jlg006728/electronic-design-contest/项目记忆.md

# 项目记忆

## 2026-07-25 V105 视频诊断修复上下文

- 当前活动工程仍为 `C:\Users\1\Desktop\ELECTRIC\mock_problem`，用户要求不修改活动 `empty.c`、不操作 CCS，只提供验证后的单文件备份。
- 当前诊断基线为 `ccs_project\medicine_car_2021f\backup_code\20260725_v104_first_junction_encoder_arm_empty.c`。
- 两段用户录像已复制到临时只读分析目录 `C:\Users\1\AppData\Local\Temp\codex_two_video_diag`，原视频保持不变。
- 诊断重点：V104 首路口在25 cm后允许任意单个10 ms帧的 `>=4` 路宽线触发，视频约30 fps无法观测所有10 ms瞬态；拟在V105中增加首路口约50 cm编码器武装、X4/X5同时有效和连续3个控制帧确认。

## 2026-07-08 靶纸变更：同心圆靶心 + 激光瞄准

- 新现场靶纸为白纸背景、红色/棕红色同心圆，顶部另有红色胶带；不能继续把“最大红色 blob 中心”当靶心，否则可能追到某段圆环或胶带。
- 推荐机械方案：激光笔固定在 PA14/PA17 二维云台的俯仰输出端，尽量与 OpenMV 镜头同高、同向、近距离并排，形成“摄像头看哪里，激光跟哪里”的同轴/近同轴结构；不要固定在车底盘或只固定在单独水平舵机上。
- 视觉优化方向：OpenMV 端保持现有 17 字节 UART 协议不变，输出 `cx/cy` 改为“同心圆靶心坐标”；当前优先识别最小有效红色圆环，其次才用霍夫同心圆，禁止回到最大红色 blob 策略；MSPM0 端继续按 `cx/cy` 闭环驱动双舵机，只收窄死区和降低近靶抖动。

## 2026-07-07 当前活动状态：OpenMV + 双舵机无电机测试

- 当前活动 CCS 文件：`C:\Users\1\Desktop\ELECTRIC\ele-car\empty.c`。
- 当前源码来源：`C:\Users\1\Desktop\电赛\ccs_project\openmv_test\20260705_171205_mspm0_openmv_static_aim_final_user_tuned.c`。
- 本次恢复时间戳副本：`C:\Users\1\Desktop\电赛\ccs_project\openmv_test\20260707_214537_restore_openmv_servo_no_motor_test.c`。
- 恢复前活动文件备份：`C:\Users\1\Desktop\电赛\ccs_project\openmv_test\20260707_214537_before_restore_openmv_servo_no_motor_empty.c`。
- 行为：只测试 OpenMV 串口回传与 PA14/PA17 双舵机追踪；电机禁用，PB4/STBY 保持 LOW。
- 接线：OpenMV P4 TX -> MSPM0 PA11 RX，OpenMV P5 RX <- MSPM0 PA10 TX，OpenMV GND/舵机 GND/MSPM0 GND 共地；PA14 水平舵机信号，PA17 俯仰舵机信号。
- 已执行 `gmake clean` + `gmake all` 编译通过；未自动烧录。

## 2026-07-08 当前活动状态：V23 A 点无线起步桥接测试优先版

- 当前活动 CCS 文件：`C:\Users\1\Desktop\ELECTRIC\ele-car\empty.c`。
- 当前时间戳源码：`C:\Users\1\Desktop\电赛\ccs_project\integration_test\20260708_202324_v23_a_start_gap_bridge_test_first.c`。
- 说明文件：`C:\Users\1\Desktop\电赛\ccs_project\integration_test\20260708_202324_v23_a_start_gap_bridge_test_first_readme.md`。
- 改前活动文件备份：`C:\Users\1\Desktop\电赛\ccs_project\integration_test\20260708_202324_before_v23_current_empty_backup.c`。
- 基底：V22 `20260707_212451_v22_b_stop_cda_prompt_full_line.c`。
- 新增：PB12/PB13/PB14/PB15 编码器输入、A 点无黑线启动桥接 `PHASE_START_GAP_BRIDGE=8U`、`g_start_gap_*` Watch 变量。
- 默认 `START_GAP_TEST_ONLY=1U`：首轮只测 A 点桥接和重捕线，不触发 B/C/D/A 任务点。桥接稳定后改为 `0U` 再测完整任务。
- 已执行 `gmake clean` + `gmake all` 编译通过；未自动烧录。

## 2026-07-07 报告材料状态：项目 AI 使用说明

- 主文件：`C:\Users\1\Desktop\电赛\设计报告_AI使用说明.md`。
- 当前推荐提交版本：`C:\Users\1\Desktop\电赛\设计报告_AI使用说明_20260707_222354_按反馈强化版.md`。
- 当前 PDF 版本：`C:\Users\1\Desktop\电赛\北京邮电大学校赛-蒋立果-设计报告.pdf`。
- 旧稿备份：`C:\Users\1\Desktop\电赛\设计报告_AI使用说明_20260707_220812_旧稿备份.md`。
- 过程简化版：`C:\Users\1\Desktop\电赛\设计报告_AI使用说明_20260707_220917_纪实简化版.md`。
- 当前版本重点：突出真实调试过程、人机协作、硬件问题、算法补偿、项目独立性、版本统计、已实现功能与未完成思路；已按用户反馈补充舵机 180 度限制下的分段换边预瞄方案、XDS110 调试器损坏导致专用场地验证不足的局限，以及后续每日夜间场地训练计划。

## 2026-07-07 当前集成状态：全程跟踪赛段预瞄偏置 V5

- 当前活动 CCS 文件：`C:\Users\1\Desktop\ELECTRIC\ele-car\empty.c`。
- 当前 MSPM0 源码：`C:\Users\1\Desktop\电赛\ccs_project\integration_test\20260707_145322_full_course_segment_aim_bias_v5.c`。
- 当前说明文件：`C:\Users\1\Desktop\电赛\ccs_project\integration_test\20260707_145322_full_course_segment_aim_bias_v5_readme.md`。
- MSPM0 改前备份：`C:\Users\1\Desktop\电赛\ccs_project\integration_test\20260707_145140_before_segment_aim_bias_empty.c`。
- 当前 OpenMV 脚本：`C:\Users\1\Desktop\电赛\ccs_project\openmv_test\20260707_144221_openmv_uart_stream_qvga_far_stable_v2.py`。
- 本版新增赛段预瞄：AB 正常/HOME；BC 丢目标时持续左偏 `2450us`；CD 丢目标时开始向右回到 HOME；DA 丢目标时持续右偏 `800us`。
- 当前赛段判断仍基于 `g_run_sample` 和 `MISSION_B/C/D/A` 采样点，尚未接入编码器距离。Watch 变量：`g_course_segment`、`g_segment_aim_x_us`。
- 已执行 CCS `gmake all` 编译通过；未自动烧录。

## 2026-07-07 当前集成状态：全程跟踪 + OpenMV QVGA 远距离稳定识别 V4

- 当前活动 CCS 文件：`C:\Users\1\Desktop\ELECTRIC\ele-car\empty.c`。
- 当前 MSPM0 源码：`C:\Users\1\Desktop\电赛\ccs_project\integration_test\20260707_144221_full_course_tracking_openmv_qvga_far_stable_v4.c`。
- 当前说明文件：`C:\Users\1\Desktop\电赛\ccs_project\integration_test\20260707_144221_full_course_tracking_openmv_qvga_far_stable_v4_readme.md`。
- MSPM0 改前备份：`C:\Users\1\Desktop\电赛\ccs_project\integration_test\20260707_144221_before_revert_openmv_qvga_far_stable_empty.c`。
- 当前 OpenMV 脚本：`C:\Users\1\Desktop\电赛\ccs_project\openmv_test\20260707_144221_openmv_uart_stream_qvga_far_stable_v2.py`。
- VGA 远距离版现场失败表现：OpenMV 红灯常亮、颜色异常、帧率卡、小车无法追踪。红灯在脚本中代表异常恢复，不是目标检测。
- 当前 V4 回到 QVGA 320x240，保留稳定帧率；通过适度放宽红色阈值、降低小目标门槛、增加宽高/密度过滤来改善远距离识别。
- MSPM0 同步回到 `IMG_WIDTH=320`、`IMG_HEIGHT=240`，并降低 `AIM_MIN_PIXELS=14U`，避免 OpenMV 识别到的小远目标被 MSPM0 丢弃。
- 已执行 OpenMV 脚本 `py_compile` 语法检查通过；CCS `gmake all` 编译通过；未自动烧录。

## 2026-07-07 当前集成状态：全程跟踪 + OpenMV VGA 远距离识别 V3

- 当前活动 CCS 文件：`C:\Users\1\Desktop\ELECTRIC\ele-car\empty.c`。
- 当前 MSPM0 源码：`C:\Users\1\Desktop\电赛\ccs_project\integration_test\20260707_143104_full_course_tracking_openmv_vga_far_red_v3.c`。
- 当前说明文件：`C:\Users\1\Desktop\电赛\ccs_project\integration_test\20260707_143104_full_course_tracking_openmv_vga_far_red_v3_readme.md`。
- MSPM0 改前备份：`C:\Users\1\Desktop\电赛\ccs_project\integration_test\20260707_143104_before_openmv_vga_far_detect_empty.c`。
- 当前 OpenMV 脚本：`C:\Users\1\Desktop\电赛\ccs_project\openmv_test\20260707_143104_openmv_uart_stream_vga_far_red_v1.py`。
- 本版优先解决“远一点 OpenMV 识别不到红色靶”：OpenMV 从 QVGA 改为 VGA，红色阈值增加远距离宽阈值，同时加入 blob 尺寸/密度过滤；MSPM0 同步 `IMG_WIDTH=640`、`IMG_HEIGHT=480`、`AIM_DEAD_X/Y=32/24`。
- 老师参考代码中没有直接可用的 OpenMV 视觉实现，本版借鉴其“传感器先稳定处理，再进入任务判断”的思路。
- 已执行 OpenMV 脚本 `py_compile` 语法检查通过；CCS `gmake all` 编译通过；未自动烧录。

## 2026-07-07 当前集成状态：全程跟踪主动搜索 V2

- 当前活动 CCS 文件：`C:\Users\1\Desktop\ELECTRIC\ele-car\empty.c`。
- 当前集成源码：`C:\Users\1\Desktop\电赛\ccs_project\integration_test\20260707_140926_full_course_tracking_active_search_v2.c`。
- 当前集成说明：`C:\Users\1\Desktop\电赛\ccs_project\integration_test\20260707_140926_full_course_tracking_active_search_v2_readme.md`。
- 改前备份：`C:\Users\1\Desktop\电赛\ccs_project\integration_test\20260707_140850_before_full_course_tracking_v2_empty.c`。
- V1 失败原因判断：V1 只是禁用 B/C/D/A 任务点，并没有重写全程运动追踪策略；原来的“转弯时云台不搜索”和“边缘目标拒绝追踪”在全程跟踪场景中过于保守。
- V2 改动：`AIM_X_DIVISOR=2`、`AIM_MAX_STEP_US=60`、`AIM_SEARCH_START_FRAMES=6U`、`AIM_SEARCH_STEP_US=35`、`FULL_TRACK_SEARCH_DURING_TURN=1U`、`FULL_TRACK_ACCEPT_EDGE_TARGET=1U`。
- 本版仍不做 B 点停车和 C/D/A 提示，目标是验证 OpenMV/云台在全程运行中能否更主动找回目标；已执行 CCS `gmake all` 编译通过；未自动烧录。

## 2026-07-07 当前集成状态：全程跟踪测试 V1

- 当前活动 CCS 文件：`C:\Users\1\Desktop\ELECTRIC\ele-car\empty.c`。
- 当前集成源码：`C:\Users\1\Desktop\电赛\ccs_project\integration_test\20260707_135432_full_course_tracking_only_v1.c`。
- 当前集成说明：`C:\Users\1\Desktop\电赛\ccs_project\integration_test\20260707_135432_full_course_tracking_only_v1_readme.md`。
- 改前备份：`C:\Users\1\Desktop\电赛\ccs_project\integration_test\20260707_135406_before_full_course_tracking_empty.c`。
- 当前推荐 OpenMV 脚本：`C:\Users\1\Desktop\电赛\ccs_project\openmv_test\20260706_163540_openmv_uart_stream_edge_guard_rot180.py`。
- 本版目标：先调试底盘循迹过程中的 OpenMV/双舵机全程追踪，暂不做 B 点停车、C/D/A 提示。
- 关键开关：`MISSION_ENABLE_B_AIM=0U`，`MISSION_ENABLE_POINT_PROMPTS=0U`。
- 本版仍保留全局运行超时停车和连续丢线停车保护；已执行 CCS `gmake all` 编译通过；未自动烧录。

## 2026-07-06 当前集成状态：B 点左预瞄 V3

- 当前活动 CCS 文件：`C:\Users\1\Desktop\ELECTRIC\ele-car\empty.c`。
- 当前集成源码：`C:\Users\1\Desktop\电赛\ccs_project\integration_test\20260706_220410_line_follow_b_aim_left_preset_v3.c`。
- 当前集成说明：`C:\Users\1\Desktop\电赛\ccs_project\integration_test\20260706_220410_line_follow_b_aim_left_preset_v3_readme.md`。
- 当前推荐 OpenMV 脚本：`C:\Users\1\Desktop\电赛\ccs_project\openmv_test\20260706_163540_openmv_uart_stream_edge_guard_rot180.py`。
- 本版用于修正 B 点找不到靶：B 点停车进入瞄准时，水平舵机先预置到 `MISSION_B_AIM_X_PRESET_US=2450U`，并清除旧循迹转弯状态、旧目标滤波和确认计数。
- 关键逻辑修正：B 点静态瞄准时 `aim_should_hold_for_chassis_turn()` 强制返回 false，避免停车后仍因残留 `g_turn_mode=1/2` 而禁止云台搜索目标。
- OpenMV 远距离抓不稳时，优先处理目标物面积、颜色阈值和 B 点预瞄方向；不要直接大幅降低 `MIN_RED_PIXELS/MIN_RED_AREA`，否则空场景误识别会更严重。
- 采购清单确认已有 LED/电阻/按键/电源模块，但没有明确采购蜂鸣器。声光提示当前只能先做“光”；若要“声”，建议新增有源蜂鸣器模块，接法为 `VCC -> 3.3V/5V(按模块)`, `GND -> 公共 GND`, `SIG -> 空闲 GPIO`，5V 或大电流蜂鸣器需加三极管/MOSFET 驱动。
- 已执行 CCS `gmake all` 编译通过；未自动烧录，烧录仍由用户手动完成。

## 2026-07-06 当前集成状态：稳定循迹 baseline + OpenMV/舵机

- 当前活动 CCS 文件：`C:\Users\1\Desktop\ELECTRIC\ele-car\empty.c`。
- 当前集成源码：`C:\Users\1\Desktop\电赛\ccs_project\integration_test\20260706_195125_stable_line_baseline_plus_openmv_servo.c`。
- 当前集成说明：`C:\Users\1\Desktop\电赛\ccs_project\integration_test\20260706_195125_stable_line_baseline_plus_openmv_servo_readme.md`。
- 用户指定基础：`C:\Users\1\Desktop\电赛\ccs_project\line_sensor_test\line_follow_sharp_turn_stable_baseline.c`。
- 循迹核心恢复为 baseline：`620/590` 基础 PWM、`430..850` 限幅、普通修正 `20/150`、急弯 `1800/8/380`、`LINE_CENTER_OFFSET=0`。
- 保留 OpenMV/舵机：`PA10/PA11` UART0，`PA14` 水平舵机，`PA17` 俯仰舵机，V9 丢目标搜索与边缘保护。
- 主循环仍为集成版 20ms 舵机节拍和约 90 秒运行时间，没有使用 baseline 原始约 12 秒阻塞测试循环。

## 2026-07-06 当前集成状态：V10 初始速度档

- 当前活动 CCS 文件：`C:\Users\1\Desktop\ELECTRIC\ele-car\empty.c`。
- 当前集成源码：`C:\Users\1\Desktop\电赛\ccs_project\integration_test\20260706_193630_line_follow_openmv_servo_v10_initial_speed.c`。
- 当前集成说明：`C:\Users\1\Desktop\电赛\ccs_project\integration_test\20260706_193630_line_follow_openmv_servo_v10_initial_speed_readme.md`。
- V10 是 V9 的降速版：保留 V9 OpenMV 丢目标搜索、边缘目标保护、舵机参数和 `LINE_CENTER_OFFSET=500`。
- 电机速度档：`PWM_LEFT_BASE_TICKS=605`、`PWM_RIGHT_BASE_TICKS=605`、`PWM_MIN_TICKS=430`、`PWM_MAX_TICKS=850`、`START_BOOST_SAMPLES=0`。
- 选择 `605/605` 的原因：早期稳定循迹基线为 `620/590`，平均速度约 `605`；当前机械/传感器中心已重新调过，先保持左右平衡，若现场偏转再单独微调左右 PWM。

## 2026-07-06 当前集成状态：V9 OpenMV 丢目标搜索

- 当前活动 CCS 文件：`C:\Users\1\Desktop\ELECTRIC\ele-car\empty.c`。
- 当前集成源码：`C:\Users\1\Desktop\电赛\ccs_project\integration_test\20260706_163540_line_follow_openmv_servo_high_torque_v9_lost_target_search.c`。
- 当前集成说明：`C:\Users\1\Desktop\电赛\ccs_project\integration_test\20260706_163540_line_follow_openmv_servo_high_torque_v9_lost_target_search_readme.md`。
- 当前推荐 OpenMV 脚本：`C:\Users\1\Desktop\电赛\ccs_project\openmv_test\20260706_163540_openmv_uart_stream_edge_guard_rot180.py`。
- V9 保留底盘居中参数：`LINE_CENTER_OFFSET=500`，暂不继续改该参数。
- V9 同步舵机参数：`SERVO_X_HOME_US=1600`、`SERVO_Y_HOME_US=1500`、`SERVO_X_MIN_US=350`、`SERVO_X_MAX_US=2650`、`SERVO_Y_MIN_US=500`、`SERVO_Y_MAX_US=2500`。
- V9 视觉行为：边缘目标拒绝直接追踪；目标丢失后先保持，急弯/丢线期间不扫，底盘恢复普通循迹后水平扫描找回目标；OpenMV 断链不再自动回 HOME。
- 新增观察状态：`g_aim_state=8` 边缘目标拒绝，`9` 丢目标搜索，`10` 底盘转弯保持。

## 2025 电赛 E 题小车

- 当前控制板：LP-MSPM0G3507。
- 电机驱动：TB6612，方向脚 `PB0/PB1/PB2/PB3`，`PB4` 为 `STBY`，PWM 为 `PA12/PA13`。
- 编码器：左轮 `PB12/PB13`，右轮 `PB14/PB15`。左轮前进计数为负，软件需取反；右轮前进计数为正。
- 当前 PWM 写入规则：逻辑占空比与 TIMG0 compare 反向，写入时使用 `compare = PWM_PERIOD - logical_duty_ticks`。
- 地面直行基准：`PWM_LEFT_BASE_TICKS = 665`，`PWM_RIGHT_BASE_TICKS = 635`，`PWM_CORR_LIMIT = 150`。
- 巡线红外当前有效接线：`S1/S2/S3/S4/S5/S6/S7 -> PB5/PB6/PB7/PA7/PA8/PB9/PB10`。
- `PA2~PA6` 在 LP-MSPM0G3507 板级默认不适合直接接杜邦线使用：官方原理图显示 `PA2-/PA3-/PA4-/PA5-/PA6-` 到 MCU 真实脚之间的 `R9/R10/R11/R15/R17` 为 `DNC`，且 MCU 端分别关联 `ROSC/LFXT/HFXT`。后续默认禁用这组脚，除非重新焊接并验证。
- `PA7` 不属于上述 DNC 晶振/ROSC 隔离组，当前作为巡线 S4 使用；若 PA7 异常，单独查排针/代码/接线，不和 PA2~PA6 混为一类。
- 当前稳定循迹基线：`C:\Users\1\Desktop\电赛\ccs_project\line_sensor_test\line_follow_sharp_turn_stable_baseline.c`。用户已验证圆角弯、S 弯、直角弯均可通过。

## 2026-06-29 校赛小车赛道题

- 新收到校赛题目 PDF：`D:\软件\xwechat_files\wxid_gdp9f9sm7a9u22_4c08\msg\file\2026-06\北邮2026电赛-小车赛道题目(1).pdf`。
- 新收到老师参考代码：
  - `D:\软件\xwechat_files\wxid_gdp9f9sm7a9u22_4c08\temp\RWTemp\2026-06\9e20f478899dc29eb19741386f9343c8\25E题底盘开源.zip`
  - `D:\软件\xwechat_files\wxid_gdp9f9sm7a9u22_4c08\temp\RWTemp\2026-06\9e20f478899dc29eb19741386f9343c8\24H题第四问开源.zip`
- 适配原则：不覆盖当前已验证循迹基线；先读题和参考代码，比较硬件、引脚、控制策略，再决定移植范围。
- 校赛路线文件：`C:\Users\1\Desktop\电赛\校赛研制路线.md`。
- 当前赛题优先级：先保底完成自动巡迹一圈停车、静止定点瞄准、A/B/C/D/A 联动，再做动态瞄准、绘制、四圈。
- 老师 25E 参考代码只借任务状态机/按键/蜂鸣器思想；灰度传感器、电机驱动、编码器参数不能直接搬到当前车。
- 下一步硬件/代码目标：新增 `PB11 START`、`PB8 MODE` 两个按键，做“按键启动版循迹”，保持现有循迹算法不变。
- 2026-07-02 舵机阶段最新状态：`PA3/PA4` 舵机方案作废；临时使用已验证可达的 `PA12` 做单舵机信号，舵机已确认可以正常动作。`PA12` 正式被 TB6612 `PWMA` 占用，只能作为独立测试脚，不能作为最终云台方案。
- 舵机供电当前可用测试法：TB6612 稳压板 `5V/GND` 只作为舵机电源，舵机信号仍由 MSPM0 输出；正式接双舵机/OpenMV 前必须做带载电压测试，并重新选择不与电机、巡线、UART、SWD 冲突的可达引脚。
- 2026-07-03 双舵机正式候选脚第一组：`PA14 -> X/水平舵机`，`PA17 -> Y/俯仰舵机`。循迹基线已验证运行正常，当前 `empty.c` 已再次恢复为 `PA14/PA17` 双舵机联动测试版并编译通过。
- 2026-07-03 双舵机 PA14/PA17 版发现软件卡死点：两个舵机同为 `1500us` 时旧代码会调用 `delay_us(0)`/`delay_cycles(0)`，导致 LED 只翻转一次后常亮、舵机不动。已生成修正版 `C:\Users\1\Desktop\电赛\ccs_project\servo_test\20260703_162351_dual_servo_pa14_pa17_no_zero_delay.c`，并更新活动工程 `empty.c`。
- 2026-07-03 双舵机最终候选脚已实测可用：`PA14 -> 水平舵机`，`PA17 -> 俯仰舵机`。OpenMV 当前测试使用 `PA10/PA11` UART0，测试代码保存为 `C:\Users\1\Desktop\电赛\ccs_project\openmv_test\20260703_162934_mspm0_openmv_full_selftest.c` 和 `20260703_162934_openmv_full_selftest.py`。
- 2026-07-03 OpenMV 自检已通过。下一阶段优先做静态“OpenMV 目标识别 + PA14/PA17 双舵机闭环瞄准”，暂不驱动电机。
- 2026-07-03 已生成静态闭环瞄准代码：`C:\Users\1\Desktop\电赛\ccs_project\openmv_test\20260703_204436_mspm0_openmv_servo_static_aim.c`。该版本使用 UART0 RX 中断接 OpenMV 帧，电机禁用，PA14/PA17 根据红色目标 `cx/cy` 温和追踪中心。
- 2026-07-03 OpenMV 静态瞄准版新增云台 HOME 机制：`PA14` 水平舵机、`PA17` 俯仰舵机上电后先回到 `SERVO_X_HOME_US/SERVO_Y_HOME_US`，当前默认 `1500/1500us`。普通三线舵机不能反读手动扭到的机械角度，后续需要通过 Watch 调整 `g_servo_x_home_us/g_servo_y_home_us` 找到正确回正脉宽，再固化进宏定义。
- 2026-07-03 OpenMV 当前为倒装安装，已新增 `20260703_213123_openmv_full_selftest_rot180.py`，通过 `sensor.set_hmirror(True)` + `sensor.set_vflip(True)` 等效 180 度旋转图像。MSPM0 舵机校准范围临时放宽到 `900..2100us`，当前默认 HOME 为 `X=1500us`、`Y=1250us`。
- 2026-07-03 OpenMV 云台校准：X 初始 `1500us` 已确认方向基本正确；Y 轴 HOME 改为 `750us` 起步。普通追踪下限 `SERVO_Y_MIN_US=750us`，但校准模式通过 `SERVO_Y_CALIB_MIN_US=0us` 允许继续向下探索，需现场避免舵机机械顶死。
- 2026-07-03 OpenMV 云台 HOME 已由现场校准固化为 `X=1500us`、`Y=580us`。当前 MSPM0 静态追踪测试版为 `20260703_214308_mspm0_openmv_servo_home_1500_580_track_test.c`，Y 轴正式追踪下限暂设 `500us`。
- 2026-07-03 OpenMV 静态追踪阶段发现一处调试开关风险：`g_servo_calibrate_enable=1` 会锁 HOME 并跳过追踪。当前正式追踪版 `20260703_214842_mspm0_openmv_track_ignore_calib_switch.c` 已改为忽略该开关并自动清零，避免校准模式遗留导致舵机不动。
- 2026-07-03 OpenMV/MSPM0 串口排查：现场出现 MSPM0 `g_omv_tx_requests` 增加但 `g_omv_rx_bytes=0`。已新增 OpenMV 主动串流版 `20260703_215935_openmv_uart_stream_rot180.py`，无需等待 MSPM0 命令，每约 100ms 主动从 UART3/P4 TX 发送颜色帧，用于隔离 P4->PA11 回传线/共地/跳线帽问题。
- 2026-07-04 OpenMV 追踪控制优化：当前最新静态追踪测试版为 `20260704_135927_mspm0_openmv_fast_stable_track.c` + `20260704_135927_openmv_uart_stream_fast_rot180.py`。改动包括 OpenMV 50ms 主动串流、MSPM0 关闭主动请求、坐标滤波、2 帧确认、小目标拒收、最大步长 45us、中心死区 20/16 像素。若目标越追越偏，优先改 `AIM_X_PULSE_SIGN/AIM_Y_PULSE_SIGN`，不要继续加速度。
- 2026-07-04 舵机机械方向改变并触及临界值后，当前 `empty.c` 已切回纯 HOME 校准版 `20260704_152456_mspm0_servo_home_recalibration.c`。默认 `X=1500/Y=1500`，校准范围 `500..2500us`，`g_aim_state=5`，不追踪 OpenMV。校准完成前不要使用追踪版。
- 2026-07-04 当前已从重新校准版切回 OpenMV 快速追踪版，HOME 固化为 `X=1500/Y=1500`。当前 MSPM0 文件 `20260704_153116_mspm0_openmv_fast_track_home_1500_1500.c`，OpenMV 端使用 `20260704_135927_openmv_uart_stream_fast_rot180.py`。

- 2026-07-04 OpenMV 停止/不亮灯的现场原因已确认：当时没有连接电池，仅 USB 供电导致掉电；不要继续按 OpenMV 脚本自停排查。当前 OpenMV + MSPM0 快速追踪版本保持 `HOME X=1500/Y=1500`，OpenMV 脚本为 `20260704_135927_openmv_uart_stream_fast_rot180.py`。左右追踪反向已在 MSPM0 端通过 `AIM_X_PULSE_SIGN=(-1)` 修正，Y 轴保持 `(-1)`。
- 2026-07-04 OpenMV 双舵机追踪进入平滑快速版：当前烧录文件 `C:\Users\1\Desktop\ELECTRIC\ele-car\empty.c`，时间戳源码 `20260704_160413_mspm0_openmv_smooth_fast_track_hold_loss.c`，OpenMV 脚本 `20260704_160413_openmv_uart_stream_smoother_fast_rot180.py`。核心策略是 OpenMV 25ms 主动串流，MSPM0 用 `g_servo_x/y_goal_us` 表示目标脉宽，实际 `g_servo_x/y_us` 每 20ms 平滑追向目标。`g_tracking_stop_reason` 用于判断停止原因：0 正常，1 帧超时，2 无目标，3 小目标过滤。普通三线 PWM 舵机不能靠代码实现左右各 360 度绝对位置控制。
- 2026-07-05 用户明确后续调试规则：Codex 只负责修改/生成代码并验证编译通过，不再自动烧录；烧录由用户手动完成。除非用户之后明确要求“帮我烧录/直接烧录”，否则不要运行 dslite/UniFlash 烧录命令。
- 2026-07-05 OpenMV/MSPM0 当前调试基线：MSPM0 活动工程仍为 `C:\Users\1\Desktop\ELECTRIC\ele-car\empty.c`，对应时间戳源码 `C:\Users\1\Desktop\电赛\ccs_project\openmv_test\20260705_145444_mspm0_openmv_joint_home_850_1500_link_diag.c`，HOME 为 `X=850us/Y=1500us`，`AIM_X_PULSE_SIGN=-1`、`AIM_Y_PULSE_SIGN=-1`，舵机运行限幅 `500..2500us`，并带 `g_diag_stage` 等诊断变量。OpenMV 端最新抗卡死脚本为 `C:\Users\1\Desktop\电赛\ccs_project\openmv_test\20260705_145746_openmv_uart_stream_watchdog_no_print_rot180.py`，说明文件为 `20260705_145746_openmv_watchdog_stream_readme.md`。后续继续遵守：Codex 只生成/编译验证代码，不自动烧录，除非用户明确要求直接烧录。
- 2026-07-05 OpenMV 卡死/舵机停动原因已确认：OpenMV `P4/UART3_TX` 接触不良。`P4` 接 MSPM0 `PA11/UART0_RX`，负责视觉结果回传。后续凡是出现 OpenMV 灯仍变化但 MSPM0/舵机不响应，优先检查 `P4`、`P5`、`GND` 接触和机械固定，再看 `g_omv_color_frame_count/g_omv_rx_bytes/g_diag_stage`，不要直接归因于 OpenMV 脚本卡死或供电问题。
- 2026-07-05 水平舵机左右范围不对称原因：当前 `SERVO_X_HOME_US=850U`，运行限幅 `500..2500us`，导致 HOME 左侧仅约 `350us`、右侧约 `1650us`。最终应机械调整水平舵机摆臂/云台，使 `1500us` 附近对应摄像头正前方，再使用对称软件范围。若不做机械调整，只能把 X 最大值限制到约 `1200us` 实现以 850us 为中心的窄范围对称，但会牺牲视野。
- 2026-07-05 15:24 当前 `C:\Users\1\Desktop\ELECTRIC\ele-car\empty.c` 已改为水平舵机 `SERVO_X_HOME_US=1500U` 的对称中位版，时间戳源码为 `C:\Users\1\Desktop\电赛\ccs_project\openmv_test\20260705_152451_mspm0_openmv_track_x_home_1500_symmetric.c`。X 轴软件范围仍为 `500..2500us`。现场下一步必须机械调整水平摆臂，使 OpenMV 镜头正前方对应 `1500us`，否则初始朝向会变化但这是预期现象。已编译通过，未自动烧录。
- 2026-07-05 17:03 当前 OpenMV 双舵机追踪版已临时删除“丢目标后慢慢回 HOME”逻辑。当前 `C:\Users\1\Desktop\ELECTRIC\ele-car\empty.c` 在没识别到目标时保持舵机最后位置，仅在长时间丢目标后重置坐标滤波；时间戳源码为 `C:\Users\1\Desktop\电赛\ccs_project\openmv_test\20260705_170304_mspm0_openmv_track_hold_when_target_lost.c`，说明文件为 `20260705_170304_hold_when_target_lost_readme.md`。已编译通过，未自动烧录。
- 2026-07-05 17:12 OpenMV 双舵机静态瞄准已进入用户现场调参最终版：当前活动文件为 `C:\Users\1\Desktop\ELECTRIC\ele-car\empty.c`，时间戳源码 `C:\Users\1\Desktop\电赛\ccs_project\openmv_test\20260705_171205_mspm0_openmv_static_aim_final_user_tuned.c`，说明文件 `20260705_171205_static_aim_final_user_tuned_readme.md`。关键参数：`SERVO_X_HOME_US=1600U`、`SERVO_Y_HOME_US=1500U`、`SERVO_X_MIN_US=800U`、`SERVO_X_MAX_US=2200U`、`SERVO_Y_MIN_US=500U`、`SERVO_Y_MAX_US=2500U`；丢目标后保持最后位置；已编译通过，未自动烧录。后续将该版本视为静态视觉瞄准基线。
- 2026-07-05 17:23 当前活动 `empty.c` 已切换为“循迹 + OpenMV 双舵机合并 V1”，时间戳源码 `C:\Users\1\Desktop\电赛\ccs_project\integration_test\20260705_172354_line_follow_openmv_servo_integration_v1.c`，说明文件 `20260705_172354_line_follow_openmv_servo_integration_v1_readme.md`。行为：上电云台回 HOME 后电机开始循迹，OpenMV 同时回传红色目标，PA14/PA17 云台追踪；运行约 90 秒停车，见线后连续丢线约 2 秒停车，启动无线时先直走找线。风险：舵机 PWM 仍是软件 20ms 脉冲，若循迹变差，下一版应考虑硬件舵机 PWM 或降低云台更新频率。已编译通过，未自动烧录。
- 2026-07-05 21:50 当前活动 `empty.c` 已切换为“循迹 + OpenMV 双舵机高扭矩合并 V2”，时间戳源码 `C:\Users\1\Desktop\电赛\ccs_project\integration_test\20260705_215010_line_follow_openmv_servo_high_torque_v2.c`，说明文件 `20260705_215010_line_follow_openmv_servo_high_torque_v2_readme.md`。V2 将电机基础 PWM 提高到 `720/690`，最小 PWM 提到 `520`，最大 PWM 提到 `1000`，并新增前 20 个控制周期约 400ms 的启动助推 `900/870`，变量 `g_start_boost_active` 可观察助推阶段。已编译通过，未自动烧录。
- 2026-07-05 21:55 当前活动 `empty.c` 为高扭矩合并 V3，时间戳源码 `C:\Users\1\Desktop\电赛\ccs_project\integration_test\20260705_215512_line_follow_openmv_servo_high_torque_v3_sharper_turn.c`。V3 只轻微加强急弯：`LINE_SHARP_ERROR=1600`、`LINE_SHARP_KP_DIVISOR=7`、`LINE_SHARP_CORR_LIMIT=430`；普通循迹参数不变以尽量保持直线稳定。已编译通过，未自动烧录。
- 2026-07-05 22:12 当前活动 `empty.c` 为高扭矩合并 V4“急弯降速受控版”，时间戳源码 `C:\Users\1\Desktop\电赛\ccs_project\integration_test\20260705_221203_line_follow_openmv_servo_high_torque_v4_controlled_turn.c`。V4 诊断依据：V2 在视频末端应右转却左转，V3 继续加强急弯导致原地打转；因此 V4 回到 V2 急弯参数，并新增急弯低速 `PWM_SHARP_LEFT_BASE_TICKS=620U`、`PWM_SHARP_RIGHT_BASE_TICKS=590U`、`PWM_SHARP_MAX_TICKS=850U`，普通/起步仍高扭矩。已编译通过且无警告，未自动烧录。
- 2026-07-05 22:22 当前活动 `empty.c` 为高扭矩合并 V5“直线基础平衡版”，时间戳源码 `C:\Users\1\Desktop\电赛\ccs_project\integration_test\20260705_222246_line_follow_openmv_servo_high_torque_v5_straight_balance.c`。V5 针对直线启动右偏，将普通基准 `720/690 -> 705/705`、启动助推 `900/870 -> 880/880`、急弯低速基准 `620/590 -> 605/605`。保留 V4 急弯降速受控策略。已编译通过，未自动烧录。
- 2026-07-05 22:32 当前活动 `empty.c` 为高扭矩合并 V6“红外输入下拉防悬空版”，时间戳源码 `C:\Users\1\Desktop\电赛\ccs_project\integration_test\20260705_223215_line_follow_openmv_servo_high_torque_v6_sensor_pulldown.c`。用户澄清 S5 异常来自传感器线松动，未改循迹方向；V6 仅将 7 路红外输入从 `DL_GPIO_RESISTOR_NONE` 改为 `DL_GPIO_RESISTOR_PULL_DOWN`，保留 V5/V4 其他策略。已编译通过，未自动烧录。每次拿起重放测试应按 RST，避免状态变量保留。
- 2026-07-06 15:58 当前活动 `empty.c` 为高扭矩合并 V7“加强普通居中纠偏版”，时间戳源码 `C:\Users\1\Desktop\电赛\ccs_project\integration_test\20260706_155859_line_follow_openmv_servo_high_torque_v7_center_correction.c`。针对前两圈可循迹但长期 S5 压线、第三圈直线偏出的问题，仅将普通纠偏 `LINE_KP_DIVISOR 20 -> 16`、`LINE_CORR_LIMIT 150 -> 190`，不改急弯/高扭矩/OpenMV。已编译通过，未自动烧录。
- 2026-07-06 16:08 当前活动 `empty.c` 为高扭矩合并 V8“S4/S5 中心偏置版”，时间戳源码 `C:\Users\1\Desktop\电赛\ccs_project\integration_test\20260706_160854_line_follow_openmv_servo_high_torque_v8_center_offset.c`。用户确认车身中心在 S4/S5 中间；V8 新增 `LINE_CENTER_OFFSET=500`，误差计算为 `(sum/count)-500`，使 S4+S5 同时压线时误差为 0。保留 V7/V6/V5/V4 其他策略。已编译通过，未自动烧录。
- 2026-07-07 15:16：全程 OpenMV 预偏转改为 V6 几何连续曲线。当前活动文件 `C:\Users\1\Desktop\ELECTRIC\ele-car\empty.c` 已编译通过，未自动烧录；时间戳源码为 `C:\Users\1\Desktop\电赛\ccs_project\integration_test\20260707_151637_full_course_geometric_preaim_curve_v6.c`，说明文件为 `C:\Users\1\Desktop\电赛\ccs_project\integration_test\20260707_151637_full_course_geometric_preaim_curve_v6_readme.md`。核心逻辑：A 点出发后云台左偏，保持到 BC 中点；之后按圈进度线性回正，到下一次 A 点面向正前方。OpenMV 稳定识别时做闭环追踪，丢目标时回到预偏转方向搜索。
- 2026-07-07 15:28：全程 OpenMV/小车任务升级为 V7 关键点停车强制校正。当前活动文件 `C:\Users\1\Desktop\ELECTRIC\ele-car\empty.c` 已编译通过，未自动烧录；时间戳源码为 `C:\Users\1\Desktop\电赛\ccs_project\integration_test\20260707_152852_course_point_stop_forced_aim_v7.c`，说明文件为 `C:\Users\1\Desktop\电赛\ccs_project\integration_test\20260707_152852_course_point_stop_forced_aim_v7_readme.md`。行为：B/C/D/下一次A 点按图纸 sample 估计到点，停车约 2s，并在停车入口强制设置云台水平角；停车期间 OpenMV 继续识别微调。重要限制：当前没有编码器闭环距离，点位仍由 `g_run_sample` 时间步估计，速度/电压/负重变化会导致停车点漂移。
- 2026-07-07 15:35：在 V7 关键点停车强制校正基础上加入 5V 有源蜂鸣器提示，形成 V8。当前活动文件 `C:\Users\1\Desktop\ELECTRIC\ele-car\empty.c` 已编译通过，未自动烧录；时间戳源码为 `C:\Users\1\Desktop\电赛\ccs_project\integration_test\20260707_153507_course_point_stop_buzzer_v8.c`，说明文件为 `C:\Users\1\Desktop\电赛\ccs_project\integration_test\20260707_153507_course_point_stop_buzzer_v8_readme.md`。蜂鸣器控制脚为 PB11 / `IOMUX_PINCM28`，推荐通过三极管/MOSFET 驱动 5V 有源蜂鸣器。鸣叫规则：上电1声，B点2声，瞄准稳定3声，C点4声，D点5声，A点1声，关键点停车未锁定目标则长响。
- 2026-07-07 15:44：用户实测 A->B 距离比地图多约 2/5，要求两版代码。已生成并编译通过：V9 不使用编码器、所有点位 sample 乘 `5/7`，文件 `C:\Users\1\Desktop\电赛\ccs_project\integration_test\20260707_153950_course_point_stop_buzzer_scaled_5over7_v9.c`，说明 `20260707_153950_course_point_stop_buzzer_scaled_5over7_v9_readme.md`；V10 使用编码器距离，文件 `C:\Users\1\Desktop\电赛\ccs_project\integration_test\20260707_154420_course_point_stop_buzzer_encoder_distance_v10.c`，说明 `20260707_154420_course_point_stop_buzzer_encoder_distance_v10_readme.md`。当前活动 `C:\Users\1\Desktop\ELECTRIC\ele-car\empty.c` 已切回 V9 并 clean rebuild 通过，方便先测 5/7 缩放版。V10 编码器接线使用 PB12/PB13/PB14/PB15，`ENCODER_EDGES_PER_CM=1471U` 只是按轮径估算，正式使用前必须现场校准。
- 2026-07-07 16:08：当前活动 `empty.c` 已更新为 V11，仍基于 V9 的 5/7 非编码器版本，不启用编码器。新预瞄策略：A->B->C->CD中点持续左偏，CD中点后回正到 A。关键参数：`COURSE_LEFT_HOLD_SAMPLE=559U`，`SERVO_X_MIN_US=300U`，`SERVO_X_MAX_US=2800U`，`COURSE_LEFT_TARGET_US=2750U`。时间戳源码：`C:\Users\1\Desktop\电赛\ccs_project\integration_test\20260707_160803_scaled_5over7_left_until_cd_mid_servo_wide_v11.c`，说明：`20260707_160803_scaled_5over7_left_until_cd_mid_servo_wide_v11_readme.md`。重要注意：`0us` 不是有效舵机脉宽，不能用来扩大角度；如果 2800us 导致顶死/抖动/发热，应回退到 `SERVO_X_MAX_US=2650U`、`COURSE_LEFT_TARGET_US=2550U`。
- 2026-07-07 16:22：当前活动 `empty.c` 已更新为 V13 主动预偏转修正版，仍为 5/7 非编码器版本。修正点：V12 只计算预瞄目标但未主动驱动舵机，导致 AB 段可能不左偏；V13 新增 `course_preaim_update_when_unlocked()`，未稳定锁定 OpenMV 目标时每帧驱动 `g_servo_x_us` 向课程预瞄角移动。保留 `COURSE_LEFT_HOLD_SAMPLE=559U`、`SERVO_X_MIN_US=350U`、`SERVO_X_MAX_US=2650U`、`COURSE_LEFT_TARGET_US=2550U`。源码：`C:\Users\1\Desktop\电赛\ccs_project\integration_test\20260707_162256_scaled_5over7_left_until_cd_mid_active_preaim_v13.c`，说明：`20260707_162256_scaled_5over7_left_until_cd_mid_active_preaim_v13_readme.md`。已编译通过，未自动烧录。
- 2026-07-07 16:45：当前活动 `empty.c` 已改为 V14，正式回到 V9 触发方式。V14 基于 `20260707_153950_course_point_stop_buzzer_scaled_5over7_v9.c`，只把回正起点从原 `330` 改为 `COURSE_LEFT_HOLD_SAMPLE=559U`，即 `0~559` 保持左偏，`559~913` 逐渐回正；保留 V9 的 `COURSE_PREAIM_STEP_US=35`、`COURSE_LEFT_TARGET_US=2550U` 和 `aim_search_for_lost_target()` 无目标触发预偏转方式，没有 V13 的 `course_preaim_update_when_unlocked()` 主动预偏转。源码：`C:\Users\1\Desktop\电赛\ccs_project\integration_test\20260707_164523_v9_trigger_left_until_cd_mid_v14.c`，说明：`20260707_164523_v9_trigger_left_until_cd_mid_v14_readme.md`。已编译通过，未自动烧录。
- 2026-07-07 16:58：当前活动 `empty.c` 已改为 V15。V15 基于 V14，按用户现场反馈将 ABCD 点位距离整体缩为当前 `4/5`：整圈 `COURSE_LAP_SAMPLES=731U`，左偏保持到 `COURSE_LEFT_HOLD_SAMPLE=447U`，B/C/D 点为 `162/366/528`，A 点等于整圈。AB 左偏速度保持 `COURSE_PREAIM_STEP_US=35`，新增右回速度 `COURSE_PREAIM_RETURN_STEP_US=70`，只在舵机向右回正时使用。源码：`C:\Users\1\Desktop\电赛\ccs_project\integration_test\20260707_165804_v15_shorter_distance_fast_return.c`，说明：`20260707_165804_v15_shorter_distance_fast_return_readme.md`。已编译通过，未自动烧录。
- 2026-07-07 17:11：当前活动 `empty.c` 已改为 V16。V16 不再尝试扩大左偏极限，保持 `COURSE_LEFT_TARGET_US=2550U`、`SERVO_X_MIN_US=350U`、`SERVO_X_MAX_US=2650U`；只把向右回正步长 `COURSE_PREAIM_RETURN_STEP_US` 从 `70` 提到 `140`。原因：用户现场确认左转约 180 度处是卡住状态，代码继续加脉宽会让舵机堵转，不能真正得到 270 度。若仍需要 270 度，必须重新安装舵机摆臂、确认舵机本体角度或更换 270 度舵机。源码：`C:\Users\1\Desktop\电赛\ccs_project\integration_test\20260707_171101_v16_faster_right_return_no_left_limit_push.c`，说明：`20260707_171101_v16_faster_right_return_no_left_limit_push_readme.md`。已编译通过，未自动烧录。
- 2026-07-07 17:15：当前活动 `empty.c` 已改为 V17，修正 V16 判断。用户确认水平舵机本体支持 270 度，左转不到 270 度是代码最大偏转范围限制。V17 将 `SERVO_X_MAX_US` 从 `2650U` 提到 `3050U`，`COURSE_LEFT_TARGET_US` 从 `2550U` 提到 `3000U`；保留 `SERVO_X_MIN_US=350U`、`SERVO_X_HOME_US=1600U`、`COURSE_PREAIM_STEP_US=35`、`COURSE_PREAIM_RETURN_STEP_US=140`。源码：`C:\Users\1\Desktop\电赛\ccs_project\integration_test\20260707_171538_v17_expand_left_servo_range.c`，说明：`20260707_171538_v17_expand_left_servo_range_readme.md`。已编译通过，未自动烧录。
- 2026-07-07 17:24：当前活动 `empty.c` 已回退到 V16 安全边界，时间戳源码 `C:\Users\1\Desktop\电赛\ccs_project\integration_test\20260707_172422_restore_v16_for_servo_strategy_review.c`，说明 `20260707_172422_restore_v16_for_servo_strategy_review_readme.md`。原因：用户重新判断水平云台机械可手动无限旋转，但程序控制可能只能稳定达到约 180 度。普通三线位置舵机无法靠软件“重置角度再相对转 90 度”，除非有编码器/角度反馈/机械复位；若是连续旋转舵机，则只能定时估算角度，精度不适合打靶。下一步建议先做水平舵机类型识别/扫角测试程序，再决定控制策略。
- 2026-07-07 17:34：当前活动 `empty.c` 已改为 V18 分段右侧预瞄曲线。核心策略：A/B 前保持左侧 `2550us`；B 点停车后继续走时，预瞄目标快速切到右侧接近 180 的 `700us`；B 到 CD 中点线性恢复到右 90 的 `1100us`；CD 中点到 D 再向右到 `700us`；D 到 A 回 HOME `1600us`。关键修正：`clamp_course_preaim_x()` 已允许右侧目标 `700us`，否则右侧预瞄会被旧 HOME~LEFT 限幅夹回 HOME。源码：`C:\Users\1\Desktop\电赛\ccs_project\integration_test\20260707_173433_v18_segmented_right_side_preaim.c`，说明：`20260707_173433_v18_segmented_right_side_preaim_readme.md`。已编译通过，未自动烧录。
- 2026-07-07 18:41：当前活动 `empty.c` 临时切换为 PB11 蜂鸣器隔离测试，不是循迹/OpenMV 集成代码。测试源码：`C:\Users\1\Desktop\电赛\ccs_project\buzzer_test\20260707_184130_pb11_buzzer_isolation_test.c`，说明：`20260707_184130_pb11_buzzer_isolation_test_readme.md`，改前 V18 备份：`C:\Users\1\Desktop\电赛\ccs_project\integration_test\20260707_184130_before_buzzer_test_current_v18_backup.c`。测试逻辑：PB11 高电平 1 秒、约 2kHz 方波 1 秒、低电平 1 秒循环，LED 同步提示。用于区分有源蜂鸣器、无源蜂鸣器、PB11 输出和外部驱动/接线问题。已编译通过，未自动烧录。
- 2026-07-07 19:05：当前活动 `empty.c` 已恢复为 V19 动态追踪集成版，来源为 V18 分段右侧预瞄，保留 PB11 蜂鸣器。蜂鸣器不响的真实原因已确认：正负极接反。V19 源码：`C:\Users\1\Desktop\电赛\ccs_project\integration_test\20260707_190540_v19_restore_dynamic_tracking_with_buzzer.c`，说明：`20260707_190540_v19_restore_dynamic_tracking_with_buzzer_readme.md`。已执行 `gmake clean` + `gmake all` 编译通过，未自动烧录。
- 2026-07-07 19:12：比赛场地确认中间直线段无黑线。当前活动 `empty.c` 已保持/回退为 V19，clean build 通过。不要使用未完成的 `20260707_191256_v20_line_gap_bridge_no_center_line.c`，该版开环桥接无法保证无线路段直线和对准。后续新场地正确方案应接入编码器：丢线进入桥接后用左右编码器差闭环保持直线，红外重新看到黑线并稳定若干帧后退出桥接。
- 2026-07-07 19:22：进一步确认：编码器桥接只能保证“沿进入桥接瞬间的航向走直”，不能单独保证“这条直线就是正确连接上下弯道的直线”。正确方案必须加入相位门控和入口姿态验证：只在预期断线窗口进入桥接，且进入前红外应显示弧线末端/边缘图案；桥接中用编码器差速保持直线；重新稳定捕到线后退出。当前活动 `empty.c` 仍为 V19，clean build 通过。
- 2026-07-07 19:26：当前活动 `empty.c` 已改为 V21 最终版编码器门控桥接，源码 `C:\Users\1\Desktop\电赛\ccs_project\integration_test\20260707_192609_v21_final_encoder_gated_gap_bridge.c`，说明 `20260707_192609_v21_final_encoder_gated_gap_bridge_readme.md`。V21 保留 V19 动态追踪/蜂鸣器/V18 分段预瞄，新增 PB12/PB13/PB14/PB15 编码器输入和无线路段桥接状态机。桥接只在 B/D 预期断线窗口且弧线末端边缘误差满足时进入；桥接中用左右编码器差闭环保持直线；红外稳定重捕线 3 帧后退出；超时 220 帧未捕线则交给丢线停车保护。已 clean build 编译通过，未自动烧录。
- 2026-07-07 20:00：当前活动 `empty.c` 临时切换为电机不动红外传感器静态测试程序，源码 `C:\Users\1\Desktop\电赛\ccs_project\line_sensor_test\20260707_200036_static_line_sensor_motor_off_test.c`，说明 `20260707_200036_static_line_sensor_motor_off_test_readme.md`，改前备份 `20260707_200036_before_sensor_static_test_current_backup.c`。该程序不初始化 PWM，PB0/PB1/PB2/PB3/PB4 全 LOW，TB6612 STBY LOW，电机不会动；用于在比赛场地检查 S1~S7 原始输入和黑线识别极性。已 clean build 编译通过，未自动烧录。
- 2026-07-07 21:24：当前活动 `empty.c` 已切换为 V22，基于 V19，假定全程有黑线，不考虑断线桥接。V22 按题目任务点调整：B 点停车；C/D/A 不停车，只声光提示。源码：`C:\Users\1\Desktop\电赛\ccs_project\integration_test\20260707_212451_v22_b_stop_cda_prompt_full_line.c`，说明：`20260707_212451_v22_b_stop_cda_prompt_full_line_readme.md`。已 clean build 编译通过，未自动烧录。
- 2026-07-09：OpenMV 视觉目标定位从“红色圆环颜色识别”切换为“黑色外框中心检测”。红色圆环现场颜色过淡、线条过细，颜色阈值不稳定；黑框方案已实测可用。当前 OpenMV 测试脚本为 `ccs_project/openmv_test/20260709_black_frame_center_test.py`，已烧录到 `E:\main.py`。成功反馈为 `best=blob`，中心约 `cx=131~141`、`cy=131~132`，帧率约 `57fps`。后续集成时优先让 OpenMV 回传黑框中心坐标给 MSPM0 云台控制。
- 2026-07-09：OpenMV 当前已升级为黑框中心 + UART 主动上报 + watchdog/异常自恢复集成版，脚本 `ccs_project/openmv_test/20260709_black_frame_uart_stream_watchdog.py` 已烧录到 `E:\main.py`。UART 17 字节帧协议保持原样，`TYPE_COLOR=3`、`FLAG_TARGET_DETECTED`、`cx/cy=-1` 未检测语义均不变；MSPM0 端原则上可沿用原 OpenMV 目标帧解析，只是 `cx/cy` 现在来自黑框四角平均中心而不是红色目标中心。当前 `ENABLE_DEBUG_PRINT=True` 便于现场观察，正式上车若担心 USB 打印开销可改回 `False`。
- 2026-07-09：黑框 UART 集成版已做泛化增强并重新烧录。主要改动：黑色阈值放宽、`find_rects()` 阈值降低、blob 合并距离增至 `30`、候选框尺寸/宽高比/密度范围放宽，新增 `GROUP` 多黑块组合兜底和 `TARGET_HOLD_FRAMES=8` 短时保持。调试输出新增 `hold=` 字段；若现场 `target=1` 但 `hold` 递减，说明当前靠上一帧目标临时保持。
## 2026-07-08 当前活动状态：V24 A 点无线桥接首测修正版

- 当前活动 CCS 文件：`C:\Users\1\Desktop\ELECTRIC\ele-car\empty.c`。
- 当前时间戳源码：`C:\Users\1\Desktop\电赛\ccs_project\integration_test\20260708_203751_v24_a_start_gap_direct_bridge_reacquire.c`。
- 当前说明文件：`C:\Users\1\Desktop\电赛\ccs_project\integration_test\20260708_203751_v24_a_start_gap_direct_bridge_reacquire_readme.md`。
- 基底：V23 A 点无线起步桥接测试版；V23 的基底是 V22 全线任务版。
- 当前目标：先解决 A 点起步完全看不到黑线时的桥接重捕线，不直接测试完整任务。
- 关键开关：`START_GAP_TEST_ONLY=1U`，B/C/D/A 任务点暂时关闭；`START_GAP_USE_ENCODER_BALANCE=0U`，编码器计数保留但暂不参与桥接控制。
- 状态提示：上电 1 声；进入 A 点无线桥接 2 声；成功重捕线 3 声。
- 新增相位：`PHASE_START_GAP_BRIDGE=8U` 表示无线桥接；`PHASE_START_GAP_ALIGN=9U` 表示重捕线后的短暂稳定；`PHASE_LINE_RUN=2U` 表示正常循迹。
- 编译状态：已执行 CCS `gmake clean` + `gmake all`，编译通过；未自动烧录。
## 2026-07-08 当前活动状态：V25 固定赛道混合控制 A 点捕线版

- 当前活动 CCS 文件：`C:\Users\1\Desktop\ELECTRIC\ele-car\empty.c`。
- 当前时间戳源码：`C:\Users\1\Desktop\电赛\ccs_project\integration_test\20260708_205429_v25_fixed_course_start_gap_capture.c`。
- 当前说明文件：`C:\Users\1\Desktop\电赛\ccs_project\integration_test\20260708_205429_v25_fixed_course_start_gap_capture_readme.md`。
- 修改前 V24 备份：`C:\Users\1\Desktop\电赛\ccs_project\integration_test\20260708_205429_before_v25_current_v24_backup.c`。
- 当前策略：固定赛道混合控制。无线段按赛道定制桥接，有线段用红外循迹纠偏，后续任务点逐步从 `g_run_sample` 切换为编码器里程。
- 当前第一目标：只验证 A 点无线起步、轻微右漂修正、捕线锁中心和进入普通循迹；`START_GAP_TEST_ONLY=1U` 仍保持开启。
- 新增状态：`PHASE_START_GAP_CAPTURE=9U`，用于看到黑线后低速捕线；只有中心锁定连续 5 帧后才进入 `PHASE_LINE_RUN=2U`。
- 当前关键参数：桥接 trim 为 `-8/+8`；捕线 PWM 为 `370/370`；中心锁定误差阈值为 `1200`；中心锁定帧数为 `5`。
- 编译状态：已执行 CCS `gmake clean` + `gmake all`，编译通过；未自动烧录。
## 2026-07-08 当前活动状态：V26 A 点桥接见线即循迹版

- 当前活动 CCS 文件：`C:\Users\1\Desktop\ELECTRIC\ele-car\empty.c`。
- 当前时间戳源码：`C:\Users\1\Desktop\电赛\ccs_project\integration_test\20260708_210707_v26_start_gap_any_sensor_reacquire.c`。
- 当前说明文件：`C:\Users\1\Desktop\电赛\ccs_project\integration_test\20260708_210707_v26_start_gap_any_sensor_reacquire_readme.md`。
- 修改前 V25 备份：`C:\Users\1\Desktop\电赛\ccs_project\integration_test\20260708_210707_before_v26_current_v25_backup.c`。
- 当前第一目标：A 点无线桥接到弯道入口后，只要任意红外传感器识别到黑线，立即切入普通循迹。
- 当前有效路径：`PHASE_START_GAP_BRIDGE=8U -> PHASE_LINE_RUN=2U`。
- 关键参数：`START_GAP_REACQUIRE_FRAMES=1U`，桥接 trim 仍为 `-8/+8`，`START_GAP_TEST_ONLY=1U`。
- 注意：V25 的 `PHASE_START_GAP_CAPTURE` 捕线代码暂时保留但不再由桥接入口触发；若 V26 验证成功，后续可清理该未使用路径。
- 编译状态：已执行 CCS `gmake clean` + `gmake all`，编译通过；未自动烧录。
## 2026-07-08 当前活动状态：V27 状态切换强制停 2 秒调试版

- 当前活动 CCS 文件：`C:\Users\1\Desktop\ELECTRIC\ele-car\empty.c`。
- 当前时间戳源码：`C:\Users\1\Desktop\电赛\ccs_project\integration_test\20260708_215716_v27_state_switch_hold_2s_debug.c`。
- 当前说明文件：`C:\Users\1\Desktop\电赛\ccs_project\integration_test\20260708_215716_v27_state_switch_hold_2s_debug_readme.md`。
- 修改前 V26 备份：`C:\Users\1\Desktop\电赛\ccs_project\integration_test\20260708_215716_before_v27_current_v26_backup.c`。
- 当前目标：让 A 点桥接、上电直接循迹、桥接重捕线进入循迹三个状态切换变得肉眼可见。
- 红外极性已现场确认：白底/白线 0V，黑线 3.3V，`LINE_BLACK_IS_HIGH=1` 正确。
- 新行为：状态切换时强制停车约 2 秒并播放区分蜂鸣。2 声表示进入桥接；4 声表示上电直接判断有线；3 声表示桥接重捕线进入普通循迹。
- 新 Watch：`g_state_switch_reason`、`g_state_switch_hold_event_count`、`g_state_switch_hold_frames_total`。
- 编译状态：已执行 CCS `gmake clean` + `gmake all`，编译通过；未自动烧录。
## 2026-07-08 当前活动状态：V28 状态切换调试清理版

- 当前活动 CCS 文件：`C:\Users\1\Desktop\ELECTRIC\ele-car\empty.c`。
- 当前时间戳源码：`C:\Users\1\Desktop\电赛\ccs_project\integration_test\20260708_220234_v28_state_switch_debug_cleanup.c`。
- 当前说明文件：`C:\Users\1\Desktop\电赛\ccs_project\integration_test\20260708_220234_v28_state_switch_debug_cleanup_readme.md`。
- 修改前 V27 备份：`C:\Users\1\Desktop\电赛\ccs_project\integration_test\20260708_220234_before_v28_current_v27_backup.c`。
- 当前有效底盘路径：A 点无线桥接 `PHASE_START_GAP_BRIDGE=8U`，任意红外看到黑线后立即进入普通循迹 `PHASE_LINE_RUN=2U`。
- 已清理：V25 遗留的 `PHASE_START_GAP_CAPTURE` 捕线状态和相关函数/变量，不再存在，避免后续误读。
- 状态切换提示：进入桥接停 2 秒响 2 声；上电直接有线停 2 秒响 4 声；桥接重捕线停 2 秒响 3 声；停车期间 PA15 LED 闪烁。
- 启动快照 Watch：`g_startup_line_valid_snapshot`、`g_startup_line_raw_mask_snapshot`、`g_startup_line_active_count_snapshot`、`g_startup_line_error_snapshot`。
- 编译状态：已执行 CCS `gmake clean` + `gmake all`，编译通过；未自动烧录。
## 2026-07-08 当前活动状态：V29 参考代码增强版

- 当前活动 CCS 文件：`C:\Users\1\Desktop\ELECTRIC\ele-car\empty.c`。
- 当前时间戳源码：`C:\Users\1\Desktop\电赛\ccs_project\integration_test\20260708_221546_v29_reference_enhanced_line_encoder.c`。
- 当前说明文件：`C:\Users\1\Desktop\电赛\ccs_project\integration_test\20260708_221546_v29_reference_enhanced_line_encoder_readme.md`。
- 修改前 V28 备份：`C:\Users\1\Desktop\电赛\ccs_project\integration_test\20260708_221546_before_v29_current_v28_backup.c`。
- 硬件接口保持不变：TB6612、7 路红外、编码器、OpenMV、舵机、蜂鸣器引脚均未改动。
- 参考代码学习点：25E 底盘代码使用 200Hz 定时任务、灰度多采样、编码器距离积分、任务状态机和电机速度 PID；直角弯由灰度触发、编码器距离和强制转向共同完成。
- 本版已移植低风险增强：红外 5 次采样 OR/AND/last 记录、黑线锁存、编码器累计前进量/左右差 Watch。
- 当前桥接触发：`g_line_valid != 0 || g_line_seen_latched != 0`，仍然是任意红外见黑线后进入普通循迹，但增加运动中短脉冲捕获能力。
- 新增 Watch：`g_line_raw_high_last_mask`、`g_line_raw_high_or_mask`、`g_line_raw_high_and_mask`、`g_line_seen_latched`、`g_line_seen_latch_frames`、`g_line_seen_event_count`、`g_encoder_avg_forward_total`、`g_encoder_diff_forward_total`。
- 编译状态：已执行 CCS `gmake clean` + `gmake all`，编译通过；未自动烧录。
## 2026-07-08 当前活动状态：V30 参考代码架构底盘重写版

- 当前活动 CCS 文件：`C:\Users\1\Desktop\ELECTRIC\ele-car\empty.c`。
- 当前时间戳源码：`C:\Users\1\Desktop\电赛\ccs_project\integration_test\20260708_223500_v30_reference_style_chassis_rewrite.c`。
- 当前说明文件：`C:\Users\1\Desktop\电赛\ccs_project\integration_test\20260708_223500_v30_reference_style_chassis_rewrite_readme.md`。
- 修改前 V29 备份：`C:\Users\1\Desktop\电赛\ccs_project\integration_test\20260708_223500_before_v30_current_v29_backup.c`。
- 当前策略：不再延续旧集成版补丁路线，底盘代码按 25E 参考代码思想重写。
- 当前控制模块：红外多采样、编码器累计前进量、底盘状态机、直接双电机差速 PWM、蜂鸣/LED 状态提示。
- 当前未包含：OpenMV 串口、PA14/PA17 舵机、B/C/D/A 任务点、视觉瞄准。它们暂时从底盘调试中隔离。
- 当前状态机：白底启动进 `PHASE_START_GAP_BRIDGE`；黑线启动进 `PHASE_LINE_RUN`；桥接重捕线后进 `PHASE_LINE_RUN`；循迹丢线后进 `PHASE_FORCE_TURN`；保护停车为 `PHASE_STOP`。
- 当前关键 PWM：`520/500` 普通循迹，`500/520` 桥接，`330..760` 限幅。若车速或转向不合适，优先调这些参数。
- 编译状态：已执行 CCS `gmake clean` + `gmake all`，编译通过且无警告；未自动烧录。
## 2026-07-08 输出规则更新：不再为每次代码修改生成 readme 文件

- 用户明确要求：后续每次代码修改后，不要再额外写 readme 文件。
- 保留规则：代码仍需生成时间戳源码副本，并替换当前 CCS 活动文件 `C:\Users\1\Desktop\ELECTRIC\ele-car\empty.c`。
- 改动说明、测试步骤、Watch 变量、蜂鸣含义和调参规则，直接在聊天回复中输出。
- 已存在的历史 readme 文件不删除，作为历史记录保留。
## 2026-07-09 当前底盘恢复基线

- 当前 CCS 活动文件：`C:\Users\1\Desktop\ELECTRIC\ele-car\empty.c`。
- 当前时间戳源码：`C:\Users\1\Desktop\电赛\ccs_project\integration_test\20260709_002220_v31_stable_chassis_rescue.c`。
- 当前目标：第一步只恢复稳定底盘，验证红外能变、电机能跑、A 点无黑线桥接后任意红外见黑线即可进入普通循迹。
- 当前版本不包含 OpenMV、舵机、ABCD 任务点、编码器距离层。
- 当前版本已编译通过，未自动烧录。
- 后续路线：V31 现场确认通过后，再做第二步编码器距离层；不要再直接整体重写底层。
## 2026-07-09 当前活动代码改为红外阈值测试

- 当前 CCS 活动文件：`C:\Users\1\Desktop\ELECTRIC\ele-car\empty.c`。
- 当前时间戳源码：`C:\Users\1\Desktop\电赛\ccs_project\integration_test\20260709_184549_v32_motor_off_line_threshold_test.c`。
- 当前版本用途：电机禁用，只测试 7 路红外 DO 和软件阈值。
- 当前红外软件判定：每路连续采样 9 次，至少 5 次为高电平才判定为黑线。
- 当前电机状态：PB4/STBY 低，PWM 为 0，小车不会运动。
- 注意：数字红外模块的真实黑白阈值在模块比较器/电位器上，代码只能做多采样判定，不能改变 DO 的硬件翻转点。
## 2026-07-09 红外模块当前极性

- 现场确认：红外模块 DO 为白色高电平、黑线低电平。
- 当前活动代码已改为：`LINE_BLACK_IS_HIGH=0`。
- 当前时间戳源码：`C:\Users\1\Desktop\电赛\ccs_project\integration_test\20260709_185819_v33_motor_off_line_polarity_invert.c`。
- 后续所有循迹/桥接/任务代码都应沿用该极性，否则会出现白底被当成黑线、黑线被当成白底的问题。
## 2026-07-09 红外最终约定：白亮黑灭

- 用户明确要求：红外传感器沿用硬件标准“白色亮、黑色灭”，后续只修改后面的循迹程序逻辑。
- 当前活动源码：`C:\Users\1\Desktop\电赛\ccs_project\integration_test\20260709_192943_v34_motor_off_sensor_raw_standard.c`。
- 当前 Watch 约定：
  - `g_s1~g_s7`：原始传感器高电平结果，白色为 1，黑线为 0。
  - `g_line_raw_mask`：原始白色/高电平掩码。
  - `g_black_line_mask`：反相后的黑线掩码，后续循迹算法应使用它。
- 后续循迹代码不要再要求“黑线亮”；应在算法内部使用 `g_black_line_mask` 或等价反相逻辑。
## 2026-07-09 当前活动代码：电机启用，黑线低电平循迹

- 当前活动文件：`C:\Users\1\Desktop\ELECTRIC\ele-car\empty.c`。
- 当前时间戳源码：`C:\Users\1\Desktop\电赛\ccs_project\integration_test\20260709_193152_v35_motor_enabled_black_low_line_follow.c`。
- 当前红外标准不变：`g_s1~g_s7` 白色为 1，黑线为 0。
- 当前循迹输入：`g_black_line_mask = (~g_line_raw_mask) & 0x7F`，即黑线低电平被反相后用于算法。
- 当前电机已启用，PB4/STBY 高，PWM 恢复 V31 稳定基线：左 620、右 590、最小 430、最大 850。
- 当前版本仍不包含 OpenMV、舵机、ABCD 任务点、编码器距离层。
## 2026-07-09 当前活动代码：V36 降速与桥接修偏

- 当前活动文件：`C:\Users\1\Desktop\ELECTRIC\ele-car\empty.c`。
- 当前时间戳源码：`C:\Users\1\Desktop\电赛\ccs_project\integration_test\20260709_200431_v36_slow_bridge_left_drift_fix.c`。
- 普通循迹 PWM：左 540、右 515、最小 380、最大 760。
- 白底/无线桥接 PWM：左 560、右 500，用于抵消白底启动固定左歪。
- 红外标准仍为白色 1、黑线 0；循迹算法使用 `g_black_line_mask`。
## 2026-07-09 当前活动代码：V37 低速减右偏

- 当前活动文件：`C:\Users\1\Desktop\ELECTRIC\ele-car\empty.c`。
- 当前时间戳源码：`C:\Users\1\Desktop\电赛\ccs_project\integration_test\20260709_201351_v37_slower_reduce_right_bias.c`。
- 普通循迹 PWM：左 500、右 485、最小 350、最大 700。
- 白底/无线桥接 PWM：左 520、右 485。
- 目的：相比 V36 进一步降速，并减小桥接阶段的右偏。
## 2026-07-09 当前活动代码：V38 重捕线不停车

- 当前活动文件：`C:\Users\1\Desktop\ELECTRIC\ele-car\empty.c`。
- 当前时间戳源码：`C:\Users\1\Desktop\电赛\ccs_project\integration_test\20260709_202319_v38_no_stop_reacquire_bc_connect.c`。
- 目的：改善 A/AB 白底桥接到 BC 有线段的衔接。
- 关键改动：桥接阶段看到黑线后不再原地停 2 秒，不再滴 3 声，直接进入 `PHASE_LINE_RUN` 并继续循迹。
- 速度沿用 V37：普通循迹左 500、右 485；桥接左 520、右 485。
## 2026-07-09 当前活动代码：V39 半速传感器验证

- 当前活动文件：`C:\Users\1\Desktop\ELECTRIC\ele-car\empty.c`。
- 当前时间戳源码：`C:\Users\1\Desktop\电赛\ccs_project\integration_test\20260709_203216_v39_half_speed_right_bias_sensor_check.c`。
- 普通循迹 PWM：左 250、右 242、最小 180、最大 350。
- 白底/无线桥接 PWM：左 245、右 250，用于低速下纠正桥接右偏。
- 当前目的：先用半速确认经过黑线时红外是否会灭/`g_sx_high_count` 是否下降；若仍不变，问题更可能在模块阈值、传感器高度/角度、黑线反射率或车身实际压线位置。

## 2026-07-09 当前活动代码：V40 历史红外 + 编码器桥接 + OpenMV 舵机循迹测试

- 当前 CCS 活动文件：`C:\Users\1\Desktop\ELECTRIC\ele-car\empty.c`。
- 当前时间戳源码：`C:\Users\1\Desktop\电赛\ccs_project\integration_test\20260709_205326_v40_history_encoder_openmv_line_test.c`。
- 修改前备份：`C:\Users\1\Desktop\电赛\ccs_project\integration_test\20260709_205326_before_v40_history_encoder_openmv_line_test_empty.c`。
- 当前版本仍只测试循迹，不包含 ABCD 任务点；已加入 OpenMV UART0 与 PA14/PA17 双舵机并行追踪。
- 红外标准保持不变：白色为高电平/1/灯亮，黑线为低电平/0/灯灭；算法内部使用 `g_black_line_mask = (~g_line_raw_mask) & 0x7F`。
- 新增三帧红外历史：`g_line_history0/1/2` 与 `g_line_history_or_mask`。桥接阶段只要历史窗口内出现可用黑线位，即进入循迹。
- 循迹退出条件改为当前帧无可用黑线：`g_line_detect_mask == 0`，然后回到桥接阶段。
- 关键保护：7 路红外全部熄灭不再当作“完美居中黑线”，而是 `g_sensor_all_low_abnormal=1`，连续出现会保护停车，防止拿起小车后轮子疯转。
- 桥接阶段启用编码器差速修偏，沿用方向约定：左轮前进量取反，右轮前进量为正；修正量看 `g_encoder_diff_forward_total` 与 `g_start_gap_encoder_correction`。
- 编译状态：已执行 CCS clean build + build，编译通过且无 C 代码警告；未自动烧录。
## 2026-07-09 当前活动代码：V45 编码器 PI 无线桥接直行

- 当前 CCS 活动文件：`C:\Users\1\Desktop\ELECTRIC\ele-car\empty.c`。
- 当前时间戳源码：`C:\Users\1\Desktop\电赛\ccs_project\integration_test\20260709_220609_v45_encoder_pi_bridge_stronger_turn.c`。
- 当前阶段目标：只测底盘循迹、A/AB 无黑线桥接、重捕黑线、OpenMV/PA14/PA17 舵机并行追踪；暂不包含 B/C/D/A 任务点。
- 红外最终标准保持不变：白色为高电平/1/灯亮，黑线为低电平/0/灯灭；循迹算法内部使用 `g_black_line_mask = (~g_line_raw_mask) & 0x7F`。
- 无黑线桥接稳定结论：今后默认使用编码器闭环维护直行，不再把左右 PWM 相等当作直行依据。V45 使用每帧编码器增量差做快速修正、累计左右里程差做慢速修正，并加入小幅右偏补偿。
- V45 桥接关键参数：`START_GAP_LEFT_TRIM_TICKS=-8`、`START_GAP_RIGHT_TRIM_TICKS=8`、`START_GAP_ENCODER_DELTA_KP_DIV=2`、`START_GAP_ENCODER_DISTANCE_KI_DIV=64`、`START_GAP_ENCODER_LIMIT=95`、`START_GAP_ENCODER_SLEW_LIMIT=18`。
- V45 循迹转弯增强：`LINE_KP_DIVISOR=16`、`LINE_CORR_LIMIT=190`、`LINE_SHARP_KP_DIVISOR=6`、`LINE_SHARP_CORR_LIMIT=450`。
- 编译状态：2026-07-09 22:06 已 clean build + build 通过，未自动烧录。
## 2026-07-09 当前活动代码：V46 编码器 PID 桥接 + 黑线脉冲入口

- 当前 CCS 活动文件：`C:\Users\1\Desktop\ELECTRIC\ele-car\empty.c`。
- 当前时间戳源码：`C:\Users\1\Desktop\电赛\ccs_project\integration_test\20260709_222223_v46_encoder_pid_pulse_line_entry.c`。
- 当前版本用途：底盘循迹测试 + A/AB 无黑线桥接 + 重捕黑线 + OpenMV/PA14/PA17 舵机并行追踪；暂不包含 B/C/D/A 任务点。
- 直行桥接当前采用 PID 意义下的三项：
  - P：左右累计前进距离差。
  - I：累计距离误差的慢补偿。
  - D：每帧左右编码器增量差。
- 红外入线当前采用双层 mask：
  - `g_line_detect_mask`：9 次采样多数判定，较稳，用于正常循迹位置计算。
  - `g_line_entry_mask`：多数判定 OR 黑线脉冲捕获，用于桥接阶段快速切入循迹。
- 现场已知问题处理方向：若传感器模块灯能响应但小车不进循迹，优先检查 `g_line_entry_mask/g_line_black_pulse_mask` 逻辑，不要先怀疑红外硬件。
- 编译状态：2026-07-09 22:22 已 clean build + build 通过，未自动烧录。
## 2026-07-09 当前活动代码：V47 确认入线 + PID 桥接

- 当前 CCS 活动文件：`C:\Users\1\Desktop\ELECTRIC\ele-car\empty.c`。
- 当前时间戳源码：`C:\Users\1\Desktop\电赛\ccs_project\integration_test\20260709_223358_v47_confirmed_line_entry_pid_bridge.c`。
- 当前版本用途：底盘循迹测试 + A/AB 无黑线桥接 + 确认重捕黑线 + OpenMV/PA14/PA17 舵机并行追踪；暂不包含 B/C/D/A 任务点。
- V47 入线原则：多数判定直接有效；单次脉冲只作为候选，必须最近 4 帧至少 2 帧出现才允许切入循迹。
- V47 LED/蜂鸣语义：桥接 LED 灭并响 2 声；确认入线 LED 常亮并响 3 声；假脉冲候选不响不亮；保护停车长响一次。
- V47 桥接右偏补偿：`START_GAP_LEFT_TRIM_TICKS=-20`、`START_GAP_RIGHT_TRIM_TICKS=20`，编码器 PID 输出限幅为 `130`，斜率限制为 `14`。
- 编译状态：2026-07-09 22:33 已 clean build + build 通过，未自动烧录。
## 2026-07-09 当前活动代码：V48 启动白底假黑过滤

- 当前 CCS 活动文件：`C:\Users\1\Desktop\ELECTRIC\ele-car\empty.c`。
- 当前时间戳源码：`C:\Users\1\Desktop\电赛\ccs_project\integration_test\20260709_224405_v48_startup_false_black_filter_debounced_line.c`。
- 当前版本用途：底盘循迹测试 + A/AB 无黑线桥接 + 启动白底假黑过滤 + 确认重捕黑线 + OpenMV/PA14/PA17 舵机并行追踪；暂不包含 B/C/D/A 任务点。
- V48 新增核心变量：
  - `g_line_start_ignore_mask`：启动白底上被稳定误判为黑线的传感器位。
  - `g_line_effective_detect_mask`：过滤启动假黑后的真实导航黑线位。
  - `g_line_exit_missing_count`：循迹状态下连续无有效黑线计数。
- 当前入线原则：不再用单帧 `g_line_detect_mask` 直接切入循迹；必须经过 effective mask 和 4 帧/2 帧确认。
- 当前出线原则：循迹状态下连续 3 帧 `g_line_effective_detect_mask=0` 才退出，避免单帧假出线；同时能避免启动假黑位让车永远不出线。
- 编译状态：2026-07-09 22:44 已 clean build + build 通过，未自动烧录。
## 2026-07-10 当前活动代码：V49 红外极性修正版

- 当前 CCS 活动文件：`C:\Users\1\Desktop\ELECTRIC\ele-car\empty.c`。
- 当前时间戳源码：`C:\Users\1\Desktop\电赛\ccs_project\integration_test\20260710_205311_v49_correct_sensor_polarity_suspend_reject.c`。
- 当前已由 Watch 确认物理极性：白底 DO 低，黑线 DO 高，悬空 7 路全高；代码使用 `SENSOR_HIGH_IS_WHITE=0` 归一化为软件层白色=1、黑线=0。
- V49 有效线宽限制为 1~4 路；7 路黑线判定为悬空异常，连续 3 帧后停车。
- 白底发现 S5 物理输入稳定为高，启动时只允许忽略 1 个稳定异常位；后续仍需单独复测 S5 模块/接线。
- 板上版本确认变量：`g_firmware_version=49`。
- 当前编译通过，未自动烧录。
## 2026-07-10 智能灰度阵列与云台机械选型约束

- 2025 E题官方要求巡迹和电机控制必须由 TI MSPM0 完成。允许智能灰度阵列作为传感器前端，但 MSPM0 必须接收原始/校准后的通道数据并自行计算线位置、PID和电机输出。
- 灰度阵列推荐规格：8 路连续原始灰度值、3.3V 逻辑、I2C 优先、更新率≥100Hz、板宽与 1.8cm 黑线匹配、具有 M2/M3 安装孔和公开孔距尺寸。
- OpenMV 已占用 UART0 PA10/PA11，因此新灰度阵列优先选择 I2C；正式接线前需在 MSPM0G3507 可达引脚中重新分配，继续避开 LaunchPad 上 PA2~PA6 DNC 组。
- 水平轴：180°位置舵机仅适合基础/有限角度任务；270°位置舵机可作为低改造成本升级；普通 360°连续旋转舵机不适合定位。完整多圈连续瞄准需要绝对角度反馈并考虑滑环防止线缆缠绕。垂直轴通常继续使用 180°位置舵机即可。
- 机械安装优先采用可调长孔支架、尼龙隔柱和 M2/M3 螺钉；禁止直接钻传感器 PCB。总体外形含传感器前伸和云台，不得超过 25cm×15cm×25cm。
## 2026-07-10 新增器件采购建议

- 无线桥接增强：推荐增加 GY-521 MPU6050，用于短时 Z 轴角速度/航向保持；编码器继续负责左右轮速度和距离。MPU6050 不是绝对航向传感器，长时间积分会漂移。
- 调试显示：可选 0.96 英寸 SSD1306 I2C 128×64 OLED，3.3V 逻辑、4 针、带安装孔；比赛控制不得依赖显示屏。
- MPU6050 地址通常为 0x68/0x69，OLED 通常为 0x3C，可与智能灰度阵列共用 I2C，前提是地址不冲突、所有上拉接 3.3V，并降低 OLED 刷新频率。
## 2026-07-10 灰度阵列替代路线

- 无 MCU 阵列是合规且可优先采用的方案。
- 最优先：8 路模拟 AO + 74HC4051 + MSPM0 ADC；次选：QTR-8RC 类 RC 时间型阵列；不推荐仅有 8 路 DO 的比较器阵列作为最终方案。
- 可用数字引脚候选：沿用 PB5/PB6/PB7/PA7/PA8/PB9/PB10，并补充 PB8；正式配置前仍需检查 SysConfig 和其他任务模块冲突。

## 2026-07-10 水平连续旋转升级约束

- 水平轴优先选择“PWM 速度控制 + 0~3.3V 绝对角度反馈”的磁编码连续旋转舵机，可继续使用 PA14 输出 PWM，并另占 1 个可达 ADC 引脚读取反馈。
- 最终推荐舵机为飞特 `FB5317M-360`：4~8.4V、17.5kg·cm@7.4V、60RPM、25T/5.9mm 输出、0~3.3V 对应 0~360°绝对角度反馈；MSPM0 负责环形角误差外环。
- 最终推荐滑环为 `SRC022A-12`：22mm 带法兰帽式滑环、12 路、每路 2A。滑环置于转台中心，水平舵机偏置后用 1:1 GT2 同步带驱动；不要把帽式滑环直接套在舵机轴上。
- 旋转台使用两个 `6805-2RS`（25×37×7mm）轴承承担载荷，滑环不能承重；传动必须保持 1:1，使平台绝对角与舵机单圈反馈一致。现有 MG90S 小型支架不能直接安装标准尺寸 40mm 级舵机。

## 2026-07-14 八路灰度板正式接线

- 已购实物：亚博/Yahboom `YB-MYX05-V1.0` 无 MCU 八路数字灰度板，接口 `5V/AD2/AD1/AD0/OUT/GND`。
- 正式引脚：`AD0->PB5`、`AD1->PB6`、`AD2->PB7`、`OUT->PA7`；旧七路独立传感器退出，`PA8/PB9/PB10` 释放。
- 地址 `AD2 AD1 AD0=000..111` 对应 `X1..X8`。安装定义为 X1 最左、X8 最右，中心位于 X4/X5 之间。
- 模块用稳定 5V 供电并全系统共地；OUT 连接 PA7 前必须实测高电平，接近 5V 时使用 10kΩ/20kΩ分压。
- `PB11` 当前只用于有源蜂鸣器，不再作为 START 按键；外接按键暂不启用。
- 当前 V49 不兼容该复用板；下一代码任务是电机禁用的 8 通道扫描与极性/顺序测试。

## 2026-07-15 当前任务：八路灰度板隔离测试

- 固定接线：`AD0->PB5`、`AD1->PB6`、`AD2->PB7`、`OUT->PA7`。
- 测试阶段电机、PWM、舵机、OpenMV控制和蜂鸣器全部禁用，仅使用 PA15 LED 与 CCS Watch 观察。
- 上电时 X1~X8 全部置于白底，先自动建立白底基准；随后逐个用黑线遮挡 X1~X8，期望相对基准变化 mask 每次只出现对应一位。
- 当前 V50 源码：`C:\Users\1\Desktop\电赛\ccs_project\line_sensor_test\20260715_152540_v50_gray8_mux_motor_off_test.c`；活动文件已替换为该版本，`g_firmware_version=50`。
- V50 已 clean build 通过且零警告，未自动烧录。关键 Watch：`g_gray_test_state`、`g_gray_raw_high_mask`、`g_gray_white_baseline_mask`、`g_gray_changed_from_white_mask`、`g_gray_unstable_mask`、`g_gray_x1..g_gray_x8`、`g_gray_x1_high_count..g_gray_x8_high_count`。

## 2026-07-15 蜂鸣器极性更新

- 当前蜂鸣器改为三针低电平触发模块：`VCC->3.3V`、`I/O->PB11`、`GND->公共GND`。
- 软件统一使用 `LOW=响、HIGH=关闭`；初始化和所有安全停车/禁用代码必须让 PB11 保持 HIGH，不能再用 LOW 表示关闭。
- 建议 I/O 到 3.3V 加 10kΩ 上拉；模块已带驱动，不再串 330Ω 直驱蜂鸣器。
- 当前活动代码已更新为 V51：`C:\Users\1\Desktop\电赛\ccs_project\line_sensor_test\20260715_171632_v51_gray8_mux_motor_off_low_active_buzzer_safe.c`，clean build 通过且零警告，未烧录。

## 2026-07-15 下一阶段：八路灰度低速循迹

- 新灰度板隔离测试已由用户确认效果很好，下一版本可启用TB6612和电机。
- 首版仅测试低速直行接线、重捕线、八路加权位置和急弯/丢线找回；继续禁用OpenMV、舵机、任务点和编码器闭环。
- 继续要求上电时八路全部位于白底，以建立输出极性无关的白底基准。
- 当前V52：`C:\Users\1\Desktop\电赛\ccs_project\line_sensor_test\20260715_202553_v52_gray8_low_speed_line_follow.c`，活动empty.c已替换，clean build通过且零警告，未烧录。
- V52仅启用八路灰度和电机，基础PWM左500/右470；先架空验证左右差速方向，再落地短赛道测试。
- V52现场反馈小车完全不动，首要软件嫌疑是500/470低于负重车辆起转阈值。下一版采用0.4秒760/720启动增力，随后回到历史稳定620/590。
- 当前V53：`C:\Users\1\Desktop\电赛\ccs_project\line_sensor_test\20260715_204132_v53_gray8_start_boost_line_follow.c`，活动empty.c已替换，clean build通过且零警告，未烧录。

## 2026-07-15 LaunchPad独立供电修正

- USB连接时车辆运行且X6正常，USB断开时车辆不启动且X6常亮，已确认是目标板独立3.3V供电/地参考问题，不是灰度模块或V53需要CCS。
- TI官方外部供电入口为J11/3V3。正式接线：稳定3.3V接J11/3V3，GND共地；灰度板继续用稳定5V。
- 外部3.3V与USB调试同时使用时必须拔掉J101中的3V3跳帽，保留GND/NRST/SWDIO/SWCLK，防止两个3.3V源并联。
- 接入前实测外部3V3和J11均为约3.25~3.35V；若TB6612 3V3仍约2.6V，改用独立稳定3.3V模块。

## 2026-07-15 控制电源确定为LM2596

- 新增LM2596，固定调为3.30V，专门给LaunchPad J11/3V3供电；输入来自2S电池7.4V。
- 接线：电池->LM2596 IN；LM2596 OUT+->J11/3V3，OUT-->J11/GND；TB6612 3V3 OUT不再接LaunchPad。
- 外部3.3V工作时拔掉J101的3V3跳帽。空载及带载输出都必须保持约3.25~3.35V。

## 2026-07-15 晨间交接入口

- 仓库根目录新增 `lwx7月16晨必看.md`，作为下一位队员7月16日早晨接手续作的第一阅读入口。
- 第一行固定要求先理解实物接线；文档已包含当天完整关键对话、最终供电修正、代码版本和下一步实测顺序。

## 2026-07-16 独立上电实测结论

- LM2596 外部 3.3V 接入后，无 USB 时若保留 J101 的 NRST 跳帽，目标板不运行；拔掉 NRST 跳帽后 PA15 开始闪烁且电机启动。
- 已确认本车独立运行时必须同时断开 J101 的 `3V3` 与 `NRST`。需要 CCS 调试时，再接回 NRST/SWDIO/SWCLK，并继续保持 3V3 跳帽断开，避免两个 3.3V 电源并联。
- 仅从 J11 注入 3.3V 不会产生开发板 5V 排针电压。灰度板若把 5V 接开发板，在无 USB 时会断电不亮。
- 灰度板正式供电恢复为稳定独立 5V：`TB6612 5V OUT -> 灰度板 5V`，灰度板 GND、LM2596 OUT-、LaunchPad GND、TB6612 GND 必须共地；接入前先实测该 5V 输出。
- 流程简化候选：J101 的 `3V3` 与 `NRST` 永久拔掉，只保留 `GND、SWDIO、SWCLK`；烧录时目标板仍由 LM2596 供电，USB只连接XDS110数据线。NRST断开后的 CCS 烧录能力需要先做一次验证。

## 2026-07-16 V54 半速编码器直行与循迹方向修正

- 当前活动代码升级为 V54：`C:\Users\1\Desktop\ELECTRIC\ele-car\empty.c`。
- 时间戳源码：`C:\Users\1\Desktop\电赛\ccs_project\line_sensor_test\20260716_151953_v54_gray8_half_speed_encoder_straight_corrected_steering.c`。
- 直行基础 PWM 从左620/右590降为左右310，约为原速度一半；启动增力改为左右440、持续约0.16秒。
- 白底桥接恢复 PB12/PB13 左编码器和 PB14/PB15 右编码器闭环，左右基础命令相同，由 PID 差速修正固定绕圈。
- 修正灰度循迹转向符号：X1位于左、X8位于右；黑线在右侧时应提高左轮、降低右轮，黑线在左侧时相反。
- 桥接超时由5秒延长到10秒，以抵消速度减半后的行驶距离下降。OpenMV、舵机、任务点仍禁用。
- CCS clean build及修改后增量build均通过，零警告；未自动烧录。

## 2026-07-16 V55 仅小幅提速

- 当前活动代码：`C:\Users\1\Desktop\ELECTRIC\ele-car\empty.c`；时间戳源码：`C:\Users\1\Desktop\电赛\ccs_project\line_sensor_test\20260716_153722_v55_gray8_slight_speed_increase.c`。
- 仅修改速度：普通左右 PWM `310 -> 340`，启动增力左右 PWM `440 -> 480`；其余编码器、灰度、循迹和状态机逻辑与 V54 完全一致。
- 编译、链接通过且零警告，未自动烧录。

## 2026-07-16 V56 恢复 V53 逻辑并取中间速度

- 用户已把活动 `empty.c` 恢复为能运行的 V53；V54/V55 在实车上均低于起转阈值，不能作为当前控制基底。
- V56严格沿用当前V53的灰度、状态机和电机控制逻辑，只调整PWM速度参数。
- 普通PWM取V53与V55逐侧平均：左480、右465；启动增力左620、右600；PWM下限295、上限705。
- 当前活动文件：`C:\Users\1\Desktop\ELECTRIC\ele-car\empty.c`；时间戳源码：`C:\Users\1\Desktop\电赛\ccs_project\line_sensor_test\20260716_154319_v56_gray8_mid_speed_between_v53_v55.c`。
- 编译、链接通过且零警告，未自动烧录。

## 2026-07-16 V57 向 V55 低速侧加权

- 仓库V33为电机禁用测试版，因此按用户实际意图使用V53和V55计算。
- V57继续保持V53控制逻辑，只把速度改为 `(V53+2*V55)/3`：普通左433/右423，启动左573/右560，PWM范围250~657。
- 当前活动文件：`C:\Users\1\Desktop\ELECTRIC\ele-car\empty.c`；时间戳源码：`C:\Users\1\Desktop\电赛\ccs_project\line_sensor_test\20260716_171110_v57_gray8_v55_two_thirds_weighted_speed.c`。
- 编译、链接通过且零警告，未自动烧录。

## 2026-07-16 V58 循迹方向与幅度修正

- 保持V57已能起步的全部速度参数不变。
- 修正差速方向：黑线在右侧时提高左轮并降低右轮；黑线在左侧时降低左轮并提高右轮。
- 普通修正由除数22/限幅130改为除数36/限幅70；急弯修正由除数8/限幅340改为除数14/限幅180，整体约降低一半。
- 当前活动文件：`C:\Users\1\Desktop\ELECTRIC\ele-car\empty.c`；时间戳源码：`C:\Users\1\Desktop\电赛\ccs_project\line_sensor_test\20260716_172232_v58_gray8_correct_direction_gentle_correction.c`。
- 编译、链接通过且零警告，未自动烧录。

## 2026-07-17 V59 出弯直线恢复

- V58弯道已基本正常，问题集中为出弯后继续向右转圈。
- V59保持有效黑线状态下的普通/急弯增益不变；直行基础PWM由左433/右423改为左右428，启动增力由左573/右560改为左右566，平均速度基本不变。
- X4/X5中心区域连续确认2帧后清空最后转弯误差，防止出弯后短暂丢线继续沿旧方向转弯。
- 丢线找回前10帧保留原180限幅，11~25帧降为100，之后降为45；正常检测到弯道黑线时仍使用原V58参数。
- 当前活动文件：`C:\Users\1\Desktop\ELECTRIC\ele-car\empty.c`；时间戳源码：`C:\Users\1\Desktop\电赛\ccs_project\line_sensor_test\20260717_104654_v59_gray8_turn_exit_straight_recovery.c`。
- 编译、链接通过且零警告，未自动烧录。

## 2026-07-17 新增可用硬件：MPU6050

- 团队现有一块MPU6050，可用于Z轴偏航角速度测量和短时航向保持。
- 预定用途是辅助解决出弯持续转圈、直线方向保持和无线桥接，不替代八路灰度路径定位。
- MPU6050无磁力计，积分航向会漂移；必须先静止标定零偏，并只在短时直线/出弯阶段作为融合修正量。
- 实物确认为GY-521类八针MPU-6050板；首测接线定为 `PA0-SDA`、`PA1-SCL`、`3.3V-VCC`、公共GND、`AD0-GND`，其余引脚暂不连接。

## 2026-07-17 V60 MPU6050电机禁用测试

- 当前活动 `empty.c` 已临时替换为MPU6050独立测试；历史V59循迹源码保持在时间戳文件中。
- V60源码：`C:\Users\1\Desktop\电赛\ccs_project\mpu6050_test\20260717_111641_v60_mpu6050_motor_off_test.c`。
- 使用硬件I2C0：PA0=SDA、PA1=SCL、100kHz；LaunchPad要求J4 OFF、J19 1:2、J20 1:2。
- 电机STBY和全部方向/PWM保持LOW，舵机/OpenMV/灰度禁用；读取WHO_AM_I、配置正负500dps量程，静止500样本标定Z轴零偏，20ms更新角速度和积分航向。
- clean build通过且零警告，未自动烧录。

## 2026-07-17 V61 接受实测MPU6500身份

- 模块WHO_AM_I实测为0x70，确认是MPU6500兼容芯片而非严格0x68的MPU6050。
- V61同时接受0x68和0x70；新增 `g_mpu_device_type`：1=MPU6050，2=MPU6500兼容。
- 当前活动文件：`C:\Users\1\Desktop\ELECTRIC\ele-car\empty.c`；时间戳源码：`C:\Users\1\Desktop\电赛\ccs_project\mpu6050_test\20260717_112923_v61_mpu6050_mpu6500_compatible_motor_off_test.c`。
- 编译、链接通过且零警告，未自动烧录。

## 2026-07-17 V62 灰度+MPU出弯融合

- 当前活动代码由V61独立测试切换为V62融合测试；V59弯道循迹参数和速度保持不变。
- V62源码：`C:\Users\1\Desktop\电赛\ccs_project\integration_test\20260717_113845_v62_gray8_mpu_turn_exit_fusion.c`，活动文件：`C:\Users\1\Desktop\ELECTRIC\ele-car\empty.c`。
- 有效急弯继续仅由灰度控制；X4/X5中心确认后启动30帧短时航向保持；中心直线持续加入Z轴角速度阻尼；完全丢线超过10帧后加入角速度阻尼，抑制沿最后弯道方向画圆。
- 当前安装方向实测左转Z轴为正、右转为负；控制符号据此设置为正角速度产生右转制动、负角速度产生左转制动。
- MPU初始化或运行通信失败时自动退化为V59线控，不阻止车辆运行。
- clean build通过且零警告，未自动烧录。

## 2026-07-17 V63 三帧灰度历史+MPU反向制动

- V63保留V62全部有效线弯道参数，不采用统一提高8%的建议。
- 连续维护当前/前1帧/前2帧灰度mask与误差；两帧均位于右侧X5~X7后全灭，触发短时左向制动；两帧均位于左侧X2~X4后全灭，触发短时右向制动。
- 制动至少3帧，MPU可用时在Z轴角速度回到正负3deg/s附近结束，最长15帧；MPU不可用时8帧结束。结束后清除旧转弯误差并启动短时航向保持。
- 当前活动文件：`C:\Users\1\Desktop\ELECTRIC\ele-car\empty.c`；时间戳源码：`C:\Users\1\Desktop\电赛\ccs_project\integration_test\20260717_120452_v63_gray_history_mpu_turn_exit_brake.c`。
- 编译、链接通过且零警告，未自动烧录。

## 2026-07-17 V64 单变量降低出弯制动力

- V63实车证明反向制动有效，但回正略过冲。V64只将 `TURN_EXIT_BRAKE_CORR_TICKS` 从50降到35，其他参数和逻辑全部不变。
- 当前活动文件：`C:\Users\1\Desktop\ELECTRIC\ele-car\empty.c`；时间戳源码：`C:\Users\1\Desktop\电赛\ccs_project\integration_test\20260717_121544_v64_turn_exit_brake_strength_35.c`。
- 编译、链接通过且零警告，未自动烧录。
## 2026-07-17 当前阻塞：X6 常亮与底盘不启动

- 当前应优先排查灰度板供电、公共地、`PB6 -> AD1`、NRST 和 `PB4/STBY`，暂不继续优化循迹参数。
- X6 的复用地址为 `AD2 AD1 AD0 = 101`；`PB6/AD1` 失效会使扫描地址异常并可能长期落在 X6。
- V64 的白底基线保护会在八路不一致时主动禁止电机，因此小车不动不等于 PWM 参数错误。
## 2026-07-17 最新硬件结论

- `NRST-GND=0.8V` 且 PA15 不闪等价于 MCU 未退出复位，是当前底盘不动的直接原因。
- X6 提高传感器高度后恢复，当前先按安装高度/阈值问题处理，不再把它与 MCU 不启动混为一个故障。
- 2026-07-17：NRST 与 J11/3V3 均已恢复 3.3V，但 PA15 仍为 0；V64 首次 PA15 提示位于 MPU 初始化/校准之后，排障时必须先隔离 MPU/I2C，再判断固件未启动。
- 2026-07-17：CCS 实测 `g_mpu_state=4,g_mpu_error=1,g_i2c_error_count=1`，说明 MPU 缺失时的降级代码已执行；后续不能再把 PA15 不亮直接归因于 I2C 卡死，必须以暂停后的 Call Stack 和状态变量为准。
- 2026-07-17：CCS工作区存在两套工程。当前权威工程是 `ELECTRIC\ele-car`；`empty_LP_MSPM0G3507_nortos_ticlang` 仍是2026-07-10的V48旧工程。调试必须选择新增的 `ele-car-current-clean`，防止打开V64源码却加载V48产物。
- 2026-07-17：`ele-car-current-clean` 已成功建立调试会话；当前固件身份以V64专有变量/源码路径和`ele-car.out`确认。`g_firmware_version`被链接器移除，当前不可用于Watch验证。
- 2026-07-17：旧V48能响能转仅证明硬件可用；它上电立即鸣叫并进入桥接。当前V64静音且带八路统一基线硬门禁，X6高度异常很可能令其`STOP_REASON_BASELINE_INVALID`永久停车。
- 2026-07-17 V65：权威活动文件恢复为基于V64的 `20260717_150653_v65_gray_baseline_degraded_boot_diag.c`。启动PA15闪3次+蜂鸣1声；灰度允许混合白底基线，但必须至少7路稳定且X4/X5均稳定。编译和安全复审通过，未烧录。
- 2026-07-17硬件根因：5V灰度板OUT直接进入Standard GPIO PA7，超过普通GPIO`VDD+0.3V`限制并通过钳位结构反向供电3.3V轨/LM2596。正式接回前必须增加OUT电平转换/分压并处理AD0~2跨电源域与上电时序。

## 2026-07-17 V66 出弯后闭环右修正约5度

- 当前活动源码：`C:\Users\1\Desktop\ELECTRIC\ele-car\empty.c`；时间戳源码：`C:\Users\1\Desktop\电赛\ccs_project\integration_test\20260717_164118_v66_v64_turn_exit_right_bias_5deg.c`；两者SHA256一致。
- V66严格基于实车调好的V64分支：`TURN_EXIT_BRAKE_CORR_TICKS=0`、`TURN_EXIT_HOLD_FRAMES=30`，未合并V65灰度启动诊断逻辑。
- 成功结束出弯制动后，以当时航向减`5000mdeg`作为右转目标，MPU闭环修正；误差容差`500mdeg`，最大持续30帧（约600ms），初始差速约25 ticks、限幅35 ticks。
- 重新看到任意有效黑线时立即取消右修正，并在同一控制帧恢复灰度循迹；MPU不可用或运行中失效时退化为原V64线控恢复；若前级制动因超时结束，不启动5度右修正。
- `g_turn_mode=4`表示右修正阶段。关键Watch：`g_turn_exit_right_bias_active`、`g_turn_exit_right_bias_frame_count`、`g_turn_exit_right_bias_stop_reason`、`g_turn_exit_right_bias_error_mdeg`、`g_turn_exit_right_bias_correction`、`g_turn_exit_heading_target_mdeg`。
- clean/incremental build均通过且零警告，map确认新增状态变量进入最终`ele-car.out`；未自动烧录。

## 2026-07-17 V67 关闭5度右偏并防止旧误差持续打转

- V66实车出现持续向右打转回归。当前活动源码已切换为V67：`C:\Users\1\Desktop\ELECTRIC\ele-car\empty.c`；时间戳源码：`C:\Users\1\Desktop\电赛\ccs_project\integration_test\20260717_171841_v67_disable_right_bias_spin_guard.c`。
- `TURN_EXIT_RIGHT_BIAS_ENABLE=0`，暂时关闭独立5度右偏，保留V64灰度、MPU和出弯制动主体逻辑。
- 出弯制动无论正常结束还是超时结束，均清零`g_line_last_nonzero_error`并取消航向保持；无线时先直行，检测到有效黑线后同帧恢复灰度循迹，防止沿旧右转误差持续画圆。
- `FIRMWARE_VERSION=67`；两份源码SHA256均为`BDBDEC55C5DD1569FCE2FF53ED42D6AF55CC597AFBD00245D7BCACE90D26E88E`。编译链接通过且零警告，未自动烧录。

## 2026-07-17 V68 基于V64的三帧出弯确认

- V67关闭5度右偏时同时取消了V64原有30帧MPU航向保持，实车重新出现出弯后向右偏转；截图对应V64能直行的关键是保留该航向保持。
- 当前活动源码改为V68：`C:\Users\1\Desktop\ELECTRIC\ele-car\empty.c`；时间戳源码：`C:\Users\1\Desktop\电赛\ccs_project\integration_test\20260717_172944_v68_v64_three_frame_turn_exit_confirm.c`。
- V68从V64结构重新建立，保持`TURN_EXIT_BRAKE_CORR_TICKS=0`和`TURN_EXIT_HOLD_FRAMES=30`；不包含V66固定5度右偏。
- 第1帧八路均未看到黑线时只根据前两帧mask和MPU方向锁存出弯候选；只有连续3帧`g_gray_changed_count==0`才确认并启动出弯处理。期间出现任意非零通道，包括7~8路异常，立即取消候选。
- 新增Watch：`g_turn_exit_candidate_direction`、`g_turn_exit_candidate_lost_count`、`g_turn_exit_candidate_confirm_count`、`g_turn_exit_candidate_cancel_count`。
- clean build和最终增量build通过且零警告，独立静态复审通过；两份源码SHA256为`03DFF3ABAC57979DBE40FFB00F30D845FC69E69725954F0DC7A4402CE609C9D7`，未自动烧录。

## 2026-07-17 V69 极小直行左修正

- V68实车仅剩直线极轻微右偏。V69只把基础PWM从左/右`428/428`改为`427/429`，平均值仍为428，等效静态correction为-1 tick，用极小左修正抵消机械差速。
- 出弯三帧确认、`BRAKE_CORR=0`、30帧MPU航向保持和全部灰度逻辑均未修改。
- 当前活动源码：`C:\Users\1\Desktop\ELECTRIC\ele-car\empty.c`；时间戳源码：`C:\Users\1\Desktop\电赛\ccs_project\integration_test\20260717_174411_v69_v68_minimal_straight_left_trim.c`。
- 编译链接通过且零警告，独立复审确认修正方向正确；两份源码SHA256为`4C090C1D33CEA5751DFFAD06AA5307E99248F5BDA43086CCC7271E99427D20F7`，未自动烧录。

## 2026-07-17 用户最终手调V69与下一阶段方向

- 用户提供的当前实车手调源码SHA256为`1B787E32D9D9A0AC1441428BDF46017A8ACDA7120E20FDE28D40E1C93F43002C`，关键参数：基础PWM左425/右429，启动563/566，`TURN_EXIT_CONFIRM_LOST_FRAMES=5`，`TURN_EXIT_HOLD_FRAMES=28`，`TURN_EXIT_BRAKE_CORR_TICKS=0`。
- 当前能基本循迹，但连续稳定3圈仍困难：偶发过早出弯会偏右、过晚出弯会偏左，出弯后的直线本身基本稳定。该现象说明仅靠灰度全灭帧数无法稳定确定车头是否完成转角。
- 下一阶段推荐固定赛道三传感器融合：灰度负责有线贴线；陀螺仪以每个弯道入口为零点测局部转角并主判出弯；编码器测局部里程、确定赛道区段并作合理性门控。所有角度和里程在每段重置，不做跨多圈无限积分。

## 2026-07-17 V70 半圆出弯角度/编码器标定日志

- 赛题图确认赛道由两段对称半圆和两段直线/虚线组成，每个半圆理论转角为180度。因实车编码器脉冲/厘米和成功出弯局部角尚未标定，V70先采集数据，不改变电机控制。
- V70严格以用户手调V69为基底，保留基础PWM425/429、启动563/566、全灭确认5帧、航向保持28帧、制动差速0。
- 编码器输入：PB12/PB13左A/B，PB14/PB15右A/B；仅计数和记录，不参与PWM。左轮前进计数取反、右轮前进计数为正，沿用已验证约定。
- 最多记录16个弯道：入口、首次全灭候选、确认出弯时的帧号、yaw、局部yaw差、左右编码器局部增量和候选取消次数。状态0=未用、1=弯道进行、2=候选等待、3=已确认出弯。
- 当前活动源码：`C:\Users\1\Desktop\ELECTRIC\ele-car\empty.c`；用户原始手调备份：`20260717_205654_v69_user_final_tuned_input.c`；V70时间戳源码：`20260717_210605_v70_turn_angle_encoder_calibration_logger.c`。
- 最终SHA256为`AFB2CA5C878EADE10E13E00C2602CD534E5EDC8B4E801447BFF45A7532C88CCB`。clean/incremental build通过且零警告，map确认日志符号和`GROUP1_IRQHandler`进入最终映像；未自动烧录。

## 2026-07-17 V70实车回归与V71恢复基线

- V70实车表现显著劣化：启动后加速阶段逐渐右偏，首次进弯位置后移，首次出弯转弯过多，直线右偏明显，无法完成一圈。该结果不可接受，V70标记为禁止继续实车使用。
- 最强原因是编码器A相双边沿GPIO中断提高了主循环实际周期，而控制仍把每帧固定当作20ms：启动20帧、出弯5帧、航向保持28帧均被拉长；MPU积分也固定乘`GRAY_MAIN_LOOP_MS=20`，与真实采样间隔失配。
- V71已恢复用户手调V69控制基线，只修改顶部版本说明和`FIRMWARE_VERSION=71`，没有编码器初始化、中断使能、日志数组或ISR。
- 当前活动源码：`C:\Users\1\Desktop\ELECTRIC\ele-car\empty.c`；时间戳源码：`C:\Users\1\Desktop\电赛\ccs_project\integration_test\20260717_215527_v71_restore_user_v69_no_encoder_logger.c`。
- 两份源码SHA256为`FFA15450DCEBE00DE1A281AF3A2DFEEBAF3BDFED3757D8BDFF4E10DC18C9540B`。clean build与独立复审通过，未自动烧录。

## 2026-07-17 V71弯道单侧摆动代码结论

- X4/X5同时压线时权重为-500和+500，平均误差严格为0；线控不输出转向，只剩基础PWM425/429和可能的MPU修正，因此代码把它视为“居中”，但不是左右轮等PWM。
- 当前基础PWM425/429等效-2 tick轻微左修正，用于抵消直线机械右偏；不存在固定右偏常量。
- 但中心锁定时无条件启用MPU角速度阻尼，即使车辆正在合法右弯。右转角速度为负时，阻尼输出负correction，等效向左抑制右转；车会先沿切线离开弧线，待黑线落到X5/X6后再由正线误差大幅向右扳回，形成单侧摆动。
- 全灭后的前4帧仍按`g_line_last_nonzero_error`继续原方向急弯；当前两段半圆均为右弯且退出前常见X5/X6，因此`TURN_EXIT_CONFIRM_LOST_FRAMES=5`会表现为隐式继续右转约80ms，第5帧才切换到出弯处理。
- 以上两项都会影响灰度板离开弧线的空间位置与车头切线方向，是出弯早晚不稳定的重要软件原因。

## 2026-07-17 V72 固定赛道半圆/无线段航向融合

- V72以V71用户手调基线为底，保留PWM425/429、启动563/566、全灭5帧、保持28帧和制动差速0；未启用编码器或GPIO中断。
- 固定行驶方向为A-B-C-D-A，两段半圆均为顺时针右转。B/D处中心稳定重捕后记录入口yaw，目标航向固定为入口yaw-180度。
- 弯道中禁用直线用MPU角速度阻尼，右弯前馈以每帧2 ticks渐进到12 ticks；灰度误差仍可双向覆盖前馈。
- 全灭5帧只作防抖。局部右转角不足165度时继续小幅右转；达到165度后停止沿最后误差继续右转，并由精确180度目标闭环完成出弯。
- 无线直线段持续保持180度目标，至少运行25帧且中心稳定后才允许建立下一半圆入口；gap最大300帧，curve全灭等待最大180帧，避免复用普通100帧丢线停车。
- MPU运行中掉线会原子清理curve/gap/feedforward/candidate/brake状态并退回V71线控。最终独立审查无CRITICAL/HIGH问题。
- 当前活动源码：`C:\Users\1\Desktop\ELECTRIC\ele-car\empty.c`；时间戳源码：`C:\Users\1\Desktop\电赛\ccs_project\integration_test\20260717_224008_v72_fixed_course_semicircle_gap_heading_fusion.c`；SHA256为`AB38CAE4C2358CE8846ECC782821AC26C64A50641C5849EACB4F8A789ED68E0D`。编译通过，未烧录。
## 2026-07-18 MPU补线后车辆左偏的诊断结论

- 当前活动源码仍为V72结构，用户已手调基础PWM为`429/429`、启动PWM为`566/566`；本轮只分析，不修改源码或烧录。
- 此前MPU有一根线脱落时，`g_mpu_link_ok`很可能为0，车辆实际长期运行的是无MPU降级路径；补线后才首次真正启用弯道/无线段融合，不能把此前实车效果视为MPU控制已验证。
- A点启动桥接阶段代码只输出固定左右PWM，不把`g_mpu_control_correction`加入电机命令。因此补线后A点立即左偏，优先排查PA0/PA1与PB0/PB1混接、3.3V/GND变化、倒灌/压降、左电机方向线受影响，不先归因于陀螺仪PID。
- V72右弯正常状态应为`g_curve_active=1`，此时直线用MPU角速度阻尼被禁用，且`g_curve_feedforward_correction`应渐进到正12。若实车右弯仍持续左偏，应确认实际固件、曲线状态、Z轴方向和静止零偏。
## 2026-07-18 当前阻塞点：V72未从桥接进入循迹

- 实测`g_phase`始终为8；当前车辆并未执行循迹和MPU弯道融合，右弯异常首先是开环桥接未退出，不应继续调陀螺仪增益。
- `8 -> 2`仅由`g_gray_line_valid`连续2帧触发。若`g_line_entry_confirm_count>=2`但`g_phase`仍为8，则实际加载固件/调试符号与当前源码不一致；否则按灰度原始mask到有效线mask逐级排查。
## 2026-07-18 新灰度板防损坏接入规范

- `AD0/AD1/AD2`是灰度板数字输入，MSPM0的3.3V输出在灰度板5V正常供电时通常不会因未串电阻而烧毁模块；建议PB5/PB6/PB7各串1k~4.7k，主要用于限制误接、热插拔和模块未上电时的倒灌电流。
- 灰度板OUT不得直连PA7。推荐`OUT--10k--采样点--20k--GND`，采样点再经1k串联到PA7；20k可用两个10k串联。接PA7前必须实测采样点在所有状态下不超过3.6V。
- 最安全流程：独立确认5V供电和模块OUT黑白变化；再接AD地址线；再搭分压并离线测采样点；最后接PA7并先运行电机禁用测试。禁止带电插拔，禁止模块未供电时保留信号线。
## 2026-07-18 灰度板AD0实测发生5V域倒灌

- 新证据：LM2596空载/断开灰度时为3.3V；连接灰度板后被抬高到4.1V；只拔掉AD0即恢复3.3V，重新连接AD0又升至4.1V。
- 这不是负载压降，而是灰度板5V域经AD0/PB5向MSPM0 3.3V电源轨倒灌。此前“AD0~AD2可不串电阻”的通用判断不适用于当前实物，必须撤回；4.1V已不安全，AD0/1/2暂时全部断开。
- 1k串联只能限流，不能保证电平隔离。正式方案优先使用3通道3.3V到5V单向缓冲器（74HCT125/74AHCT125，5V供电），或三路晶体管开集电极隔离并同步修改地址位极性；在此之前不再直连PB5/PB6/PB7。
## 2026-07-18 当前调试器阻塞

- 在灰度AD0导致3.3V轨升至4.1V后，CCS连接目标报XDS110 Error -615。当前禁止连接灰度/MPU继续调试，先以USB单电源和J101默认SWD跳帽恢复目标连接。
- 若USB单电源下3V3、NRST和跳帽均正确，降低SWD/TCLK后仍无法连接，需考虑MSPM0因过压受损；XDS110本身已能被CCS识别，错误发生在探针到目标之间。
## 2026-07-20 V73简化灰度锁存测试

- 当前活动源码：`C:\Users\1\Desktop\ELECTRIC\ele-car\empty.c`。
- 时间戳源码：`C:\Users\1\Desktop\电赛\ccs_project\line_sensor_test\20260720_142549_v73_gray_simple_latched_watch_test.c`；修改前V50备份：`20260720_142549_before_v73_gray_watch_test_v50_backup.c`。
- V73只启用PB5/PB6/PB7地址扫描、PA7输入和PA15状态灯；PB4/STBY、PWM、舵机均关闭，PB11保持HIGH，MPU/OpenMV不初始化。
- 简化Watch为当前raw/black mask、累计`g_seen_black_mask`、最后一次`g_last_black_mask`、不稳定mask、变化次数和扫描计数，避免快速扫线被Watch刷新漏掉。
- CCS 20.5工具链clean build通过，所有Watch符号已核对进入最终map/out；未烧录。硬件前提仍是连接AD线后3.3V轨不得被抬高，软件不能替代5V/3.3V隔离。
## 2026-07-20 V74白底启动轻微右偏修正

- 用户确认当前V72循迹正常，仅白底启动阶段轻微向右偏。活动源码已由用户恢复为V72，修改前SHA256为`28549B3CF905916AB3D7D2007B80EF18397BC2049C6292F002FA14AF5AA5E711`并完成时间戳备份。
- V74只修改`PHASE_START_BRIDGE`：启动增力由`563/566`改为`562/567`，随后白底桥接新增独立`424/430`；循迹基础`425/429`、灰度、弯道和MPU参数完全不变。
- 当前活动文件：`C:\Users\1\Desktop\ELECTRIC\ele-car\empty.c`；时间戳源码：`C:\Users\1\Desktop\电赛\ccs_project\integration_test\20260720_152245_v74_start_bridge_slight_left_trim.c`。clean build通过，未烧录。
## 2026-07-20 V75出弯首次全灭立即左修正

- 用户反馈V74出弯后仍向右偏，要求传感器刚识别不到黑线时立即向左偏移。
- V75在正常循迹阶段首次真正全灭、且前两帧为右侧X5/X6/X7或最后误差为正时，立即输出4帧约80ms的左修正：`TURN_EXIT_LEFT_NUDGE_TICKS=18`，实际基础PWM约`407/447`。黑线恢复同帧取消，桥接启动不触发。
- 触发时清零旧右转误差，防止短脉冲结束后重新沿旧误差右转；现有5帧出弯确认、MPU角度/航向、弯道前馈和正常循迹参数保持不变。
- 当前活动文件：`C:\Users\1\Desktop\ELECTRIC\ele-car\empty.c`；时间戳源码：`C:\Users\1\Desktop\电赛\ccs_project\integration_test\20260720_153056_v75_immediate_left_nudge_on_line_loss.c`；修改前V74备份：`20260720_153056_before_v75_instant_left_nudge_v74_backup.c`。编译通过，未烧录。
## 2026-07-20 V76双项小步调参

- V75实测：首次全灭已能立即稍向左，但角度略大；白底启动仍轻微右偏。
- V76只改参数：出弯左脉冲`18 -> 14 ticks`，仍保持4帧；白底增力`562/567 -> 561/568`，普通桥接`424/430 -> 423/431`。正常循迹`425/429`和全部状态逻辑不变。
- 当前活动源码：`C:\Users\1\Desktop\ELECTRIC\ele-car\empty.c`；时间戳版本：`C:\Users\1\Desktop\电赛\ccs_project\integration_test\20260720_154433_v76_smaller_exit_left_nudge_stronger_start_left_trim.c`；修改前V75备份：`20260720_154433_before_v76_dual_trim_v75_backup.c`。编译通过，未烧录。
## 2026-07-20 V77继续减弱出弯左脉冲

- V76实测全灭后的左偏仍略大。V77保持触发条件和4帧持续时间，只将`TURN_EXIT_LEFT_NUDGE_TICKS`从14降到10，使结果相对向右回一点。
- 白底启动`561/568`与`423/431`、正常循迹、弯道和MPU逻辑均未修改。
- 当前活动源码：`C:\Users\1\Desktop\ELECTRIC\ele-car\empty.c`；时间戳源码：`C:\Users\1\Desktop\电赛\ccs_project\integration_test\20260720_155947_v77_reduce_exit_left_nudge.c`；修改前备份：`20260720_155947_before_v77_reduce_left_nudge_v76_backup.c`。clean build通过，未烧录。
## 2026-07-20 V78白底左偏与全灭右脉冲

- 用户明确要求：白底启动向左偏一点；传感器首次识别不到黑线后向右偏一点。
- V78白底增力由561/568改为560/569，普通桥接由423/431改为422/432，继续小幅增加左偏。
- 原全灭左脉冲改为通用右脉冲：`TURN_EXIT_NUDGE_CORRECTION_TICKS=+4`、持续4帧，实际输出约429/425。原`left_nudge`变量统一重命名为`g_turn_exit_nudge_*`，避免方向语义错误。
- 当前活动源码：`C:\Users\1\Desktop\ELECTRIC\ele-car\empty.c`；时间戳源码：`C:\Users\1\Desktop\电赛\ccs_project\integration_test\20260720_160832_v78_start_left_line_loss_right_nudge.c`；修改前V77备份：`20260720_160832_before_v78_direction_rebalance_v77_backup.c`。编译通过，未烧录。
## 2026-07-20 从V78精确回退V77

- 用户要求退回上一步。活动`empty.c`已精确恢复为V77，不保留V78的白底进一步左偏、全灭右脉冲及变量重命名。
- 恢复参数：白底增力561/568、普通桥接423/431；首次全灭为10 ticks左修正、4帧；Watch恢复`g_turn_exit_left_nudge_*`，`g_firmware_version=77`。
- 本次恢复归档：`C:\Users\1\Desktop\电赛\ccs_project\integration_test\20260720_161523_restore_v77_after_v78_test.c`。该文件、原V77归档与活动源码SHA256完全一致；clean build通过，未烧录。
## 2026-07-20 当前XDS110不可枚举

- CCS Error -260后，本机`xdsdfu -e`实测0设备，Windows也无TI/XDS USB枚举。当前不是目标程序问题，禁止尝试固件升级命令。
- 若完全隔离J101目标侧、更换数据线/USB口后仍无法枚举，需要使用另一块LaunchPad的XDS110或外置XDS110通过SWD连接目标MSPM0；4.1V倒灌时若J101 3V3仍连接，可能同时冲击板载XDS110电源域。
## 2026-07-20 灰度链路再次全低

- V73扫描循环正常但PA7始终低，当前不是软件卡死。此前AD0倒灌问题尚未证明通过电平隔离彻底解决，因此灰度板和PA7存在重复受损风险。
- 禁止继续将PB5/PB6/PB7直接接5V灰度板AD0/1/2并反复上电；先完成PA7独立高低测试和模块OUT离线测试，再决定更换PA7或增加74HCT125等隔离。
## 2026-07-20 灰度故障根因进一步收敛

- 故障时灰度模块OUT实测4.93V且电源独立后仍复现，说明不是TB6612供电容量问题。当前禁止继续PB5/PB6/PB7直连5V灰度AD0/1/2。
- 采购/接入74HCT125或74AHCT125：5V供电、OE接GND，PB5/PB6/PB7进A端，Y端分别到AD0/1/2；OUT继续10k/20k分压到PA7。独立5V灰度电源必须与MSPM0公共地。
## 2026-07-20 灰度接口已确认双路倒灌

- AD0直连PB5和OUT到PA7均可独立抬高MSPM0 3.3V轨，当前禁止恢复这两根线。AD地址必须经74HCT125/74AHCT125；OUT分压需离线重测，无法保证时改用3.3V供电、5V容忍输入缓冲器。
- 外部LM2596向J11/3V3供电时保持J101 3V3断开；只有断开外部3.3V、改为USB/XDS110供电时才能装回该跳帽。
## 2026-07-20 灰度板进入短路隔离状态

- 所谓AD0接GND导致全灯灭和线材快速发热，当前灰度板及其线束视为针序错误或内部短路，禁止通电。此前关于AD0高阻输入的接线测试假设已被实物反证。
- 下一步必须通过断电万用表测阻与模块正面丝印照片重新建立真实针脚映射；74HCT125和OUT分压方案暂缓，直至确认5V/GND/AD0/AD1/AD2/OUT每个端子。
## 2026-07-20 官方灰度资料对接口结论的修正

- 已核对`用户入门手册.pdf`与`数据读取.pdf`：YB-MYX05-V1.0内部使用CD4051，模块供电为5V；丝印正面、传感器朝上时六针从左到右为`GND/OUT/AD0/AD1/AD2/5V`。
- 官方MSPM0G3507示例将`AD0/AD1/AD2`直接连接`PA14/PA15/PA16`，因此正常地址输入允许3.3V GPIO直驱。此前“地址线原则上必须74HCT125”的结论撤回；实物所谓AD0接地发热应优先判断为针序镜像、线束映射错误或模块内部损坏。
- `OUT`是CD4051数字输出，模块高电平实测约4.93V，仍不得直接进入MSPM0普通GPIO；必须先在MCU断开时验证10k上臂、20k下臂分压中点约3.29V，或使用可靠5V到3.3V电平转换。
- 官方线材图片不能作为颜色针序依据。恢复通电前必须逐根做六针端到杜邦端的断电连续性映射，并测`5V-GND`及所谓AD0对5V/GND的稳定阻值。
- 官方数据定义为“Xn指示灯亮时，对应数字量为1”。参考读取函数每次设置AD0/1/2选择通道后延时50us再采样OUT，八路遍历顺序为通道0至7；后续测试代码不得省略复用器建立时间。
## 2026-07-20 灰度旧板AD0-OUT短路根因判断

- 用户断电检查确认旧灰度板`AD0-OUT`短路，其他端子未发现同类短路。该故障位于CD4051控制端与公共信号端之间，不属于正常电路连通。
- TI CD4051B数据手册规定任一输入只能位于`-0.5V`至`VDD+0.5V`，单输入钳位电流绝对值不得超过10mA；分离电源场景需要避免上下电期间的持续钳位电流。5V供电时地址高电平保证阈值为3.5V，MSPM0的3.3V高电平不能保证被CD4051B识别，但该阈值问题主要解释通道不稳，不足以单独解释永久短路。
- MSPM0G3507数据手册确认PA7属于普通容限GPIO，输入上限为`VDD+0.3V`且支持的钳位二极管电流仅±2mA。现场OUT约4.93V并曾把3.3V轨抬到4.35V，已经同时超过GPIO输入范围和MCU VDD 4.1V绝对最大值，是明确的破坏性电气应力。
- 最可能故障链：OUT直连或分压接线失效向PA7倒灌；独立供电未共地、热插拔和不同上电顺序使回流改走OUT/AD0保护结构；CD4051发生过流或锁存并最终形成AD0-OUT击穿。最后将AD0接地时，若短路已存在，就等于把高电平OUT强制接地，可能进一步扩大损伤。
- 精确到“哪一次插拔首先击穿”无法事后证明。新板必须先与旧板做断电阻值对照，再按电源、地址、OUT逐级接入，禁止一次接齐验证。
## 2026-07-20 V79起步桥接陀螺仪航向闭环

- 当前活动源码已由V77升级为V79：`C:\Users\1\Desktop\ELECTRIC\ele-car\empty.c`；时间戳归档：`C:\Users\1\Desktop\电赛\ccs_project\integration_test\20260720_212848_v79_start_bridge_gyro_heading_hold.c`；两者SHA256均为`A72B9D7074B082E653C7A5DA017FD7EA503CA4DEE1F5ED75D54DE9A51788A0CE`。
- A点进入`PHASE_START_BRIDGE`时记录当前`g_yaw_mdeg`为目标；起步增力和普通桥接都在原固定PWM上叠加独立MPU修正，公式仍为`left=base+corr,right=base-corr`。
- 桥接修正由Z轴角速度阻尼和航向误差组成：角速度死区600mdps、除数1800、限幅30；航向死区500mdeg、除数500、限幅35；总限幅40 ticks，每帧最多变化4 ticks。左偏产生正修正并向右拉回，右偏反之。
- MPU不可用或运行中失联时自动清零桥接修正，严格退化到V77的`561/568`和`423/431`固定PWM；进入循迹或桥接超时立即关闭桥接航向状态。原循迹、弯道、出弯和灰度参数未修改。
- CCS clean build通过且无警告，map确认新增桥接函数和Watch变量进入最终`ele-car.out`；未自动烧录，未生成readme。
## 2026-07-20 V80非对称滤波桥接控制

- 用户手调V79备份：`C:\Users\1\Desktop\电赛\ccs_project\integration_test\20260720_220612_v79_user_tuned_bridge_params_backup.c`，SHA256=`5BA2344A5BD85A5CE69252FF505A662A9F465FB840DFB676BE5F2F4AF7DF429A`。
- 当前活动V80：`C:\Users\1\Desktop\ELECTRIC\ele-car\empty.c`；时间戳归档：`C:\Users\1\Desktop\电赛\ccs_project\integration_test\20260720_220851_v80_asymmetric_filtered_start_bridge_heading.c`；两者SHA256均为`545210E7263E2482119053396ECACB2C3148B9D5BC8126198C57DE4AB559144D`。
- V80保留手调版航向除数400和负方向最大65 ticks纠偏能力；Z轴角速度加入四分之一低通，死区改为连续输出形式，降低起步振动尖峰影响。
- 桥接方向控制改为非对称：左修正最多65、每帧建立6；右修正最多24、必须正航向误差连续3帧确认且每帧只建立2；反向前以每帧6 ticks先释放到0，严禁单帧跨零翻转。
- 新增Watch：`g_start_bridge_filtered_gyro_z_mdps`、`g_start_bridge_desired_correction`、`g_start_bridge_right_confirm_count`、`g_start_bridge_correction_mode`；mode 0=中性、1=左修正、2=释放、3=右修正。
- clean build通过且无警告；控制序列测试`-30 -> +20`期望下实际输出`-24,-18,-12,-6,0,2...`，验证不会单帧反向。未烧录，未生成readme，原循迹/弯道/出弯逻辑未修改。
## 2026-07-21 V81彻底禁用MPU的灰度循迹版

- 当前活动源码：`C:\Users\1\Desktop\ELECTRIC\ele-car\empty.c`；V80修改前备份：`C:\Users\1\Desktop\电赛\ccs_project\integration_test\20260721_144646_v80_before_mpu_disable_backup.c`；V81时间戳源码：`C:\Users\1\Desktop\电赛\ccs_project\integration_test\20260721_144906_v81_no_mpu_gray_curve_tracking.c`。
- V81设置`MPU_ENABLE=0`，不初始化I2C、不执行WHO_AM_I和零偏校准、不读取PA0/PA1；`g_mpu_link_ok=0`，桥接使用固定PWM。坏陀螺仪应物理断开VCC/GND/SDA/SCL，避免硬件总线影响。
- 首次重捕线不再无条件调用`curve_start()`。无MPU时只有`abs(g_gray_line_error)>=1200`连续2帧才进入弯道；当前用户调好的`CURVE_RIGHT_FEEDFORWARD_TICKS=30`仅在该弯道状态中生效，直线重捕阶段不会立即叠加右转。
- 无MPU出弯：保留灰度历史、最后非零误差和无MPU固定8帧制动超时；有弯道状态结束后进入固定差速gap状态，中心灰度连续确认后再进入下一弯道。不能获得实际转角，仍需现场调弯道入口/出口参数。
- 当前版本编译链接通过且无警告，最终map未包含I2C初始化/MPU校准函数；未烧录，未生成readme。
## 2026-07-21 陀螺仪损坏原因分析

- 已知安全接线本身为`VCC->3.3V`、`GND->公共GND`、`SDA->PA0`、`SCL->PA1`、`AD0->GND`。在此条件下AD0接地不是损坏原因。
- 结合此前外部3.3V轨被灰度信号抬高至4.35V、板上曾出现3.8V/4.1V供电、多个模块独立供电未共地和带电插拔，最高置信度原因是MPU曾承受超过3.3V额定值或I2C信号越过MCU/传感器电源轨，产生保护二极管倒灌和过压损伤。
- 其他可能性按优先级为：SDA/SCL误接TB6612方向脚或5V信号；某一侧未上电时另一侧通过I2C上拉/保护结构回灌；接线松动、热插拔或静电造成瞬态；模块本身焊点/芯片失效。现有记录不足以确定是哪一次插拔完成击穿。
- 换板前应断电测量旧板`VCC-GND`、`SDA-GND`、`SCL-GND`阻值及通电后的SDA/SCL空闲电平；SDA/SCL应在约3.3V高电平，不能被拉低或出现5V。新板必须先独立3.3V+GND验证，再接PA0/PA1，禁止带电插拔。
## 2026-07-21 V82十毫秒时序换算与右弯恢复增强

- 用户10ms调参版备份：`C:\Users\1\Desktop\电赛\ccs_project\integration_test\20260721_160343_v81_user_10ms_tuned_backup.c`；V82当前活动：`C:\Users\1\Desktop\ELECTRIC\ele-car\empty.c`；V82归档：`C:\Users\1\Desktop\电赛\ccs_project\integration_test\20260721_160557_v82_10ms_timing_right_curve_recovery.c`；活动与归档SHA256均为`AAA3FD9279DE94823F93F48120963E65C4AE67B8205E1C64B0817AF451768207`。
- 保持`GRAY_MAIN_LOOP_MS=10`，将时间型帧数换算为原物理持续时间：启动40、入线4、桥接超时500、普通丢线超时200、总运行3000、出弯保持56、全灭确认10、制动最短6/最长30、重入确认4、curve丢线360、gap最短50/最长600。已正确翻倍的中心确认4、丢线强20/中50、左轻推8、无MPU制动16、弯道入口确认4继续保留。
- 新增右弯正误差恢复：仅`g_curve_active!=0`、仍有效看到线且`error>500`时，额外修正`(error-500)/10`并限幅80；负误差、普通直线和完全丢线均为0。代表值：error1000->50、1300及以上->80。
- 新增Watch变量`g_curve_right_recovery_correction`。该项可让右弯中车辆位于黑线左侧时更强向右拉回，并可能改善出弯切线方向；无法保证绝对对齐，过强会切弯内侧或造成右偏振荡。
- CCS clean build通过且无警告，map确认新变量进入最终映像；未烧录，未生成readme。
## 2026-07-21 V83视频复核后的右弯丢线修复

- V82实车修改前备份：`C:\Users\1\Desktop\电赛\ccs_project\integration_test\20260721_163113_v82_before_video_left_deviation_fix.c`，包含用户手调`PWM_LEFT_BASE_TICKS=380`；V83活动：`C:\Users\1\Desktop\ELECTRIC\ele-car\empty.c`；归档：`C:\Users\1\Desktop\电赛\ccs_project\integration_test\20260721_163426_v83_video_fix_right_curve_lost_hold.c`；活动与归档SHA256均为`9690BA97D70524022BF0B8CC92241D611D9F57DE40CCCB4B5174FBFF5F4C1510`。
- 两段视频均显示右转不足先发生，之后黑线才从灰度板侧面滑走；离线后车辆沿切线向外，不是先右过冲再左回。根因是右弯状态触发过晚，以及首次丢线的左轻推清零正误差。
- V83将右弯入口改为正误差>=700连续2帧；不再用绝对误差触发固定右弯。`TURN_EXIT_LEFT_NUDGE_ENABLE=0`，首次丢线不执行负10持续8帧，也不清空右转记忆。
- curve active或连续右侧历史丢线时，最后误差至少强制为+1800，丢线确认前继续右找线；右弯仍有效看到线但误差为负时，左修正限幅60，防止单帧数字跳变产生-300大幅左打。
- 代表输入：curve有效error=-2500时总修正约-48；error=+1300时总修正约+128；curve丢线即使旧误差-2500也改为+1800并输出约+312继续右转。clean build零警告，未烧录。

## 2026-07-21 V84自然出弯修复目标

- V83的`CURVE_RIGHT_LOST_HOLD_ERROR=1800`能够处理弯中向外滑线，但不能无条件覆盖整个弯道；固定赛道弧线末端的正常全灭会因此产生最大右转突变。
- 下一版必须同时保留两种行为：较早丢线继续向右找线；完整跑过弧线后全灭则沿切线直行并结束弯道状态。区分依据采用弯道持续帧数、丢线前有效误差历史和连续全灭确认，不依赖已损坏的MPU。

## 2026-07-21 V84自然出弯判定已实现

- 当前活动源码：`C:\Users\1\Desktop\ELECTRIC\ele-car\empty.c`；V84归档：`C:\Users\1\Desktop\电赛\ccs_project\integration_test\20260721_190504_v84_mature_curve_exit_tangent_transition.c`。
- V84用“curve至少280帧 + 前两次误差绝对值不超过1800 + 全灭连续4帧”识别自然出弯。候选首帧即直行，重新见线则取消；不满足时仍保留V83强右找线。
- 基础PWM380/383、10ms周期、急弯除数6/限幅300及右弯恢复项未变化。clean build零警告，SHA256为`D1D2196579B0CE8581F34147D27EC7A1D3CEB1E7F795CB4F8AB30CC9176D4520`，未烧录。

## 2026-07-21 V85控制方向

- V84实车仍先猛右再直行，证明280帧/误差1800成熟门控没有命中。下一版不再依赖该门控解决突变，而是限制所有curve全灭分支：以最后实际控制修正为起点，禁止抬升到新的最大右转，并在3帧确认窗口内快速释放到直行。

## 2026-07-21 V85平滑出弯已实现

- 当前活动源码：`C:\Users\1\Desktop\ELECTRIC\ele-car\empty.c`；归档：`C:\Users\1\Desktop\电赛\ccs_project\integration_test\20260721_192204_v85_smooth_curve_exit_release.c`。
- 全灭过渡改为最后实际总修正的限幅衰减，最大序列`220->110->0`，不再存在`+1800`误差和约100ms的`+312`强右脉冲。全灭确认固定3帧，无MPU curve会强制建立退出候选。
- clean build零警告，SHA256为`2A4E14D06F5FA4CB58779382FC1532E38793ED5E0BFDE013FEE17754D0D15DC2`，未烧录。

## 2026-07-21 V86弯道渐进控制目标

- V85出弯问题已解决。下一版解决斜角入弯时数字灰度跨通道导致的左右摆动：curve有效线误差低通，最终差速目标斜率限制，负向回正建立速度低于正向右转，反向必须经过零；其他控制阶段保持V85。

## 2026-07-21 V86弯道渐进控制已实现

- 当前活动源码：`C:\Users\1\Desktop\ELECTRIC\ele-car\empty.c`；归档：`C:\Users\1\Desktop\电赛\ccs_project\integration_test\20260721_195602_v86_progressive_curve_correction.c`。
- curve有效线使用1/3新值低通；最终修正斜率为右建36、右释24、左建14、左释18 ticks/帧，跨方向必须经过0。入口继承上一帧实际修正，V85丢线/出弯状态与渐进状态同步。
- clean build零编译警告，SHA256为`B064B94DE63A2CAE5FD6153E82706346854BE1D17E1DA190E45E667A4C5D02BC`，未烧录。

## 2026-07-21 2021 F题智能送药小车模拟方向

- 赛题文件：`D:\软件\xwechat_files\wxid_gdp9f9sm7a9u22_4c08\temp\RWTemp\2026-07\7f9016cfc50d0e53a8466eab788203c5\2021_F题_智能送药小车.pdf`；共4页，已完成文本提取和页面图示核对。
- 当前单车硬件可复用：LP-MSPM0G3507、R3X两轮差速底盘、TB6612、双编码器、OpenMV H7、2S电池及稳压、电源开关、蜂鸣器、红/绿LED和通用结构件。当前只有一套完整小车，未确认无线模块和黄色LED。
- 当前软件可复用：MSPM0电机PWM/方向控制、安全停车、10ms调度、状态机、灰度误差中位数/迟滞/斜率限制思路、OpenMV与MSPM0 UART通信、OpenMV红色和黑框检测脚本基础。最新V87的右弯三状态/黑线逻辑不能直接视为F题导航算法。
- F题关键缺口：红线导航与黑色数字卡并存；1-8数字识别；路口拓扑和随机房号寻径；200g药品装载/卸载自动检测；门口5cm区域精准停车和返航；编码器在当前V87中未启用；第二车和无线协同完全缺失；随题`数字字模.pdf`未提供。
- 推荐架构：OpenMV固定斜向下，按任务阶段运行红色线/路口检测和黑框数字模板识别；MSPM0负责带编码器的运动原语、路径栈、载药开关、红绿灯和任务状态机。移除激光与二维云台以减重、降高度、释放电源和引脚。MPU已损坏，本题不依赖。
- 八路灰度板默认不作为F题主导航传感器：题目使用红线，黑色数字边框距离红线约2cm，红外反射阵列不能可靠按颜色区分红/黑；且项目有灰度板5V倒灌与旧板AD0-OUT短路历史。只有在真实红/白/黑材料对比测试通过后，才可将其作为门口虚线或失线冗余。
- 最小新增：药盒下方微动开关/压力开关或FSR（优先微动开关，做有药/无药检测）、固定相机支架、真实赛道红胶带/白色亚光底/数字字模。若现有红绿LED不便复用，补两只LED与330Ω电阻。
- 单车基本要求在现有主硬件上具有实现路径；近端应先做，随后中部、远端。发挥部分在现有器材下不可完成，需第二套底盘/主控/视觉/供电/载药检测和两只无线收发模块，且单车远端稳定前不投入。

## 2026-07-21 V87已确认控制决策

- V86未解决斜角进右弯时的连续摆动；下一版不用EMA，改用三帧中位数和右弯三状态控制：`CURVE_CAPTURE`、`CURVE_TRACK`、`CURVE_INNER_RECOVERY`。
- 正常右弯不允许因普通负误差直接左转，总修正最低为`+8`；误差连续3帧小于等于`-1800`后才进入内侧恢复，左修正最多`-18`，误差恢复到`-700`以上连续2帧后回到跟踪。
- 稳定跟踪阶段D项除数30、限幅35；修正斜率为右建28、右释48、左建10、左释24。V85三帧出弯释放保持不变。
- 首次A点白底独立补偿：启动增力base 560/trim -6，普通桥接base 427/trim -10；出弯白底继续使用`380/383`，不得混用首次起步参数。
- 实施约束：基于V86生成V87时间戳源码，只clean build，不自动烧录，不生成readme。

## 2026-07-21 V87弯道防摆与首次桥接拆分已实现

- 活动源码：`C:\Users\1\Desktop\ELECTRIC\ele-car\empty.c`；归档：`C:\Users\1\Desktop\电赛\ccs_project\integration_test\20260721_201820_v87_curve_state_split_gap_trim.c`。
- V87使用三帧中位数、curve捕获/跟踪/内侧恢复三状态和仅跟踪态启用的限幅D项。普通右弯最低`+8`，连续严重越线才允许最大`-18`左回。
- 斜率参数：右建28、右释48、左建10、左释24；V85三帧出弯释放保留。
- 首次A点增力为554/566，后续首次桥接为417/437；出弯白底保持380/383。`g_drive_context`的0/1/2分别表示首次桥接、有线弯道、出弯白底。
- clean build零警告，SHA256为`6D5C839DBD8A89EBFAC72B59F7B686B7C471C2351E39C51F42684F631DDB1F23`；未烧录，未生成readme。

## 2026-07-21 V87双视频待解决问题

- 两次实车视频分别覆盖“正对弯道入口”和“A点车头略偏左”两种初始姿态。后续修改必须同时解释两者，不能用只适合单一起点的固定PWM补丁。
- 优先从轨迹几何和状态切换时序判断问题，再决定是否使用滞环、增益调度、航向代理量或有限状态观测器；不因用户允许高级算法而引入无法用现有八路数字灰度验证的不可观测状态。

## 2026-07-21 V88拓扑门控与预测捕线已实现

- 视频根因：一次失败来自出弯残余右转后约1.8秒重碰同一U弯并被V87误认为下一弯；另一次失败来自首次固定左trim放大人工左偏，以及第二圈侧向撞线时中心锁定门槛阻止进入curve。
- V88首次桥接取消固定trim；首次有效线连续2帧直接启动curve。弯道采用三帧中位数、IIR误差斜率、两帧前视预测和capture/track/inner-recovery三状态，状态切换首帧不启用D项。
- 出弯反向消旋按最后有效修正量自适应生成，最大18 ticks、16帧衰减，并强制通过渐进器跨零，避免`+110 -> -18`单帧翻转。
- 固定赛道gap前220帧拒绝旧线；提前碰线后必须连续8帧无线重新armed；合法窗口内任意有效线连续2帧直接进入受限捕获。280帧后才逐渐建立最多-12的左搜修正。
- 无MPU、无硬件QEI时，全白灰度阶段绝对航向不可观测。V88使用控制历史与固定赛道拓扑降低误差，但不能从纯白输入估计真实航向；若仍存在随机白底漂移，下一硬件升级应是定时器QEI编码器闭环，而不是恢复高频GPIO编码器中断。
- 活动源码：`C:\Users\1\Desktop\ELECTRIC\ele-car\empty.c`；归档：`C:\Users\1\Desktop\电赛\ccs_project\integration_test\20260721_210618_v88_topology_predictive_capture.c`；SHA256=`FCB6ED30DA8E55CE622E2074D50A0D417EA20EF7834EEDA229D1749E65D379F8`。CCS clean build成功，独立复审APPROVE；未烧录、未生成readme。

## 2026-07-21 V89改用控制变量迭代

- 当前活动`empty.c`已确认逐行等同V87。V88保留为归档证据，不再作为活动基线。
- V89按累计阶段实验：阶段1仅取消首次A点固定trim；阶段2再测试首次入线；阶段3再加入预测捕获；阶段4再加入动态出弯消旋；阶段5最后加入固定赛道拓扑重捕。每阶段只改变一个控制因素并单独归档。
- 阶段1判据只看两种起始姿态下A点白底航向和首弯入口位置；本阶段不能用后续重复旧弯道或侧向重捕表现否定启动trim假设，因为对应算法尚未加入。

## 2026-07-21 V89阶段1基线

- 活动源码：`C:\Users\1\Desktop\ELECTRIC\ele-car\empty.c`；归档：`C:\Users\1\Desktop\电赛\ccs_project\integration_test\20260721_215425_v89_stage1_v87_startup_trim_neutral.c`；SHA256=`6FC411354268760EFF8F392D9636989A281CE100228760939FF0DCFEA52D9C8B`。
- 阶段号Watch：`g_v89_experiment_stage=1`。唯一行为变化为首次启动trim归零；V87其余参数和逻辑完全保持。
- clean build与独立复审通过；未烧录。下一次修改必须先取得阶段1的两种起点重复测试结果，不能直接继续叠加V88全部改动。
## 2026-07-22 第一阶段红线/数字/新陀螺仪验证

- 本阶段建立独立目录 `ccs_project/medicine_car_2021f/`，不修改正在使用的 `C:\Users\1\Desktop\ELECTRIC\ele-car\empty.c`。
- 第一阶段目标只验证三件事：OpenMV能稳定检测红线并输出几何量；OpenMV能通过现场模板学习与投票区分1-8号数字框；新到的同版本陀螺仪能被MSPM0以I2C读出并在静止时保持低角速度。
- 数字字模原文件尚未找到，因此采用现场模板学习，不把未知字体硬编码进程序。模板数据为数字框内部固定网格黑白签名，识别使用Hamming距离、首二名间隔和多帧投票。
- 新MPU验收程序接受 `WHO_AM_I=0x68`（MPU6050）或 `0x70`（MPU6500兼容），实读后显示型号；电机、PWM、舵机、灰度板和OpenMV均禁用。
- 关键安全接线：MPU VCC接MSPM0 3.3V，GND共地，SDA接PA0，SCL接PA1，AD0接GND得到0x68；禁止5V和带电插拔。OpenMV阶段只接USB，不同时接整车UART。
- 验收顺序固定为：红线静态/动态→数字模板学习→数字重复识别→MPU静止→MPU手动旋转→最后才接入整车上层状态机。
- 程序已完成并通过桌面验收：`vision_core.py` 测试5/5、覆盖率95%，OpenMV脚本通过`py_compile`；MPU C文件已在ASCII临时CCS副本中Clean Build和链接成功、Watch符号进入map，但尚未烧录，必须完成实物静止/旋转测试才算硬件通过。数字模板保存在OpenMV `/flash/digit_templates.txt`，不得用旧卡片模板替代新纸卡实测。
- 实物OpenMV H7固件为5.0.0，blob/rect字段使用属性式API；视觉脚本已用 `api_value()` 同时兼容4.x方法式和5.x属性式访问。以后复制到IDE时必须使用修复后的最新版，不能继续使用原 `blob.pixels()` 版本。
- OpenMV 5.0.0底层图像API要求坐标整体使用tuple/list：`draw_line((x0,y0,x1,y1))`、`draw_rectangle((x,y,w,h))`、`draw_cross((x,y))`、`get_pixel((x,y),rgbtuple=True)`。网页签名展示为分散参数但底层绑定并非如此，后续必须以已修复脚本和实物结果为准。

## 2026-07-22 循迹返璞归真需求

- 用户要求把当前活动整车程序 `C:\Users\1\Desktop\ELECTRIC\ele-car\empty.c` 的循迹部分替换为最简单版本，删除起步桥接、弯道状态机、MPU融合、出弯制动和分段补偿。
- 本轮保留既有灰度板接线与白底自动标定、TB6612方向和PWM底层、安全输出及蜂鸣器静音；控制层收缩为灰度位置误差的单一比例差速。
- 丢线只允许依据最后一次误差短暂找线，连续丢线超时立即停车；本轮不接入OpenMV、舵机、编码器或任务逻辑。

## 2026-07-22 V90极简循迹定稿

- 活动整车程序已升级为V90：`C:\Users\1\Desktop\ELECTRIC\ele-car\empty.c`，并新增同目录纯控制头文件 `simple_line_control.h`；两文件必须放在同一CCS工程目录。
- 控制链固定为：8路灰度白底基线异或→位置加权平均→单比例差速；有效线修正为`error/36`、限幅70 ticks，基础PWM为左380/右383。
- 全灭时只按最后非零误差以70 ticks短暂找线，连续200帧约2秒后停车；最长运行3000帧约30秒。
- 起步桥接、弯道状态、MPU/航向、出弯制动、前馈、丢线分级和拓扑预测已从活动源码移除。OpenMV、MPU、舵机、编码器、任务逻辑均不初始化。
- 上电必须让8路传感器先处于同一白底完成50次标定；随后PA15常亮2秒，期间把红线放到X4/X5附近。首测车轮架空。
- V89完整备份为`ccs_project/integration_test/20260722_before_v90_simple_line_follow_v89_backup.c`；V90源码、头文件和操作说明均已时间戳归档。
- Host控制测试6/6通过，控制头文件行覆盖率88.24%；TI Arm Clang Clean Build及链接通过、无警告。尚未烧录，实车机械差速与转向方向仍待验证。

## 2026-07-22 唯一活动CCS工程改为mock_problem

- 唯一活动工程为`C:\Users\1\Desktop\ELECTRIC\mock_problem`；`ele-car`和`empty_LP_MSPM0G3507_nortos_ticlang`已按用户要求删除，以后不得再引用旧路径。
- 工程英文名为`mock_problem`，目标板`LP-MSPM0G3507`，环境固定为CCS 20.5、MSPM0 SDK 2.10.00.04、SysConfig 1.26.2、TI Arm Clang 4.0.4.LTS、No RTOS、XDS110。
- 活动源码仍是V90极简循迹：`mock_problem\empty.c`与`mock_problem\simple_line_control.h`；源码SHA256分别为`22642F7626BBD0DE581568A7AD838AE9CF9145BE1C4420371EB377CD5C256C12`和`DCF1560992513064D767205BE05CF45F3108621897C38BD6E81B94BE8436ABD9`，本次只迁移工程，未修改小车控制逻辑。
- SDK的CRC SysConfig资源已从同版本安装缓存补齐54个文件，复核0缺失、0哈希不一致；删除旧工程后独立SysConfig、三单元编译和链接均通过且0诊断。
- `.theia\launch.json`只保留`mock_problem`调试入口；旧工程及旧launch备份未另做副本，题目PDF和资料目录保留。
- 未烧录、未启动Debug；首次CCS操作只导入并Build `mock_problem`，随后按V90要求先架空验证左右修正方向。

## 2026-07-22 V91极简循迹中央提前纠偏

- 唯一活动源码升级为`C:\Users\1\Desktop\ELECTRIC\mock_problem\empty.c` V91；仍是无桥接、无弯道状态机、无MPU/编码器/任务逻辑的极简循迹。
- 灰度板物理灯与`g_gray_x*`表示原始高电平：已知白底为1/灯亮、红线相对变化为0/灯灭。观察红线位置必须使用`g_gray_line_x1...g_gray_line_x8`或`g_gray_line_mask`；例如raw `0xC3`与white `0xFF`得到line `0x3C`，实际为中央X3-X6压线。
- 控制profile：基础PWM左380/右383，单P为`error/26`，修正限幅110；X4/X5约19、X3/X6约57、X2/X7约96、X1/X8约110。丢线搜索70、超时200帧、10ms循环及PWM/电机方向不变。
- 新增`simple_line_profile.h`，固件和Host测试共用生产参数；mask XOR与X1-X8位权映射已提取为纯函数并由生产端直接调用。
- Host测试9/9，整体行覆盖率97.83%、控制头文件93.62%；独立审查无CRITICAL/HIGH，全部测试缺口已补齐；TI SysConfig、编译、链接0 diagnostics。未烧录。
- 活动SHA256：`empty.c=32DD216DF8845CEF04B6596329B6A1D58B095917F135F5D7BB3D7F892E78C315`，`simple_line_control.h=3B8BC499053DCE5CDA73BE3864C49F6AC3D0EA474B66324E461964A252C61C53`，`simple_line_profile.h=1DD1993DBB5B31EC64F3927FAFBE67770449E5670FC091C9123C33E1705B3A7C`。
- 实车验收顺序：白底标定确认255→架空把红线从X4/X5移到X6/X7/X8并核对修正19/57/96/110→落地同姿态直线至少3次；若仍摆动，再记录连续mask/error/correction/PWM决定是否加入简单D阻尼。
## 2026-07-22 2021 F题全病房路线程序目标

- 唯一活动CCS工程：`C:\Users\1\Desktop\ELECTRIC\mock_problem`；V91只作为八路灰度、TB6612 PWM和安全停车底层。
- 本阶段目标：暂不接OpenMV，一次性按 `1→2→3→4→7→5→6→8→药房` 访问全部8个病房；每个病房门口静止2000 ms；使用原地180°退出病房；路口使用MPU完成90°直角转弯；最终回到药房停车。
- MPU接线固定为3.3V、GND、PA0/I2C0 SDA、PA1/I2C0 SCL、AD0接GND（0x68），兼容WHO_AM_I 0x68/0x70；不使用INT/XDA/XCL。
- 软件验收分为Host路线仿真、TI命令行构建、架空转向、单路口、单病房、半程、全程六层；未取得实车全程证据前不得声明整套目标完成。

## 2026-07-22 V92全病房路线当前状态与端点风险

- 活动固件已实现53步固定动作表，访问顺序`1→2→3→4→7→5→6→8→药房`，包含17个路口、9个端点、10次90°转向、8次180°掉头与每病房2000 ms停留；OpenMV未参与。
- 当前端点仅靠armed后连续8帧灰度全灭确认，普通约80 ms脱线可能被误判为病房/药房并使路线错位；在增加独立里程条件并完成实车全程前，整套目标仍未验收。
- 下一控制版本使用PB12/PB13左编码器和PB14/PB15右编码器做每段局部里程门控；左轮前进计数取反、右轮前进保持正向。`1471 edges/cm`只是理论初值，必须现场标定后再确定各段端点最小里程。

## 2026-07-22 V93最终软件稳定快照

- 唯一活动工程仍为`C:\Users\1\Desktop\ELECTRIC\mock_problem`；V93已完成PB12-PB15双编码器上升沿计数、每follow动作独立里程、端点首个失线帧距离/居中锁存、单/双轮停转、方向/4:1轮差及端点硬上界fail-close。
- 九个端点窗口已经进入`medicine_route_action_t`并由生产代码逐动作读取；精确Host预期表锁定动作索引`2/6/13/17/26/30/38/42/51`、病房`1/2/3/4/7/5/6/8/药房`和临时窗口。路线18/18、行覆盖率97.67%；循迹9/9、行覆盖率97.83%。
- 工程`.cproject`、Debug makefile/subdir rules、clangd数据库和最终linkInfo均统一到CCS 20.5、TI Arm Clang 4.0.4.LTS；SysConfig/编译/链接0 diagnostics。最终`mock_problem.out` SHA256为`429E3419AB318EE55BB8FCF1DD577F0365A1DEF97F3BE6F24D03863E5ABE0CC5`。
- 新稳定归档为`ccs_project/medicine_car_2021f/archive/V93_20260722_final_software_verified_4_0_4`，37个归档文件已按`MANIFEST.sha256`逐项校验0失败；旧V93归档保留但已过时。
- 未完成项不变：`736 rising edges/cm`和病房20～70 cm/药房20～100 cm均为临时值；必须完成50 cm实测、九端点各3次标定、目标板故障后一帧PWM/STBY验证以及一次性全路线。软件绿色不得标记总目标完成。

## 2026-07-23 V94编码器50 cm标定完成

- 三次50.0 cm净计数分别为：`(-33152,33334)`、`(-33428,33334)`、`(-33003,33093)`；按生产路径的有方向净count计算得到`664.86/667.62/660.96 edges/cm`，平均`664.48`，固件取最近整数`664U`。总edges只用于诊断，不能代替生产里程输入。
- 唯一活动工程升级为V94：新增`encoder_calibration_profile.h`并由`empty.c`引用；`g_firmware_version=94`。病房20～70 cm为`13280～46480 edges`，药房20～100 cm为`13280～66400 edges`；5 cm确认缓冲为`3320 edges`。
- 完整路线Host测试`19/19`、总行覆盖率`97.71%`；完整仿真已改为直接使用生产`664 edges/cm`及方向容差/轮差检查/端点缓冲`1328/3320/3320`，不再使用缩小比例。极简循迹仍为`9/9`。
- CCS 20.5、TI Arm Clang 4.0.4.LTS最终产物有效：`mock_problem.out` SHA256=`A335C6B1B7709B3133960B1252E08BD094828FC1A18A7065478523EC2315A3B4`，map=`1396A4DAF8EB592687AABC11913FF2677156E505A90C668939AA5A168E443DE5`。必须关闭CCS 20.2，避免Debug生成文件退回4.0.3。
- 新稳定归档：`ccs_project/medicine_car_2021f/archive/V94_20260723_encoder_calibrated_4_0_4`，39项manifest复核0失败；V93归档未覆盖。
- 实验2通过，但总目标仍未完成。下一项只做实验3A：MPU静止/左右方向独立验证；其后才依次做单路口90°、单病房、九端点各3次、半程和完整路线。
- 已用TI Arm Clang 4.0.4单独生成电机全关的MPU验收镜像：`C:\Users\1\Desktop\ELECTRIC\mock_problem\Debug\mpu_validation.out`，SHA256=`B8B2A91B9DF6351C87303B10AFB1BBD2C1D754C896FA040A3D101ECC628318D4`；加载该out不覆盖V94源码，供实验3A使用。

## 2026-07-23 用户要求的后续代码交付方式

- 当前活动`empty.c`已按用户上一条明确要求临时覆盖为V95 MPU测试代码；V94路线仍在独立归档中。
- V95测试源码备份：`ccs_project/medicine_car_2021f/backup_code/20260723_v95_mpu_validation_empty.c`，SHA256=`91C95EE7FC634E11BD2D191372ABF799C3899A62712947B7D428628651EE5C50`。
- 今后仅生成并验证备份源码，提供绝对路径和最短复制/粘贴/Build/Debug步骤；不再代用户清理环境、修改工程配置、切换工具链、自动构建或加载out，除非用户再次明确要求。

## 2026-07-23 题目规定的正式初始位置

- 题目第1页原文规定：小车摆放在药房处，车头投影在门口区域内，面向病房。图1中药房位于最下方，小车应沿中央红线向上，药房至近端1/2号病房路口为60 cm。
- 正式等效测试不能先在白底启动、再用断点人工移到红线；当前V94启动时采纯白基准与题目药房红线起点存在冲突。已验证灰度板白底=1、红线=0，下一测试版本应固定白底基准`0xFF`并取消启动搬车，之后从药房门口一次复位直接运行。

## 2026-07-23 V96药房红线直接启动备份

- 只生成备份、不改活动工程：`ccs_project/medicine_car_2021f/backup_code/20260723_v96_pharmacy_red_line_start_empty.c`，SHA256=`E60A38F4CEFEC6D4EB1601E5C2FF469EE7D8A7489983A385898A9DF43839D424`。
- 相对归档V94仅改版本96、固定白底`0xFF`、新增固定基线初始化并删除启动50帧采白/非均匀失败分支；路线、664编码器标定、端点保护和MPU逻辑无差异。
- 验证：源代码契约2/2、路线19/19、循迹9/9；TI Arm Clang 4.0.4语法检查0诊断；独立复审0 CRITICAL/HIGH/MEDIUM。

## 2026-07-23 V97首个90度转弯后自动停车备份

- 用户拒绝CCS条件断点；实验改为复制源码后仅执行Build、Debug、Run。小车从题目规定的药房门口原位启动，到第一个路口完成90度左转后自动停车，不继续驶向1号病房。
- 只生成备份，不修改活动工程：`ccs_project/medicine_car_2021f/backup_code/20260723_v97_single_turn_auto_stop_empty.c`，SHA256=`68C1E77D083FA4D3FEB03F70FA870C0FF9B503D7662427F7DB9AE9A1EAC63BDB`。
- V97保留V96固定白底`0xFF`、药房红线直接启动、664编码器标定、MPU和原路线故障保护。首转完成且mission推进到action 2后置完成标志；故障状态优先于测试完成，最终停车位于永久循环之前。
- 验证：源码契约2/2、路线Host 19/19、循迹9/9、TI Arm Clang 4.0.4语法检查0诊断、复审0 CRITICAL/HIGH/MEDIUM。
- 正常自动停车预期：`g_firmware_version=97`、`g_single_turn_test_complete=1`、`g_route_action_index=2`、`g_junction_event_count=1`、`g_turn_count=1`、`g_route_fault=0`、`g_stop_reason=1`、左右PWM均为0。无需断点；若需确认变量，只在自动停车后暂停程序查看。

## 2026-07-23 V98循迹反馈方向修复备份

- V97实车持续右偏直到完全脱线；根因是V91继承的差速修正方向从未实车验证，且与此前实车稳定循迹基线相反。
- 只生成单文件备份，不改活动工程：`ccs_project/medicine_car_2021f/backup_code/20260723_v98_line_feedback_sign_fix_single_turn_empty.c`，SHA256=`07AF75F620AEF28A6DB00B2955E83464FED6A8C06501D04AFE32FF381A03A7B9`。
- V98仅在`simple_line_step()`入口把当前灰度误差和最后有效误差同时乘`-1`；因此正常纠偏和丢线找回一起反向。Gray原始Watch、居中检测、基础PWM 380/383、P增益、110限幅、固定白底0xFF、664编码器、MPU路线与首转自动停车不变。
- 验证：方向适配PASS、源码契约3/3、路线19/19、循迹9/9、TI Arm Clang 4.0.4语法0诊断、最终复审无任何级别问题。
- 实车通过标准：从药房门口沿红线稳定到约60 cm首个路口，完成90度左转后自动停车；轻微摆动可以后续单独调参，但不得再出现单方向持续发散。

## 2026-07-23 V99首个路口提前触发修复

- V98约10 cm停车的首要软件嫌疑是首段路口检测仅需30个10 ms帧即可重新武装，药房起点宽红线可能提前触发；V99只延迟首段，不改运行速度。
- 备份代码：[20260723_v99_first_junction_gate_empty.c](C:/Users/1/Desktop/电赛/ccs_project/medicine_car_2021f/backup_code/20260723_v99_first_junction_gate_empty.c)，SHA256=`37CA49314849CFE689B1CA86CA61B7AE19CA8A1C5A7706F7C74ADA85D5427836`。
- `FIRST_JUNCTION_ROUTE_EVENT_CONFIG.min_travel_frames=180`仅在`g_route_action_index==0`时选择；普通`ROUTE_EVENT_CONFIG`仍为30帧，后续端点和路口逻辑不受影响。
- 验证：首段动态门控PASS、路线19/19、循迹9/9、TI 4.0.4语法0诊断、复审0 CRITICAL/HIGH/MEDIUM。

## 2026-07-23 车辆转动中心几何参数

- 小车总长约`22 cm`，但转弯补偿不得直接使用整车长度。
- 用户实测“灰度传感器有效中心→左右驱动轮轴连线中点”为约`17.5 cm`。
- 编码器标定`664 edges/cm`，因此90度路口转弯前的初始补偿目标为`17.5×664=11620 edges`。
- 该补偿仅用于路口90度转弯前将轮轴中点送到路口中心；病房端点后的180度原地掉头保持零前进补偿。

## 2026-07-23 V100几何补偿备份

- 备份源码：[20260723_v100_encoder_turn_center_17p5cm_empty.c](C:/Users/1/Desktop/电赛/ccs_project/medicine_car_2021f/backup_code/20260723_v100_encoder_turn_center_17p5cm_empty.c)。
- `GRAY_TO_TURN_CENTER_MM=175`，`JUNCTION_CENTER_TARGET_EDGES=11620`；90度路口在陀螺仪旋转前由双编码器平均前进量达到该目标，180度掉头不启用。
- 保留V99首段`180`帧门控、V98循迹负反馈符号、固定白底`0xFF`、编码器`664 edges/cm`和首转自动停车。
- 验证结果：源码/回归18/18，路线Host19/19，循迹9/9，TI Arm Clang 0 diagnostics；SHA256=`C930B1E1637D72AE1ED9B963A6359B6FFA174B3C2292B584CDB0AE1CF0F0E461`。

## 2026-07-23 V101待实现方向

- 路口`wide_confirm_frames`由2改为1。
- 路口事件瞬间锁存左右编码器计数并主动短刹，后续17.5 cm从该事件计数开始，包含事件后滑行量。
- 17.5 cm居中前进阶段使用MPU Z轴累计偏航做左右PWM差速修正，不再固定300/303开环前进。

## 2026-07-23 V101路口一致性修复备份

- 备份：[20260723_v101_junction_latch_heading_hold_empty.c](C:/Users/1/Desktop/电赛/ccs_project/medicine_car_2021f/backup_code/20260723_v101_junction_latch_heading_hold_empty.c)，SHA256=`4784481B95D79303E75712AFB53275C48F31B9DD67B2BAAE7F1700FD0842B576`。
- 路口宽线由连续2帧改为1帧；路口事件顺序固定为“编码器锁存→主动刹车→任务推进”，17.5 cm从事件瞬间起算。
- CENTER阶段使用陀螺仪偏航与左右编码器差共同修正PWM，trim限幅±60；保留11620 edges、首段180帧门控、180度零补偿和首转自动停车。
- 验证：Python25/25、路线19/19、循迹9/9、TI语法0诊断、最终复审0问题。

## 2026-07-25 V102路口触发阈值

- 用户要求把路口宽线判定从至少`7/8`个灰度通道检测到红线，改为至少`4/8`个；仍保持连续1帧确认。
- 延续交付约束：只从V101生成验证后的单文件备份，不修改活动`empty.c`、CCS环境或工程配置。
- V102备份：`ccs_project/medicine_car_2021f/backup_code/20260725_v102_junction_threshold_4_empty.c`，SHA256=`AA6138CE01B954DA9B66671906AB20A23EABF67472654EA265587F79FC8BA2FA`。

## 2026-07-25 V102实车视频回归

- 视频显示小车能沿首段红线前进，但路口后继续直行；V102把`wide_active_min`降至4时，同时改变了路口触发、检测器武装和循迹旁路三处语义。
- V103应保留“武装后4路即可触发”，同时让未武装阶段仍以7路作为明确宽线界限，并让4至6路状态继续进入循迹控制。
- V103备份：`ccs_project/medicine_car_2021f/backup_code/20260725_v103_junction_trigger_decoupled_empty.c`，SHA256=`97EF1457F69091FAD9F10FD18C78AA1CF3B4FDBD0B7E9D45392F5DB0C9B08939`；端点动作始终保持7路正常线界限。

## 2026-07-25 V103首路口门控回归

- 新视频显示首路口约在启动后1.5秒到达，而V103首段仍要求180个10 ms正常帧，导致首路口尚未武装就被穿过。
- V104改用编码器距离门控：前进达到25 cm且已有5个正常线帧后武装首路口；10 cm药房起始宽线不会提前触发，60 cm首路口可及时触发。
- V104备份：`ccs_project/medicine_car_2021f/backup_code/20260725_v104_first_junction_encoder_arm_empty.c`，SHA256=`9C39B718C272DBE252A11C103F2D251F35A9564F88864D26B35A908E3C825F12`。

## 2026-07-25 V105与项目边界

- V105首路口保护参数：50 cm编码器武装、`X4/X5`同时有效、连续3个10 ms控制帧确认；只作用于首个路口，后续路线阈值不变。
- 最新备份：`ccs_project/medicine_car_2021f/backup_code/20260725_v105_video_gated_first_junction_empty.c`。活动工程快照：`ccs_project/medicine_car_2021f/active_project/`，当前仍为V104。
- 会话`019e7371-af12-7d03-a88c-240a230f2d96`的V62–V91循迹控制变量实验归入`ccs_project/integration_test/`，与2021 F题的V95–V105路线状态机分开保存。
- GitHub仓库通过`PROJECTS.md`和各目录项目说明维护边界；不得跨项目直接覆盖同名`empty.c`或共享头文件。
