jlg006728/electronic-design-contest/硬件接口图.md

# E题 硬件接口图 — 完整接线方案

> 基于 LP-MSPM0G3507 LaunchPad + WHEELTEC R3X 底盘 + XD-01 TCRT5000 模块
> 修正日期: 2026-07-02
> 关键修正：`PA2~PA6` 在 LP-MSPM0G3507 开发板上默认不适合直接作为杜邦线 GPIO；旧的 `PA3/PA4` 舵机方案作废。

---

## 一、系统总览

```
┌─────────────────────────────────────────────────────────────┐
│                    2S LiPo 7.4V 电池                         │
│                  ┌────┴────┐                                 │
│                  │ 双路开关 │                                 │
│           ┌──────┴──┐  ┌──┴──────────┐                      │
│           │ 电机电源 │  │ 控制/舵机电源│                      │
│           └────┬────┘  └────┬────────┘                      │
│                │            │                                │
│          ┌─────┴─────┐  ┌──┴──────────┐                     │
│          │ TB6612FNG │  │ 5V 3A 降压   │                     │
│          │  VM=7.4V  │  │ (MP1584)     │                     │
│          └─────┬─────┘  └──┬──────────┘                     │
│                │            │                                │
│     ┌──────┬───┘      ┌────┼─────────────┐                  │
│     │      │          │    │             │                   │
│  左电机  右电机    LaunchPad  MG90S×2   OpenMV H7            │
│                    3.3V      5V          5V                  │
│                                                              │
│  激光模块 ← 规格电源/TTL脚待确认，控制脚不要用 PA20             │
│  TCRT5000 ×7 ← 3.3V (LaunchPad 引出)                         │
│  编码器 ×2 ← 3.3V (LaunchPad 引出)                           │
└─────────────────────────────────────────────────────────────┘
```

> **关键设计决策**: 单舵机已用 TB6612 稳压板 5V 验证可动作；但双舵机 + OpenMV 不能默认直接依赖该 5V，正式整机前必须带载测压。

---

## 二、MSPM0G3507 LaunchPad 引脚分配总表

### 电机驱动 (TB6612FNG)

| MSPM0 引脚 | 外设功能 | TB6612 引脚 | 说明 |
|---|---|---|---|
| **PB0** | GPIO (输出) | AIN1 | 左电机方向1 |
| **PB1** | GPIO (输出) | AIN2 | 左电机方向2 |
| **PB2** | GPIO (输出) | BIN1 | 右电机方向1 |
| **PB3** | GPIO (输出) | BIN2 | 右电机方向2 |
| **PB4** | GPIO (输出) | STBY | 使能 (HIGH=工作) |
| **PA12** | TIMG0 CCP0 | PWMA | 左电机 PWM (20kHz) |
| **PA13** | TIMG0 CCP1 | PWMB | 右电机 PWM (20kHz) |

> 注意: TIMG0 也可在 PA5/PA6 输出, 但当前电机 PWM 已实测固定使用 PA12/PA13。
> 因此电机 PWM 只能走 PA12/PA13, 不可更改。

### 巡线传感器 (TCRT5000 ×7)

> **当前方案**: 数字模式 (DO)。使用 XD-01 模块 (带 LM393 比较器) 输出 TTL 电平。
> 黑线=HIGH，白底=LOW。可判断第 N 路压线，位置分辨率 ≈ 传感器间距 (1.0-1.5cm)。
>
> **如需要更高精度**: 改用模拟方案 (AO)，将传感器引脚全部换到有 ADC 功能且未被占用的引脚
> (PA18, PA21-PA25 等；PA14/PA17 当前已给舵机)，通过加权平均算法获得亚毫米级位置偏差。
> 详见第七节"巡线传感器: 模拟 vs 数字方案"。

| MSPM0 引脚 | 传感器 | 说明 |
|---|---|---|
| **PB5** | S1 (最左) | GPIO 输入 |
| **PB6** | S2 | GPIO 输入 |
| **PB7** | S3 | GPIO 输入 |
| **PA7** | S4 (中间) | GPIO 输入 |
| **PA8** | S5 | GPIO 输入 |
| **PB9** | S6 | GPIO 输入 |
| **PB10** | S7 (最右) | GPIO 输入 |

> 实测记录：原计划的 `PA2/PA5/PA6` 在输入测试中不可用，已改用 `PB5/PB6/PB7`。

> XD-01 模块自带 LM393 比较器 + 电位器调阈值，DO 输出 TTL 电平。
> 黑线=HIGH，白底=LOW。数字方案精度受限于传感器间距 (~1.2cm)，如需更高精度参见第七节。

### 舵机云台 (MG90S ×2)

旧方案 `PA3/PA4 -> MG90S` 作废。

| 用途 | MSPM0 引脚 | 说明 |
|---|---|---|
| 临时单舵机测试 | `PA12` | 已确认舵机可正常工作；但 `PA12` 正式用途是 TB6612 `PWMA`，不能作为最终云台脚 |
| 云台水平 X | `PA14` | 2026-07-03 已验证可驱动舵机 |
| 云台俯仰 Y | `PA17` | 2026-07-03 已验证可驱动舵机 |

> TI 官方 `LP-MSPM0G3507` 原理图显示：`PA2-/PA3-/PA4-/PA5-/PA6-` 到 MCU 真实脚之间分别经过默认不焊的隔离电阻，且 `PA3/PA4` 为 LFXT 晶振脚。因此不要再按旧方案把舵机信号接到 `PA3/PA4`。

### 修正后的巡线传感器分配 (方案A)

| MSPM0 引脚 | 传感器 | 说明 |
|---|---|---|
| **PB5** | S1 (最左) | GPIO 输入 |
| **PB6** | S2 | GPIO 输入 |
| **PB7** | S3 | GPIO 输入 |
| **PA7** | S4 (中间) | GPIO 输入 |
| **PA8** | S5 | GPIO 输入 |
| **PB9** | S6 | GPIO 输入 |
| **PB10** | S7 (最右) | GPIO 输入 |

### 编码器 (WHEELTEC R3X, 500线GMR)

| MSPM0 引脚 | 编码器 | 说明 |
|---|---|---|
| **PB12** | 左轮 A相 | GPIO 中断 (A相双沿计数) |
| **PB13** | 左轮 B相 | GPIO 输入 (判断方向) |
| **PB14** | 右轮 A相 | GPIO 中断 (A相双沿计数) |
| **PB15** | 右轮 B相 | GPIO 输入 (判断方向) |

> GMR 编码器为推挽输出，无需上拉电阻。
> 当前代码只对 A 相双沿计数、B 相判方向，初始按 500线 × 30减速比 × 2 = 30000 计数/轮圈，最终需手转一圈校准。

### UART 通信 (OpenMV)

| MSPM0 引脚 | 外设功能 | OpenMV 引脚 | 说明 |
|---|---|---|---|
| **PA10** | UART0 TX | P5 (RX) | MSPM0→OpenMV 请求 |
| **PA11** | UART0 RX | P4 (TX) | OpenMV→MSPM0 坐标数据 |

> 波特率 115200, 8N1。原配置 PA12 为 TX 是错误的 (PA12 已用于 TIMG0)。
> OpenMV H7 GPIO 为 3.3V 电平、5V 耐受，与 MSPM0 (3.3V) 直连无需电平转换。

### I2C (MPU6050, 可选)

| MSPM0 引脚 | 外设功能 | MPU6050 引脚 | 说明 |
|---|---|---|---|
| **PB2** | I2C1 SDA | SDA | ⚠️ 与 BIN1 冲突 |
| **PB3** | I2C1 SCL | SCL | ⚠️ 与 BIN2 冲突 |

> ⚠️ I2C1 在 PB2/PB3，与电机方向引脚冲突。
> `PA0/PA1` 可作为 I2C0 候选，但它们是 5V tolerant open-drain，需要确认 `J19/J20` 上拉和 `J4` LED 连接状态。
> **建议**: 暂不使用 MPU6050，用编码器里程计替代；如必须使用，优先评估 `PA0/PA1` I2C0，而不是占用 `PB2/PB3`。

### 按键与指示灯

| MSPM0 引脚 | 功能 | 说明 |
|---|---|---|
| **PB8** | MODE 按键 | GPIO 中断 (下降沿)，循环选择模式 |
| **PB11** | START 按键 | GPIO 中断 (下降沿)，启动/停止 |
| **PA15** | LED 状态指示 | GPIO 输出，闪烁指示当前模式 |

### 激光模块

| MSPM0 引脚 | 功能 | 说明 |
|---|---|---|
| 待定 | 激光 TTL/EN 控制 | 只能接带 `TTL/EN/S` 的控制脚，且必须重新选非 SWD、已验证可达 GPIO |

> `PA20` 是 `SWCLK` 调试脚，不再作为激光控制脚。两线激光模块不能直接接 GPIO 供电。

---

## 三、最终引脚分配总表 (无冲突版)

| 引脚 | 功能 | 方向 | 外设 |
|---|---|---|---|
| PA2 | 暂不使用 | - | 原巡线口不可用 |
| PA3 | 禁用 | - | LFXIN/DNC，旧舵机方案作废 |
| PA4 | 禁用 | - | LFXOUT/DNC，旧舵机方案作废 |
| PA5 | 暂不使用 | - | 原巡线口不可用 |
| PA6 | 暂不使用 | - | 原巡线口不可用 |
| PA7 | 巡线 S4 | 输入 | GPIO |
| PA8 | 巡线 S5 | 输入 | GPIO |
| PA10 | UART TX | 输出 | UART0 TX |
| PA11 | UART RX | 输入 | UART0 RX |
| PA12 | 电机L PWM | 输出 | TIMG0 CCP0 |
| PA13 | 电机R PWM | 输出 | TIMG0 CCP1 |
| PA14 | 云台水平 X 舵机 | 输出 | GPIO 软件 PWM |
| PA15 | LED | 输出 | GPIO |
| PA17 | 云台俯仰 Y 舵机 | 输出 | GPIO 软件 PWM |
| PA20 | 禁用普通外设 | - | SWCLK 调试脚 |
| PB0 | AIN1 | 输出 | GPIO |
| PB1 | AIN2 | 输出 | GPIO |
| PB2 | BIN1 | 输出 | GPIO |
| PB3 | BIN2 | 输出 | GPIO |
| PB4 | STBY | 输出 | GPIO |
| PB5 | 巡线 S1 | 输入 | GPIO |
| PB6 | 巡线 S2 | 输入 | GPIO |
| PB7 | 巡线 S3 | 输入 | GPIO |
| PB8 | MODE键 | 输入 | GPIO INT |
| PB9 | 巡线 S6 | 输入 | GPIO |
| PB10 | 巡线 S7 | 输入 | GPIO |
| PB11 | START键 | 输入 | GPIO INT |
| PB12 | 左编码器A | 输入 | GPIO INT |
| PB13 | 左编码器B | 输入 | GPIO |
| PB14 | 右编码器A | 输入 | GPIO INT |
| PB15 | 右编码器B | 输入 | GPIO |

> 共使用 26 个 GPIO，MSPM0G3507 有 40+ GPIO，资源充裕。

---

## 四、电源系统设计

### 供电架构

```
2S 18650 7.4V
      │
      ├── 双路开关1 (控制回路) ──→ TB6612 VM ──→ 驱动左右电机
      │         │                      │
      │         │                 TB6612 VCC ← 3.3V (AMS1117)
      │         │
      │         └──→ AMS1117-3.3V ──→ LaunchPad 3.3V 引脚
      │                                    │
      │                    ┌───────────────┼───────────────┐
      │                    │               │               │
      │              MSPM0G3507      TCRT5000 ×7      编码器 ×2
      │              (3.3V)          (3.3V, ~140mA)   (3.3V)
      │
      └── 双路开关2 (瞄准回路) ──→ MP1584 DC-DC (7.4V→5V, 3A)
                                          │
                          ┌───────────────┼───────────────┐
                          │               │               │
                      MG90S ×2        OpenMV H7       激光模块
                    (5V, ~1.5A pk)   (5V, 250mA)     (3.3V,
                                                      LaunchPad引出,
                                                      GPIO控制)
```

> **为什么舵机和 OpenMV 不从 TB6612 板载 5V 取电？**
> WHEELTEC R3X 套件中的 TB6612 驱动板自带 5V 稳压输出，但输出电流通常 <800mA。
> 双舵机同时动作峰值可达 1.5A，加上 OpenMV (~250mA) 后峰值 ~1.8A，远超板载稳压能力，
> 会导致电压跌落、舵机抖舵、OpenMV 重启。
> **方案**: 瞄准回路用独立的 MP1584 DC-DC 降压模块 (7.4V→5V, 3A 额定) 单独供电。

### 各模块供电需求

| 模块 | 电压 | 典型电流 | 峰值电流 | 供电来源 |
|---|---|---|---|---|
| MSPM0G3507 | 3.3V | 20mA | 50mA | AMS1117-3.3V (电池 7.4V → 3.3V) |
| TB6612FNG (VM) | 7.4V | — | 1.2A/通道 | 电池直连, 经开关1 |
| TT电机 ×2 | 6-7.4V | 200mA | 800mA | TB6612 输出 |
| MG90S ×2 | **5V** | 150mA | **750mA** (单只) | **MP1584 DC-DC (3A) 独立供电** |
| TCRT5000 ×7 | 3.3V | 70mA | 140mA | AMS1117-3.3V |
| OpenMV H7 | **5V** | 150mA | 250mA | **MP1584 DC-DC 5V** |
| 激光模块 | 3.3V | 20mA | 50mA | AMS1117-3.3V (或模块自带 3.3V) |
| 编码器 ×2 | 3.3V | 10mA | 20mA | AMS1117-3.3V |
| **合计** | | **~570mA** | **~3.5A** | |

> **电池建议**: 2S 18650 7.4V, 2600mAh 以上 (松下 3400mAh 或三星 2600mAh)。
> 18650 锂离子电池不受北京航空件限制，比 LiPo 更方便运输。

### MP1584 DC-DC 模块配置

| 参数 | 设定 |
|---|---|
| 输入 | 7.4V (2S 电池, 经开关2) |
| 输出 | **5.0V** |
| 额定电流 | 3A |
| 用途 | MG90S ×2 + OpenMV H7 |
| 滤波 | 输入/输出端各并 100μF 电解 + 0.1μF 陶瓷 |

> 调节 MP1584 模块上的蓝色电位器，用万用表确认输出为 5.0V ±0.1V 后再接入负载。
> 模块先调好电压，再接舵机和 OpenMV，避免过压烧毁。

---

## 五、TB6612FNG 接线详图

```
                    TB6612FNG 模块
                 ┌──────────────────┐
    VM (7.4V) ───┤ VM          AO1 ├──→ 左电机 +
                 │                  │
    GND ─────────┤ GND         AO2 ├──→ 左电机 -
                 │                  │
    PB0 ─────────┤ AIN1        BO1 ├──→ 右电机 +
                 │                  │
    PB1 ─────────┤ AIN2        BO2 ├──→ 右电机 -
                 │                  │
    PB2 ─────────┤ BIN1           │
                 │                  │
    PB3 ─────────┤ BIN2    5V OUT ├──→ 单舵机测试可用；双舵机/OpenMV需带载验证
                 │                  │
    PA12 ────────┤ PWMA           │
                 │                  │
    PA13 ────────┤ PWMB           │
                 │                  │
    PB4 ─────────┤ STBY           │
                 └──────────────────┘

真值表:
  AIN1=H, AIN2=L, PWM>0 → 左电机正转
  AIN1=L, AIN2=H, PWM>0 → 左电机反转
  AIN1=H, AIN2=H, PWM>0 → 刹车
  STBY=L → 全部停止
```

---

## 六、分步上电验证流程 (防烧毁)

> ⚠️ 严格按照顺序操作，每步确认后再进行下一步。

### 第0步: 目视检查 + 电源预调 (不通电)

- [ ] 检查所有焊点有无虚焊、短路
- [ ] 用万用表测量电池电压 (应为 7.4-8.4V)
- [ ] 用万用表测量各模块 VCC-GND 之间有无短路
- [ ] **MP1584 模块预调**: 输入端临时接电池 7.4V, 调蓝色电位器使输出为 **5.0V ±0.1V**, 调好后断开电池
- [ ] AMS1117-3.3V 模块预调: 输入端临时接电池 7.4V, 确认输出为 3.3V

### 第1步: LaunchPad 单独上电

- [ ] USB 连接电脑，确认 CCS 能识别设备
- [ ] 下载一个 LED 闪烁测试程序
- [ ] 确认 3.3V 和 5V 引脚电压正常

### 第2步: 传感器模块测试 (不接电机)

- [ ] 7 个 TCRT5000 模块接 3.3V 供电
- [ ] **模拟输出模块 (BOM推荐)**: 用万用表测量 AO 引脚电压, 白纸上应 >2V (高反射), 黑线上应 <1V (低反射), 确认黑白对比度足够
- [ ] **数字输出模块 (XD-01)**: 用万用表测量 DO 引脚, 白纸上=LOW, 黑线上=HIGH; 调节每个模块的蓝色电位器使切换阈值合适
- [ ] 下载测试程序读取 7 路 GPIO/ADC 状态，串口打印

### 第3步: 舵机测试 (不接电机)

- [ ] MG90S ×2 接稳定 5V 输出；可用 MP1584/充电宝/TB6612 稳压板，但必须带载测压
- [ ] MG90S GND 与 LaunchPad GND 共地
- [ ] 信号线接已重新选定并通过常高/常低测试的 GPIO；不要接 PA3/PA4
- [ ] 下载测试程序: 输出 1500μs (中位)，确认舵机归中
- [ ] 测试 500-2500μs 范围，确认舵机转动平滑无抖舵
- [ ] 双舵机同时快速摆动，用万用表监测 MP1584 输出，确认 5V 不跌落 >0.3V

### 第4步: 电机驱动测试 (不装轮胎)

- [ ] TB6612 接电池 7.4V (VM)
- [ ] STBY 接 HIGH
- [ ] 先不接 PWM，只测试方向引脚: AIN1=H, AIN2=L → 电机应转动
- [ ] 接 PWM (PA12)，从低占空比 (10%) 开始，逐步增大
- [ ] 确认两个电机都能正反转
- [ ] 测试刹车 (AIN1=H, AIN2=H)

### 第5步: 编码器测试

- [ ] **推荐方法 (无需示波器)**: 下载测试程序, GPIO 双沿中断计数, 手转一圈, 串口打印脉冲数
- [ ] WHEELTEC R3X (500线 GMR, 1:30减速): 手转输出轴一圈 → 应计 ~60000 边沿 (500×30×4倍频)
- [ ] 如只有万用表: A/B 相分别对 GND 测量, 慢转电机时应看到电压在 0V 和 3.3V 之间交替变化
- [ ] 正转时 A 相应超前 B 相 90°, 确认方向判断正确

### 第6步: OpenMV 通信测试

- [ ] OpenMV 接 MP1584 5V 供电
- [ ] **重要**: 拔掉 LaunchPad 上 J21(TX) 和 J22(RX) 跳线帽，断开 XDS110 调试器与 UART0 的连接，避免调试器干扰 OpenMV 通信帧
- [ ] OpenMV P4(TX) → PA11 (MSPM0 RX), OpenMV P5(RX) → PA10 (MSPM0 TX)
- [ ] OpenMV 连接电脑 USB 下载颜色追踪脚本, 下载完成后拔掉 USB 只保留 5V 供电
- [ ] 下载 MSPM0 测试程序: 发送请求帧, 接收坐标数据, 串口打印 (调试用 SWO 或 LED 闪烁, 不用 UART0)
- [ ] 或者: OpenMV 仍用 USB 供电, 先不接 MSPM0 TX (PA10), 用电脑串口助手验证 OpenMV 自发数据帧格式正确, 再接回 MSPM0

### 第7步: 激光模块测试

- [ ] 激光模块供电: 如模块为 5V 规格接稳定 5V, 如为 3.3V 规格接 3.3V
- [ ] 若模块只有 `VCC/GND` 两线，不接 MSPM0 GPIO，先手动供电验证
- [ ] 若模块有 `TTL/EN/S` 控制脚，控制脚接重新选定的非 SWD GPIO；不要接 PA20
- [ ] 确认光斑直径 ≤0.5cm (调焦)

### 第8步: 整机联调

- [ ] 装轮胎，放在赛道上
- [ ] 测试巡线 (基本要求1)
- [ ] 测试静态瞄准 (基本要求2/3)
- [ ] 测试行进中瞄准 (发挥部分)

---

## 七、硬件注意事项与保护电路

### 7.1 巡线传感器: 模拟 vs 数字方案

BOM 推荐购买**分立 TCRT5000 模拟输出 (AO)** 模块，可通过加权平均算法获得亚毫米级位置精度。
但方案 A 选用的 7 个 GPIO (PB5-PB7, PA7-PA8, PB9-PB10) 只按数字输入使用，只读取 TCRT5000 模块 DO 输出。

| | 模拟方案 | 数字方案 (当前) |
|---|---|---|
| 精度 | 亚毫米 (加权平均) | ~1.2cm (仅知第几路压线) |
| ADC 需求 | 7 通道 | 0 |
| 模块 | 分立 TCRT5000 AO | XD-01 带 LM393 比较器 |
| 引脚 | 需改用 ADC 引脚 (PA14-PA25) | 当前 GPIO 即可 |

**建议**: 如需使用模拟方案，将巡线传感器全部改接到有 ADC 功能且未被占用的引脚 (例如 PA18、PA21-PA25 等；PA14/PA17 已给舵机)，
使用 `adc12_sequence_conversion` 循环采集 7 通道。

### 7.2 UART0 调试冲突

PA10/PA11 同时连接了 OpenMV 和 XDS110 调试器虚拟串口。开发时必须注意:

- **开发调试时**: 拔掉 LaunchPad 上 J21(TX) 和 J22(RX) 跳线帽，断开调试器，OpenMV 独占 UART0
- **需要 printf 调试时**: 插回跳线帽，断开 OpenMV 的 TX/RX 连接
- `PB4` 已用于 TB6612 `STBY`，`PB5` 已用于巡线 S1，因此当前不能再用 `UART1(PB4/PB5)` 接 OpenMV。

### 7.3 保护电路

```
电池 7.4V+ ──┬── SS14 肖特基二极管 (防反接) ──→ 双路开关
             │    (阳极朝电池+, 阴极朝负载)
             │
电池 7.4V- ──┴── GND

电机端:
  TB6612 AO1/AO2 之间并 0.1μF 陶瓷电容 (吸收换向火花)
  TB6612 BO1/BO2 之间并 0.1μF 陶瓷电容
```

| 保护措施 | 位置 | 说明 |
|---|---|---|
| SS14 肖特基二极管 | 电池输出端 | 反接时截止, 防止烧毁 TB6612/AMS1117 |
| 1000μF/16V 电解 ×2 | TB6612 VM 端 + MP1584 输出端 | 吸收电流尖峰 |
| 0.1μF 陶瓷电容 ×N | **每个模块** VCC-GND 旁 | 高频去耦, 紧贴模块电源引脚焊接 |
| 100μF 电解 ×2 | AMS1117 输入/输出端 | 低频滤波 |

> SS14 (1A 40V) 约 0.2 元/只，串在电池正极输出端。如果电池接头本身有防反插设计 (如 XT30 接头)，可省略。

### 7.4 MG90S 信号电平

MSPM0 输出 3.3V PWM，MG90S 供电 5V。当前已用 `PA12` 临时验证单舵机能正常动作，说明 3.3V 信号幅度在这套舵机场景下可用。
正式云台不要用 `PA12`，也不要回到 `PA3/PA4`；应先选新 GPIO 并做常高/常低可达性测试。

### 7.5 编码器引脚确认

当前代码使用 `PB12-PB15`。不要再按旧版本文档接 `PC0-PC3`：本地 SDK 没有 `GPIOC` 端口对象，代码写 `PC0-PC3` 会编译失败。

### 7.6 共地要求

所有模块的 GND 必须连通 (共地):
- LaunchPad GND ↔ TB6612 GND ↔ MP1584 GND ↔ MG90S GND ↔ OpenMV GND
- 电池负极 → 所有 GND
- 功率地 (电机/舵机) 和信号地 (传感器/OpenMV) 在电池负极处**单点汇合**，减少电机噪声干扰传感器

---

## 八、与原配置的差异汇总

| 项目 | 原 config.h (错误) | 修正后 | 原因 |
|---|---|---|---|
| 巡线传感器 | PA0-PA6 (ADC) | PB5-PB7,PA7,PA8,PB9,PB10 (GPIO) | 当前用数字 DO 方案；PA2/PA5/PA6 暂列不可用 |
| 电机 PWM | PB6/PB7 (TIMG0) | PA12/PA13 (TIMG0) | PB6/PB7 不是 TIMG0 输出 |
| 舵机 PWM | PA8/PA9 (TIMG2) | PA14/PA17 | `PA3/PA4` 已因 LaunchPad DNC/晶振脚作废；`PA12` 仅为临时单舵机测试 |
| UART TX | PA12 | PA10 | PA12 已被 TIMG0 CCP0 占用 |
| UART RX | PA11 | PA11 | 无变化 |
| I2C | PB8/PB9 (I2C0) | 暂不使用 | I2C0 固定在 PA0/PA1 |
| MODE按键 | PA13 | PB8 | PA13 已被 TIMG0 CCP1 占用 |
| START按键 | PA14 | PB11 | PA14 已作为云台水平舵机信号脚 |
| 激光 | PA10 | 待定 | PA10 已被 UART0 TX 占用；PA20 是 SWCLK 调试脚，不建议使用 |
| 编码器 | PC0-PC3 | PB12-PB15 | SDK 无 GPIOC 对象，改用真实可写的 GPIOB 引脚 |
| 舵机供电 | TB6612 板载 5V OUT | 稳定 5V，必须带载测压 | 单舵机已验证 TB6612 5V 可用；双舵机/OpenMV 需重新带载验证 |
| OpenMV 供电 | 3.3V | 5V (MP1584) | VIN 经 LDO 降压, 输入需 ≥3.6V; 3.3V 直供不稳 |
| 激光供电 | 5V | 按模块规格供电 | 未确认 TTL/EN 前不要接 MCU GPIO |
---

## 2026-07-02 最新修正：PA2~PA6 与舵机信号脚

TI 官方 `LP-MSPM0G3507` 原理图确认：`PA2-/PA3-/PA4-/PA5-/PA6-` 到 MCU 真实引脚之间分别经过 `R9/R10/R11/R15/R17`，这些电阻默认标注为 `DNC`，即未焊接。并且：

- `PA2_ROSC` 带 `R8=100k 0.1%` 到 GND。
- `PA3/PA4` 接 32.768kHz LFXT 晶振。
- `PA5/PA6` 接 40MHz HFXT 晶振。
- `PA7` 不属于这一组晶振/ROSC 隔离脚，应单独按当前接线和代码核查。

因此，本文档中旧的“`PA3/PA4` 作为 MG90S 舵机 PWM 信号脚”的方案作废。后续舵机信号脚必须重新选用已确认从 LaunchPad 排针可达、且不与电机/循迹/OpenMV 冲突的 GPIO/PWM 脚。
