jlg006728/electronic-design-contest/器件采购链接汇总.md

# 器件采购链接汇总

> 对应 BOM: [器件采购清单.md](器件采购清单.md)
> 价格为 2026 年参考价，以实际购买为准
> **每个商品均标注了链接 + 所选款式/规格**

---

## 一、主控与开发

| # | 物品 | 链接 | 所选款式 | 参考价 |
|---|---|---|---|---|
| 1 | LP-MSPM0G3507 LaunchPad | https://www.digikey.cn/zh/products/detail/texas-instruments/LP-MSPM0G3507/20512419 | **直接购买**（唯一规格） | ~170 |
| 2 | 杜邦线 公母/母母/公公 ×3盒 | https://item.taobao.com/item.htm?id=542554387425 | **20CM公对母**、**20CM母对母**、**20CM公对公** 各1盒 | ~15 |
| 3 | Micro-USB 数据线 1米 | https://pcdetail.taobao.com/RTFtbHBOYXlKSmdaSVVFNkFHcE81QT09.html | **1米 · microUSB公头数据线（4芯）** | ~5 |
| 4 | 按键 6×6×9.5mm 铜脚直插 ×4 | https://youxin-electronic.taobao.com | 进店后点 **"所有宝贝"**，页内找到 **6×6×9.5mm 轻触开关 铜脚 直插** 加入购物车 ×4 | ~2 |
| 5 | LED 5mm 翠绿 + 330Ω 电阻 | https://youxin-electronic.taobao.com | 同上店内找到 **5mm 翠绿 LED** + **330Ω 1/4W 电阻** 加入购物车 | ~3 |
| 6 | 排针 2.54mm 40P | ⚠️ **搁置**，先不买 | — | — |

---

## 二、巡迹传感器

| # | 物品 | 链接 | 所选款式 | 参考价 |
|---|---|---|---|---|
| 7 | TCRT5000 红外模块（分立·模拟输出） ×8 | https://item.taobao.com/item.htm?id=522577760881 | **独立小板 · 带AO模拟输出**（4Pin VCC/GND/DO/AO） | ~24 |
| 7b | 洞洞板 5×7cm 单面覆铜 ×2 | https://e.tb.cn/h.R0ySCceS1lM8Hle?tk=o7Kj5JLnZ54 | **"PCB洞洞板 实验万能喷锡板" · 选 5×7cm 洞洞板（有孔）**，不要选成无孔的覆铜板 | ~3 |
| 8 | MPU6050 GY-521 | https://www.taobao.com/list/item/21261751847 | **紫色小板 GY-521 · 直针向下 · 原装芯片 · 镀金焊盘** | ~7 |

---

## 三、小车底盘与动力

| # | 物品 | 链接 | 所选款式 | 参考价 |
|---|---|---|---|---|
| 9 | WHEELTEC R3X系列三轮小车 | https://www.taobao.com/list/item/678732300498.htm | **车型**: R3X系列三轮小车<br>**编码器**: 500线GMR<br>**减速比**: 1:30<br>**驱动模块**: 1个TB6612带稳压<br>**加高**: 不加高 | ~144 |

---

## 四、舵机与云台

| # | 物品 | 链接 | 所选款式 | 参考价 |
|---|---|---|---|---|
| 10 | MG90S 黑色铝齿 模拟舵机 180° ×2 | https://pcdetail.taobao.com/MngrUmVGTHpCUkE1cyt6cG1GQWoxQT09.html | **MG90S 黑色铝齿 模拟舵机 180°**（2.2kg·cm，≠ 数码舵机 ≠ 铜齿款） | ~30 |
| 11 | 二维舵机云台支架 | https://www.taobao.com/list/item/678825663279.htm | 选 **"二维电动云台 二自由度 支架 TI杯"**（¥32，700+人付款款） | ~15 |
| 12 | 激光固定件 | https://world.taobao.com/item/UzYrOVBCRzFINTlnRFdERWxmMVlzdz09.htm | **12mm激光模组固定支架 360°可调**（夹持12mm激光头，固定到云台；也可先用热熔胶+扎带替代） | ~5 |

---

## 五、视觉模块

| # | 物品 | 链接 | 所选款式 | 参考价 |
|---|---|---|---|---|
| 13 | OpenMV Cam H7 | https://item.taobao.com/item.htm?id=612497720394 | **星瞳科技官方 · H7标准版（OV5640）** | ~380 |
| 14 | FPC 排线 15cm 15P | — | ⚠️ **选配**：H7标准版摄像头集成在主板上，不需要排线；仅 H7 Plus 分离式摄像头需要 | ~0 |
| 15 | MicroSD 32GB Class10 | https://pcdetail.taobao.com/993c4d367c253f5d16c2563468c324b1.html | **闪迪 32GB TF Class10 高速** | ~25 |

---

## 六、激光与靶面

| # | 物品 | 链接 | 所选款式 | 参考价 |
|---|---|---|---|---|
| 16 | 405nm 激光头 ≤10mW 可调焦 ×2 | https://m.1688.com/huo/detail-558182761958.html | 1688选 **"9×30mm 405nm 10mW 内调焦点状 蓝紫色激光模组"**<br>或到优信电子店内找 **"405nm 10mW 可调焦 激光头"** | ~30 |
| 17 | UV 感光纸 A4 ×20张 | https://www.taobao.com/list/item/522577760881 | 在TCRT5000卖家店内或电赛器材店选 **"白色UV紫外线感光纸 A4 可反复使用"** | ~60 |
| 18 | 红色记号笔 0.05mm ×3 | https://youxin-electronic.taobao.com | 优信电子店内找 **"0.05mm 红色 油性 细笔 记号笔"**（樱花/Mitsubishi） | ~15 |
| 19 | 圆规 金属 | https://youxin-electronic.taobao.com | 优信电子或文具店选 **"金属圆规 铅芯"** | ~10 |

---

## 七、电源系统

| # | 物品 | 链接 | 所选款式 | 参考价 |
|---|---|---|---|---|
| 20 | 18650锂电池 ×2 | https://youxin-electronic.taobao.com | **松下 3400mAh** 或 **三星 2600mAh** 18650 平头（替代 LiPo，北京航空件不受限） | ~35 |
| 20b | 2S 18650串联电池盒 | https://youxin-electronic.taobao.com | **带 DC5.5 公头，输出 7.4V**（免焊接装电池） | ~6 |
| 20c | 18650双槽充电器 | https://youxin-electronic.taobao.com | **USB供电 双槽充电器**（普通USB充电器，非B3平衡充） | ~15 |
| 21 | 5V 3000mAh 充电宝型 | https://www.taobao.com/list/item/21261751847 | 在MPU6050卖家店内或数码店选 **小米/罗马仕 5000mAh 迷你款** | ~30 |
| 22 | AMS1117-3.3V 模块 ×2 | https://world.taobao.com/item/13301101281.htm | **AMS1117-3.3V 稳压模块** ×2 | ~6 |
| 23 | MP1584 DC-DC 可调 | https://youxin-electronic.taobao.com | 优信电子店内找 **"MP1584 DC-DC 降压模块 可调"**（红色小板） | ~8 |
| 24 | 拨动开关 SS-12F23 ×2 | https://youxin-electronic.taobao.com | 优信电子店内找 **"SS-12F23 拨动开关 2档6脚"** ×2 | ~4 |
| 25 | LED 红蓝 5mm + 1kΩ 电阻 | https://youxin-electronic.taobao.com | 优信电子店内找 **"5mm 红色LED"** + **"5mm 蓝色LED"** + **"1kΩ 1/4W 电阻"** | ~2 |
| 26 | 电解电容 1000μF/16V ×3 | https://item.szlcsc.com/48682003.html | **立创商城 · KNSCHA 1000μF 16V 直插** ×3 | ~6 |
| 27 | 电容 100μF + 0.1μF 各5 | https://item.szlcsc.com/43655907.html | **立创商城** 找 **"100μF 16V 电解"** + **"0.1μF 104 陶瓷电容"** 各5 | ~5 |

---

## 八、结构件与紧固件

| # | 物品 | 链接 | 所选款式 | 参考价 |
|---|---|---|---|---|
| 28 | 铜柱 M3×10 + M3×20 各10 | https://mall.dfrobot.com.cn/goods-912.html | **DFRobot M3×20六角铜柱（带螺丝螺帽）10套** + 另购 M3×10款 | ~10 |
| 29 | 螺丝螺母 M3 套装 | https://pcdetail.taobao.com/Vlhkc212K0VHOWRQOWFnYVdIb1NxUT09.html | **固万基旗舰店 · 304不锈钢 M3螺丝螺母套装**（选M3*6+M3*10+M3*20各若干） | ~10 |
| 30 | 扎带 3×100mm | https://youxin-electronic.taobao.com | 优信电子店内找 **"尼龙扎带 3×100mm"** | ~5 |
| 31 | 热缩管 φ2+φ3+φ5 | https://youxin-electronic.taobao.com | 优信电子店内找 **"热缩管 套装 2mm 3mm 5mm 各1米"** | ~9 |

---

## 九、工具与耗材

| # | 物品 | 链接 | 所选款式 | 参考价 |
|---|---|---|---|---|
| 32 | 936 恒温焊台 | https://pcdetail.taobao.com/2f9b62f6a8767c75ddba4111461bf5b9.html | **YIHUA 谊华 936 · 标准套餐** | ~86 |
| 33 | 焊锡丝 0.6mm 100g | https://youxin-electronic.taobao.com | 优信电子店内找 **"0.6mm 焊锡丝 含松香 100g"** | ~15 |
| 34 | 数字万用表 DT9205A | https://pcdetail.taobao.com/e0ad9f89ed2eebff7a26073790464d10.html | **ANTELVES DT9205A 高精度防烧**（¥23.8） | ~24 |
| 35 | 热熔胶枪 20W | https://sg.world.taobao.com/item/763628403969.htm | **绿林 20W豪华小胶枪 + 15根胶棒**（天猫绿林旗舰店） | ~15 |
| 36 | 剥线钳 | https://www.taobao.com/list/item/745036549095.htm | **绿林多功能剥线钳** 或 **得力工业级** | ~15 |
| 37 | 电布胶带 3M 黑色 | https://world.taobao.com/item/13351832221.htm | **3M 1500# 电气绝缘胶带 黑色 18mm×10m** | ~5 |
| 38 | 面包板 830孔 + 跳线 | https://pcdetail.taobao.com/ditsT2t2dHI3Qm5aL3ZycC92WCtYdz09.html | **MB-102 830孔面包板 + 65根跳线 + 电源模块** 套餐 | ~12 |
| 39 | BB响 电压检测器 1-8S | https://youxin-electronic.taobao.com | 优信电子店内找 **"BB响 航模 锂电池 电压检测 1-8S"** | ~8 |

---

## 快捷购买清单 — 按优先级

### P0 — 必需，先下单

| 商品 | 链接 | 所选款式 |
|---|---|---|
| WHEELTEC R3X 小车套件 | https://www.taobao.com/list/item/678732300498.htm | R3X三轮+500线GMR+1:30+TB6612带稳压+不加高 |
| LaunchPad (DigiKey) | https://www.digikey.cn/zh/products/detail/texas-instruments/LP-MSPM0G3507/20512419 | 直接购买 |
| 18650锂电池 ×2 + 电池盒 + 充电器 | https://youxin-electronic.taobao.com | 松下3400mAh+2S串联电池盒+USB充电器 |
| 936 焊台 谊华 | https://pcdetail.taobao.com/2f9b62f6a8767c75ddba4111461bf5b9.html | 936 标准套餐 |

### P1 — 核心功能

| 商品 | 链接 | 所选款式 |
|---|---|---|
| OpenMV H7 星瞳官方 | https://item.taobao.com/item.htm?id=612497720394 | H7标准版(OV5640) |
| TCRT5000 ×8 | https://item.taobao.com/item.htm?id=522577760881 | 独立小板·模拟输出 |
| MG90S 舵机 ×2 | https://pcdetail.taobao.com/MngrUmVGTHpCUkE1cyt6cG1GQWoxQT09.html | 黑色铝齿 模拟舵机 180° |
| MPU6050 GY-521 | https://www.taobao.com/list/item/21261751847 | 紫色小板 |
| 面包板 830孔 套件 | https://pcdetail.taobao.com/ditsT2t2dHI3Qm5aL3ZycC92WCtYdz09.html | MB-102+跳线+电源模块 |
| 万用表 DT9205A | https://pcdetail.taobao.com/e0ad9f89ed2eebff7a26073790464d10.html | 高精度防烧 |
| 杜邦线 ×3盒 | https://item.taobao.com/item.htm?id=542554387425 | 20cm 公对母/母对母/公对公 各1盒 |

### P2 — 辅助与备用

| 商品 | 链接 | 所选款式 |
|---|---|---|
| MicroSD 32GB | https://pcdetail.taobao.com/993c4d367c253f5d16c2563468c324b1.html | 闪迪 32GB Class10 |
| Micro-USB 线 | https://pcdetail.taobao.com/RTFtbHBOYXlKSmdaSVVFNkFHcE81QT09.html | 1米·4芯数据线 |
| 热熔胶枪 绿林 | https://sg.world.taobao.com/item/763628403969.htm | 20W+15根胶棒 |
| 3M 电工胶带 | https://world.taobao.com/item/13351832221.htm | 1500# 黑色 |
| AMS1117-3.3V ×2 | https://world.taobao.com/item/13301101281.htm | 稳压模块 |
| 螺丝螺母 M3 套装 | https://pcdetail.taobao.com/Vlhkc212K0VHOWRQOWFnYVdIb1NxUT09.html | 固万基 304不锈钢 M3 |
| 电解电容 1000μF/16V | https://item.szlcsc.com/48682003.html | 立创商城 KNSCHA |

### 优信电子批量采购

以下物品可在 **优信电子** (https://youxin-electronic.taobao.com) 一次买齐：

| 商品 | 店内查找 |
|---|---|
| 按键 6×6×9.5mm ×4 | "6x6x9.5 轻触开关 铜脚" |
| LED 5mm 翠绿 + 330Ω | "5mm 翠绿 LED" + "330Ω 电阻" |
| 洞洞板 5×7cm ×2 | "5x7cm 洞洞板 单面覆铜" |
| MP1584 DC-DC 可调 | "MP1584 DC-DC 降压模块" |
| 拨动开关 SS-12F23 ×2 | "SS-12F23 拨动开关" |
| LED 红蓝 5mm + 1kΩ | "5mm 红色 LED" + "5mm 蓝色 LED" + "1kΩ 电阻" |
| 扎带 3×100mm | "尼龙扎带 3×100mm" |
| 热缩管 φ2+φ3+φ5 | "热缩管 套装" |
| 焊锡丝 0.6mm 100g | "0.6mm 焊锡丝 含松香" |
| 红色记号笔 0.05mm | "0.05mm 红色 油性 细笔" |
| 圆规 | "金属圆规 铅芯" |
| BB响 1-8S | "BB响 航模 电压检测" |

### 立创商城配单

以下物品可在 **立创商城** (https://www.szlcsc.com) 批量配单：

| 商品 | 链接/编号 |
|---|---|
| 1000μF/16V 电解电容 ×3 | https://item.szlcsc.com/48682003.html |
| 100μF/16V 电解电容 ×5 | 立创搜 "100μF 16V 直插" |
| 0.1μF 104 陶瓷电容 ×5 | 立创搜 "0.1μF 104 陶瓷电容" |

---

> **说明**: 以上链接为搜索时有效链接，淘宝链接可能随时间失效。
> 如链接失效，建议：
> 1. 先到 **优信电子** (https://youxin-electronic.taobao.com) 店内找替代品
> 2. 再到 **WHEELTEC旗舰店**、**星瞳科技** 等品牌店购买专用品
> 3. 电阻电容散件去 **立创商城** (szlcsc.com) 配单更便宜
