jlg006728/electronic-design-contest/知识库/E题赛题完整要求.md

# E题 简易自行瞄准装置 — 完整赛题要求

> TI杯 2025年全国大学生电子设计竞赛 — E题 (本科组)

---

## 一、任务

设计制作一个简易自行瞄准装置，该装置包括自动寻迹小车及瞄准模块两部分。自动寻迹小车行驶必须采用TI MSPM0系列MCU（简称MSPM0）控制（包括巡迹、电机控制）；瞄准模块以小车为载体，利用二维云台控制蓝紫激光笔发射激光的方向，使激光光斑落在目标靶上，靶上光斑直径≤0.5cm。要求MSPM0控制器和瞄准模块的电源分别由两个独立开关控制。简易自行瞄准装置场景如图1所示。

---

## 场地规格 (图1)

| 参数 | 规格 |
|---|---|
| 轨迹外沿 | 100cm × 100cm 正方形 |
| 边线 | 黑色，线宽 1.8cm ± 0.2cm |
| 顶点 | A (左上)、B (右上)、C (左下)、D (右下) |
| 行驶方向 | 逆时针 |
| 靶面位置 | 距离 AB 线段外 50cm 处竖立 |
| 靶面朝向 | 与 AB 平行，高度 ≤50cm |
| 靶纸 | A4 幅面紫外感光纸 |
| 靶纸轮廓 | 1.8cm 宽黑色胶带沿四周边缘贴长方形 |
| 靶心 | 红色油性记号笔标点，直径 ≤0.1cm |
| 同心圆 | 以靶心为圆心，半径 2、4、6、8、10cm，红色圆弧线宽度 ≤0.1cm |

---

## 二、要求

### 1. 基本要求

**(1)** 小车可以沿行驶轨迹自动寻迹行驶，行驶圈数 N 可在 1~5 之间设定，行驶时间 t ≤20s。此时瞄准模块电源开关断开。

**(2)** 将小车放置在场地中，位置和姿态自定。启动瞄准模块在 2s 内发射激光击中靶心，要求光斑痕迹距靶心最大距离 D₁ ≤2cm。

**(3)** 将小车放置在行驶轨迹上的指定位置，瞄准方向任意指定。要求启动瞄准模块在 4s 内自动瞄准发射激光击中靶心，要求 D₁ ≤2cm。

### 2. 发挥部分

将小车放置在 AB 段轨迹上，前沿投影与 AC 线对齐，启动小车和瞄准模块，在 t 秒内沿轨迹自动寻迹行驶 N 圈，运动期间激光笔必须连续发光射向靶面，不满足要求不计成绩。

**(1)** 要求 N=1 圈，t≤20s，D₁≤2cm。

**(2)** 要求 N=2 圈，t≤40s，D₁≤2cm。

**(3)** 要求 N=1 圈，t≤20s，激光笔沿靶面上半径 6cm 的红色圆弧同步画圆，光斑痕迹与半径 6cm 的红色圆弧线最大距离 D₂≤2cm；小车行驶 1 圈，正好画 1 圈光斑，同步误差必须小于 1/4 圈。

**(4)** 其他。

### 3. 说明

> 注：原题"三、说明"部分内容未在已保存图片中完整显示，以下为根据上下文推断的常见说明条款，待补充确认。

---

## 评分标准 (总分 120分)

### 设计报告 (20分)

| 项目 | 主要内容 | 满分 |
|---|---|---|
| 系统方案 | 简易自行瞄准装置控制总体方案设计 | 4 |
| 理论分析与计算 | 自行瞄准装置性能分析与计算 | 6 |
| 电路与程序设计 | 总体电路图 / 程序设计 | 4 |
| 测试方案与测试结果 | 测试数据完整性 / 测试结果分析 | 4 |
| 设计报告结构及规范性 | 摘要、设计报告正文的结构 / 图表的规范性 | 2 |
| **合计** | | **20** |

### 基本要求 (50分)

| 项目 | 满分 |
|---|---|
| 完成 (1) | 10 |
| 完成 (2) | 20 |
| 完成 (3) | 20 |
| **合计** | **50** |

### 发挥部分 (50分)

| 项目 | 满分 |
|---|---|
| 完成 (1) | 15 |
| 完成 (2) | 15 |
| 完成 (3) | 15 |
| 其他 | 5 |
| **合计** | **50** |

---

## 关键指标速查

| 指标 | 要求 | 对应项 |
|---|---|---|
| 巡迹圈数 N | 1~5 可设定 | 基本(1) |
| 单圈行驶时间 t | ≤20s | 基本(1) |
| 激光启动瞄准时间 | ≤2s | 基本(2) |
| 指定位置瞄准时间 | ≤4s | 基本(3) |
| 光斑距靶心距离 D₁ | ≤2cm | 全部 |
| 靶上光斑直径 | ≤0.5cm | 任务要求 |
| 画圆半径 | 6cm | 发挥(3) |
| 画圆偏差 D₂ | ≤2cm | 发挥(3) |
| 同步误差 | < 1/4 圈 | 发挥(3) |
| 发挥部分2圈时间 | ≤40s | 发挥(2) |

---

## 图片来源

本文件内容从以下图片提取（子agent读取）：

| 图片文件 | 内容 |
|---|---|
| topic_202507302760.png | 任务描述 + 场景图 (图1) |
| topic_202507308972.png | 场地规格 + 基本要求(1)(2) |
| topic_202507302929.png | 基本要求(3) + 发挥部分 |
| topic_202507309889.png | 评分标准表 |
| topic_202507309258.png | 评分标准表 (另一视角) |
