jlg006728/electronic-design-contest/知识库/电机驱动/TT直流减速电机_编码器规格.md

# TT直流减速电机 + 霍尔编码器 规格书

## 电机规格

| 参数 | 典型值 (1:48减速) | 典型值 (1:120减速) |
|---|---|---|
| 额定电压 | 6V | 6V |
| 工作电压范围 | 3~12V | 3~7.5V |
| 空载转速 @6V | 300±10% RPM | 160 RPM |
| 空载转速 @3V | 150±10% RPM | 60 RPM |
| 空载电流 @6V | 90~120mA | 170mA |
| 额定负载电流 | 160mA | — |
| 堵转电流 | **2.8A** | **2.8A** |
| 堵转扭矩 | ~1.0 kgf·cm | 0.8 kgf·cm |
| 额定扭矩 | — | 0.2 kgf·cm |
| 重量 | ~50g | 50g |

## 编码器规格

| 参数 | 数值 |
|---|---|
| 类型 | 霍尔传感器 (AB相正交) |
| 工作电压 | 3.3V ~ 5V |
| 线数 | 8~60线/转 (取决于型号) |
| 信号类型 | 正交方波 (A/B相) |
| 每转脉冲 (4倍频) | 线数 × 4 (如13线: 52脉冲/转) |

### 编码器接线 (6P)

| 引脚 | 功能 | 颜色 |
|---|---|---|
| M- | 电机负极 | 黑 |
| M+ | 电机正极 | 红 |
| Vcc | 编码器供电 | 红/白 |
| H1 (A) | A相输出 | 黄 |
| H2 (B) | B相输出 | 绿 |
| GND | 编码器地 | 黑/蓝 |

## 转速计算

```
// M法测速
#define PULSE_PER_REV   13      // 编码器线数
#define REDUCTION_RATIO 20      // 减速比
#define SAMPLING_MS     20      // 采样周期

// 4倍频后每转脉冲数
#define PULSE_TOTAL (PULSE_PER_REV * REDUCTION_RATIO * 4)

// RPM = (pulse_count / PULSE_TOTAL) * (60000 / SAMPLING_MS)
```

## E题适配分析

| 项目 | 评估 |
|---|---|
| 轮胎直径建议 | 65mm |
| 100cm正方形周长 | 4m, 需 20s内完成 → ≥20cm/s |
| 所需转速 | v/wheel_d/(PI) ≈ (0.2/0.065/3.14)*60 ≈ 59 RPM |
| 1:48减速 @6V达标 | 有 (300 RPM 空载) |
| 编码器精度 | 13线×20减速×4倍频=1040脉冲/转, 足够 |

## 推荐购买

| 型号 | 减速比 | 编码器 | 预算 |
|---|---|---|---|
| 通用TT编码电机 | 1:48 | 13线霍尔 | ~20元 |
| DFRobot FIT0458 | 1:120 | 8线正交 | ~55元 |
| 掌卓霍尔TT | 1:48 | 60线霍尔 | ~40元 |
