jlg006728/electronic-design-contest/视频分析/20260725_v104_v105首路口逐帧诊断.md

# V104首路口提前左转：两段录像诊断

## 输入

- `77021048daae29c789a7a89b0ace7675.mp4`：14.233333 s，720×1280，30 fps，426 帧，SHA256=`5B129943D0D852AF91127DAC588C7240CECB8C7A27A9CFE82E9176F857CDFE88`。
- `7dbb4c407b366a4e176f68c35652c6bb.mp4`：12.7 s，720×1280，30 fps，约380 帧，SHA256=`853A41C37725C0D641596D369020941E12BF68553580CB8368CF8E02F96E161D`。
- 原始文件位于微信临时目录，仓库只记录路径与哈希，不复制原始视频。

## 逐帧观察

- 两段录像的直线阶段都能正常沿红线前进，蓝灯多数时候表现为中央约2路，偶尔约3路；没有在可见的30 fps画面中发现稳定持续的4路蓝灯。
- 小车左转的可见动作分别出现在视频1约12.4–12.8 s、视频2约11.6–12.0 s。
- 30 fps相机每帧间隔约33.3 ms，而固件每10 ms检测一次；一次10 ms的4路瞬态可以完全落在相邻视频帧之间。因此“视频中没看到4路”不能证明 MCU 没有判到4路。
- 两段提前转弯区域附近都能看到黑色病房边框。绿光灰度板只测反射强度，黑框与红线都可能形成低反射数字量，不能仅凭8路数字量可靠区分颜色。

## 与 V104 状态机的对应

V104 的首段逻辑是：

```text
平均前进达到25 cm且正常线帧达到5帧 -> 武装首路口
任意一个10 ms帧检测到至少4路 -> 锁存路口并刹车
编码器继续前进17.5 cm -> MPU原地左转
```

因此画面中的左转点不是传感器判定点，而是判定点之后的17.5 cm补偿终点。25 cm武装距离过早，加上4路单帧门控，对黑框和瞬态过于敏感。

## V105修复记录

`20260725_v105_video_gated_first_junction_empty.c` 仅改变首路口保护：

```c
FIRST_JUNCTION_ARM_DISTANCE_CM = 50
JUNCTION_TRIGGER_ACTIVE_MIN = 4
JUNCTION_WIDE_CONFIRM_FRAMES = 3
JUNCTION_CENTER_REQUIRED_MASK = X4 | X5
```

即保留“至少4路”的用户要求，但额外要求首段已经走到约50 cm、中央X4/X5同时有效、连续3个10 ms控制帧确认。17.5 cm几何补偿和其余路线状态机不变。

## 限定

蓝色指示灯是摄像机视觉证据，不是 MCU 内部采样日志；若需要最终确认，应在 MCU Watch 中同时记录 `g_gray_changed_count`、`g_gray_changed_from_white_mask`、`g_route_detector.armed`、`g_route_event` 和左右编码器计数。
