jlg006728/electronic-design-contest/知识库/MCU_MSPM0/EVM用户指南_目录索引.md

# EVM用户指南 (LP-MSPM0G3507 LaunchPad) - 目录索引

总页数: 25 | 文件大小: 2.0 MB

## 快速导航

- [内容](#) — **p2**
- [商标](#) — **p2**
- [1 入门](#) — **p3**
  - [1.1 引言](#) — **p3**
  - [1.2 关键特性](#) — **p3**
  - [1.3 包含的内容](#) — **p3**
    - [1.3.1 套件内容](#) — **p3**
    - [1.3.2 软件示例](#) — **p3**
  - [1.4 第一步：开箱即用体验](#) — **p3**
    - [1.4.1 连接至计算机](#) — **p3**
    - [1.4.2 运行开箱即用体验](#) — **p4**
  - [1.5 后续步骤：查看提供的代码](#) — **p4**
- [2 硬件](#) — **p5**
  - [2.1 跳线映射](#) — **p6**
  - [2.2 方框图](#) — **p7**
  - [2.3 硬件特性](#) — **p7**
    - [2.3.1 MSPM0G3507 MCU](#) — **p7**
    - [2.3.2 采用 EnergyTrace 技术的 XDS110-ET 板载调试探针](#) — **p8**
    - [2.3.3 调试探针连接隔离跳线块](#) — **p9**
    - [2.3.4 应用（或反向通道）UART](#) — **p10**
    - [2.3.5 使用外部调试探针代替板载 XDS110-ET](#) — **p10**
    - [2.3.6 将 XDS110-ET 调试探针用于不同目标](#) — **p11**
    - [2.3.7 特殊特性](#) — **p11**
      - [2.3.7.1 高达 4Msps 的高速模数转换器](#) — **p11**
      - [2.3.7.2 热敏电阻](#) — **p12**
      - [2.3.7.3 光传感器](#) — **p13**
  - [2.4 电源](#) — **p13**
    - [2.4.1 XDS110-ET USB 电源](#) — **p13**
  - [2.5 外部电源和 BoosterPack 插件模块](#) — **p13**
  - [2.6 测量 MSPM0 MCU 的电流消耗](#) — **p14**
  - [2.7 计时](#) — **p14**
  - [2.8 BoosterPack 插接模块引脚布局](#) — **p14**
- [3 软件示例](#) — **p15**
- [4 资源](#) — **p16**
  - [4.1 集成开发环境](#) — **p16**
    - [4.1.1 TI 云开发工具](#) — **p16**
    - [4.1.2 TI 资源浏览器云](#) — **p16**
    - [4.1.3 Code Composer Studio Cloud](#) — **p16**
    - [4.1.4 Code Composer Studio IDE](#) — **p16**
  - [4.2 MSPM0 SDK 和 TI Resource Explorer](#) — **p16**
  - [4.3 MSPM0G3507 MCU](#) — **p17**
    - [4.3.1 器件文档](#) — **p17**
    - [4.3.2 MSPM0G3507 代码示例](#) — **p17**
  - [4.4 社区资源](#) — **p17**
    - [4.4.1 TI E2E™ 论坛](#) — **p17**
- [5 原理图](#) — **p18**
- [6 修订历史记录](#) — **p24**
