jlg006728/electronic-design-contest/知识库/MCU_MSPM0/MSPM0开发指南_目录索引.md

# MSPM0开发指南 - 目录索引

总页数: 72 | 文件大小: 12.2 MB

## 快速导航

- [内容](#) — **p1**
- [商标](#) — **p3**
- [1 概述](#) — **p4**
- [2 MSPM0 在线选择](#) — **p5**
- [3 软件开发说明](#) — **p7**
  - [3.1 主要文档](#) — **p7**
  - [3.2 LaunchPad 设置](#) — **p8**
    - [3.2.1 调试器选择](#) — **p8**
    - [3.2.2 LaunchPad 简介](#) — **p8**
  - [3.3 MSPM0-SDK 设置](#) — **p9**
    - [3.3.1 MSPM0-SDK 安装](#) — **p9**
    - [3.3.2 MSPM0-SDK 简介](#) — **p10**
      - [3.3.2.1 示例文件夹简介](#) — **p11**
      - [3.3.2.2 文档文件夹简介](#) — **p12**
  - [3.4 SysConfig 设置](#) — **p13**
    - [3.4.1 SysConfig 安装](#) — **p13**
    - [3.4.2 SysConfig 介绍](#) — **p13**
      - [3.4.2.1 基本概念](#) — **p14**
      - [3.4.2.2 工程配置视图](#) — **p15**
      - [3.4.2.3 电路板视图](#) — **p16**
      - [3.4.2.4 NONMAIN 视图](#) — **p16**
      - [3.4.2.5 SYSCTL 视图](#) — **p17**
      - [3.4.2.6 外设设置](#) — **p18**
  - [3.5 IDE 快速入门](#) — **p19**
    - [3.5.1 CCS 快速入门](#) — **p19**
      - [3.5.1.1 CCS 安装](#) — **p19**
      - [3.5.1.2 导入 SDK 示例](#) — **p20**
      - [3.5.1.3 示例下载和调试](#) — **p22**
      - [3.5.1.4 在 MSPM0 衍生产品之间进行迁移](#) — **p23**
      - [3.5.1.5 生成十六进制文件](#) — **p24**
      - [3.5.1.6 对 NONMAIN 编程](#) — **p25**
    - [3.5.2 IAR 快速入门](#) — **p25**
      - [3.5.2.1 环境设置](#) — **p25**
        - [3.5.2.1.1 SDK 支持设置](#) — **p25**
        - [3.5.2.1.2 SysConfig 支持设置](#) — **p27**
      - [3.5.2.2 导入 SDK 示例](#) — **p27**
      - [3.5.2.3 示例下载和调试](#) — **p29**
      - [3.5.2.4 在 MSPM0 衍生产品之间进行迁移](#) — **p29**
      - [3.5.2.5 生成十六进制文件](#) — **p31**
      - [3.5.2.6 对 NONMAIN 编程](#) — **p31**
    - [3.5.3 Keil 快速入门](#) — **p32**
      - [3.5.3.1 环境设置](#) — **p32**
        - [3.5.3.1.1 MSPM0 CMSIS-Pack 设置](#) — **p32**
        - [3.5.3.1.2 Sysconfig 支持设置](#) — **p34**
      - [3.5.3.2 导入 SDK 示例](#) — **p35**
      - [3.5.3.3 示例下载和调试](#) — **p37**
      - [3.5.3.4 在 MSPM0 衍生产品之间进行迁移](#) — **p40**
      - [3.5.3.5 生成十六进制文件](#) — **p41**
      - [3.5.3.6 对 NONMAIN 编程](#) — **p42**
- [4 硬件设计说明](#) — **p42**
  - [4.1 获取 MSPM0 包](#) — **p42**
  - [4.2 通过 SysConfig 修复引脚功能](#) — **p45**
  - [4.3 原理图和 PCB 注意事项](#) — **p45**
- [5 大规模生产说明](#) — **p47**
  - [5.1 生成生产映像](#) — **p47**
  - [5.2 编程软件工具快速入门](#) — **p48**
    - [5.2.1 Uniflash 快速入门](#) — **p48**
      - [5.2.1.1 通过 SWD 编程](#) — **p48**
      - [5.2.1.2 通过引导加载程序编程](#) — **p48**
      - [5.2.1.3 通过 CMD 线路接口编程](#) — **p49**
    - [5.2.2 JFlash 快速入门](#) — **p49**
    - [5.2.3 C-GANG 快速入门](#) — **p51**
  - [5.3 编程硬件快速入门](#) — **p55**
- [6 质量和可靠性说明](#) — **p57**
  - [6.1 质量和可靠性材料入口](#) — **p57**
  - [6.2 失效信息收集和分析指南](#) — **p57**
- [7 常见开发问题](#) — **p58**
  - [7.1 解锁 MCU](#) — **p58**
    - [7.1.1 通过引导加载程序解锁](#) — **p59**
    - [7.1.2 通过恢复出厂设置 GUI 工具解锁](#) — **p60**
    - [7.1.3 通过 Uniflash 解锁](#) — **p60**
    - [7.1.4 通过 CCS 解锁](#) — **p61**
    - [7.1.5 在禁用复位引脚的情况下解锁](#) — **p61**
  - [7.2 MSPM0 编程故障](#) — **p61**
  - [7.3 禁用 SWD 或 REST 引脚时的注意事项](#) — **p62**
  - [7.4 MCU 在调试和自由运行时的表现不同](#) — **p63**
  - [7.5 设置 SWD 密码](#) — **p63**
  - [7.6 BSL 相关问题](#) — **p65**
  - [7.7 在 LPM 模式下达到预期电流](#) — **p65**
  - [7.8 CCS 常见问题](#) — **p65**
    - [7.8.1 更改优化级别](#) — **p66**
  - [7.9 Keil 常见问题](#) — **p67**
    - [7.9.1 从 SDK 复制 Keil 示例](#) — **p67**
- [8 总结](#) — **p68**
- [9 技术文档资源](#) — **p68**
  - [9.1 技术参考手册](#) — **p68**
  - [9.2 子系统](#) — **p68**
  - [9.3 参考设计](#) — **p69**
  - [9.4 硬件 EVM 用户指南](#) — **p69**
  - [9.5 应用简报](#) — **p69**
  - [9.6 应用手册和其他资料](#) — **p70**
- [10 修订历史记录](#) — **p71**
