jlg006728/electronic-design-contest/设计报告_AI使用说明_20260707_220812_旧稿备份.md

# 巡迹作业一体平台设计报告：项目 AI 使用说明

## 1. AI 工具使用概况

本项目在方案设计、代码开发、调试记录整理和故障分析过程中使用了 AI 辅助工具。主要使用方式为：队员通过自然语言描述当前硬件状态、测试现象、代码需求和现场问题，AI 工具辅助分析原因、提出排查步骤、生成或修改嵌入式 C 程序，并将每一版关键代码保存为带时间戳的过程文件。

本项目使用 AI 的目的不是替代实物调试，而是提高方案拆解、代码迭代、错误复盘和文档整理效率。所有硬件接线、万用表测量、CCS 烧录、现场运行测试、参数取舍和最终功能确认均由队员完成。

## 2. 使用的 AI 工具与环境

本项目主要使用的 AI 工具为 Codex 类编程智能体。AI 工具运行在本地工程目录中，可以读取项目代码、调试记录和题目资料，并辅助完成以下工作：

- 阅读和整理题目要求。
- 分析 MSPM0G3507、TB6612、电机、红外传感器、OpenMV、二维云台舵机、蜂鸣器等模块的接线和调试流程。
- 生成、修改和编译 CCS 工程中的 `empty.c` 程序。
- 保存带时间戳的历史代码版本，避免覆盖可回退版本。
- 生成测试说明、接线说明、调试复盘和项目过程记录。
- 根据现场反馈，提出下一步排查流程和参数调整建议。

AI 工具没有直接参与比赛运行过程，也没有作为小车运行时的外部导航设备。小车行驶过程中不依赖在线 AI 服务，巡迹控制由 MSPM0 主控和红外传感器独立完成。

## 3. AI 在项目中的具体作用

### 3.1 需求分析与任务拆解

AI 首先辅助队伍将题目要求拆分为多个可独立调试的模块：

- 小车底盘与 TB6612 电机驱动验证。
- 编码器和红外循迹模块验证。
- OpenMV 视觉识别与 MSPM0 串口通信验证。
- PA14/PA17 双舵机云台控制验证。
- B 点停车瞄准、C/D/A 声光提示等任务状态机。
- 蜂鸣器声光提示。
- 比赛场地变化下的循迹策略调整。

这种拆解使调试过程从“整车同时排查”变为“单模块验证后再集成”，降低了定位问题的难度。

### 3.2 代码生成与版本管理

AI 参与生成了多类测试和集成代码，包括：

- 电机 PWM 与方向控制测试程序。
- 编码器计数测试程序。
- 7 路红外传感器静态测试程序。
- 基础循迹、急弯循迹和直角弯优化程序。
- OpenMV 串口通信与双舵机静态追踪程序。
- 循迹与 OpenMV 云台联动程序。
- B 点停车、C/D/A 声光提示的任务状态机程序。
- 蜂鸣器隔离测试程序。

为避免调试过程中覆盖有效代码，AI 按时间戳保存了过程版本，例如：

```text
20260707_190540_v19_restore_dynamic_tracking_with_buzzer.c
20260707_212451_v22_b_stop_cda_prompt_full_line.c
20260707_200036_static_line_sensor_motor_off_test.c
```

队伍可以根据现场测试效果回退到任一历史版本，减少了参数试错带来的风险。

### 3.3 硬件接线与故障排查

AI 辅助队伍完成了多个硬件问题的排查：

- TB6612 与电机供电、STBY、PWM、方向引脚的验证。
- 红外传感器在不同场地光照和纸面上的阈值检查。
- OpenMV P4/P5 UART 接触不良导致舵机不响应的问题定位。
- 舵机供电不足、机械结构卡滞、舵机信号脚选择等问题分析。
- 蜂鸣器不响问题定位，最终确认原因为蜂鸣器正负极接反。
- XDS110 无法识别问题分析，确认电脑未识别调试器而非代码问题。

AI 给出的排查流程通常遵循“先确认供电和接线，再确认输入输出电平，最后分析代码逻辑”的顺序，帮助队伍减少了盲目修改程序的情况。

### 3.4 巡迹算法与任务状态机优化

在巡迹算法方面，AI 辅助队伍从基础比例控制逐步扩展到更复杂的状态控制：

- 使用 7 路红外传感器计算线位置误差。
- 对普通直线和急弯采用不同修正强度。
- 对丢线、急弯、直线等状态进行区分。
- 根据现场反馈调整基础速度、左右轮平衡和急弯修正上限。
- 在题目任务要求调整后，将程序改为 B 点停车，C/D/A 点仅声光提示。

在任务状态机方面，AI 帮助将“巡迹”和“作业”分开处理。小车行驶由红外传感器和电机控制完成，OpenMV 视觉模块主要用于目标靶识别和云台瞄准，符合题目中“小车行驶与目标作业必须独立于视觉模块完成”的要求。

### 3.5 OpenMV 与云台追踪调试

AI 辅助完成了 OpenMV 与 MSPM0 的串口协议调试，以及 PA14/PA17 双舵机云台控制逻辑。主要工作包括：

- 设计 OpenMV 主动发送目标坐标的数据格式。
- 在 MSPM0 端解析目标坐标、目标状态和帧计数。
- 根据目标中心偏差调整水平和俯仰舵机脉宽。
- 增加目标丢失后的保持、搜索或预瞄策略。
- 根据小车绕赛道运动时目标相对方位变化，调整云台预偏转曲线。

AI 同时指出，普通三线舵机不能通过软件“重置角度后继续相对旋转”，如果需要大角度或连续角度控制，应使用具备相应角度范围的舵机、编码器反馈或机械传动结构。

## 4. 人工验证与 AI 输出的使用方式

AI 生成的代码不会直接作为最终结果使用，必须经过以下人工验证：

1. CCS 编译通过。
2. 队员手动烧录到 MSPM0。
3. 架空测试电机、舵机和蜂鸣器是否动作正常。
4. 放置到赛道进行低速测试。
5. 根据现场现象反馈给 AI，再决定是否修改参数或回退版本。

例如，蜂鸣器最初不响时，AI 生成了 PB11 隔离测试程序。队员烧录后发现蜂鸣器仍不响，继续检查硬件后确认正负极接反。该过程说明 AI 只能提供排查路径，最终判断必须依赖实物测量和现场验证。

## 5. AI 使用带来的帮助

AI 对本项目的主要帮助体现在以下方面：

- 快速生成可编译的模块测试程序，缩短单模块验证时间。
- 将复杂问题拆分为电源、接线、输入、输出、代码逻辑等层级。
- 在长时间调试中保存过程记录，避免遗忘已经验证过的结论。
- 在参数多次变化时保留历史版本，便于回退。
- 对现场现象提出可能原因和验证顺序，减少无依据的试错。
- 辅助撰写说明文档和复盘记录，提高工程资料完整度。

## 6. AI 使用的局限性与风险控制

AI 在本项目中也存在明显局限：

- AI 不能直接感知真实电压、电流、接触不良、机械卡滞等物理状态。
- AI 对图片、视频和文字描述的判断可能不完整，必须结合万用表和现场实测。
- AI 生成的代码可能逻辑正确但不适合现场赛道，需要实车验证。
- AI 对硬件能力的判断可能出错，例如舵机角度范围、XDS110 损坏原因等都需要人工复核。
- AI 不能替代安全判断。涉及电源、舵机堵转、外部 5V 供电和 USB 调试器时，必须由队员确认接线安全。

为降低这些风险，本项目采取了以下措施：

- 每次代码修改均保存时间戳版本。
- 重要错误判断写入调试复盘文件。
- 烧录默认由队员手动完成，避免误烧危险程序。
- 电机测试程序中优先设置安全输出。
- 对高功率模块采用独立供电和共地原则。
- 对不确定现象先写隔离测试程序，再恢复集成程序。

## 7. 结论

本项目中，AI 工具主要作为工程辅助工具，用于需求拆解、代码生成、调试建议、版本整理和文档撰写。小车的实际控制算法运行在 MSPM0 主控上，巡迹过程不依赖在线 AI，也不依赖视觉模块导航。AI 的使用提升了调试效率和记录完整性，但所有最终设计结论均经过队员实物测试、测量和人工确认。

通过 AI 辅助与人工验证结合，队伍能够更快地完成底盘、巡迹、云台、OpenMV、蜂鸣器和任务状态机的分模块调试，并在现场问题出现时保留清晰的排查路径和可回退代码版本。
