jlg006728/electronic-design-contest/25年电赛E题/25年电赛E题简易自行瞄准装置_files/topic_202507308972.png

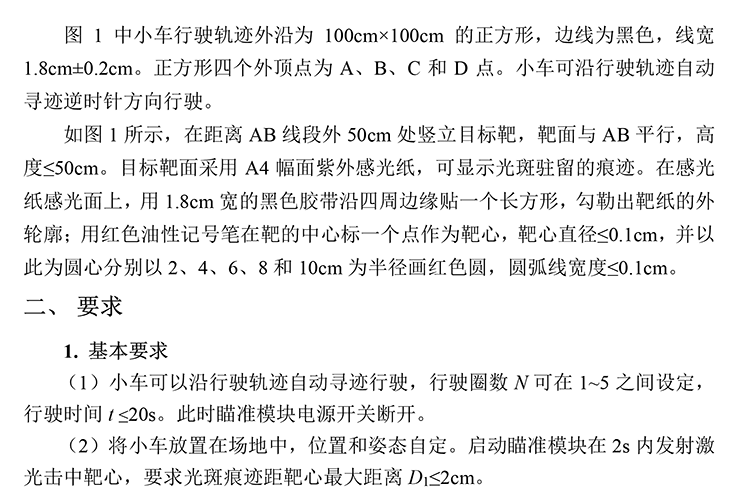
25年电赛E题/25年电赛E题简易自行瞄准装置_files/topic_202507308972.png
