jlg006728/electronic-design-contest/video_analysis/20260707_openmv_tracking_39e13c01/contact_sheet_1fps.jpg

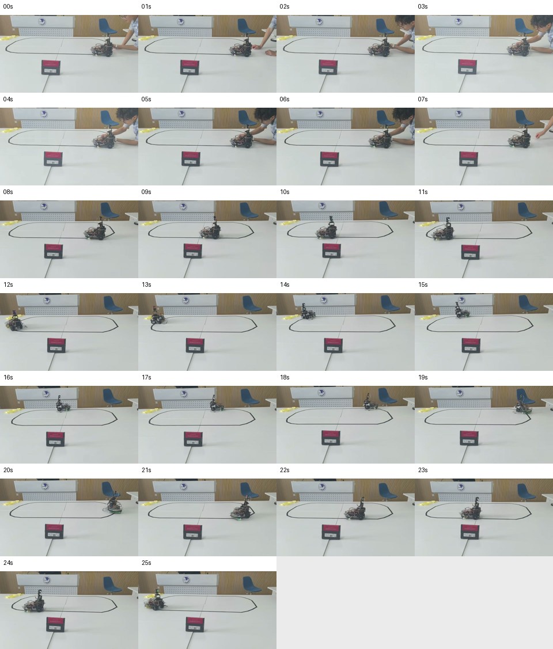
video_analysis/20260707_openmv_tracking_39e13c01/contact_sheet_1fps.jpg
