jlg006728/electronic-design-contest/video_analysis/20260707_openmv_tracking_39e13c01/frame_023.jpg

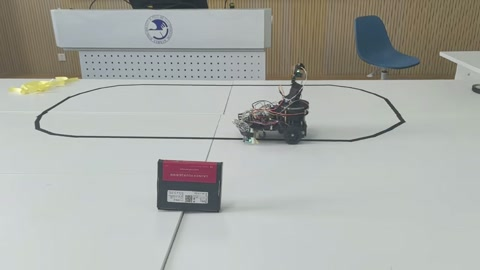
video_analysis/20260707_openmv_tracking_39e13c01/frame_023.jpg
