jlg006728/electronic-design-contest/video_analysis/757377267a4edf9d61f6155f8d630793/frame_018.jpg

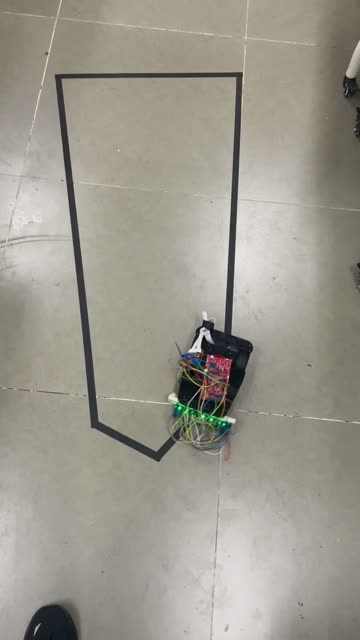
video_analysis/757377267a4edf9d61f6155f8d630793/frame_018.jpg
