jlg006728/electronic-design-contest/video_analysis/fb1ee43ddaa3a75f061e0c188d4a8bb1/fps2/contact_fps2.jpg

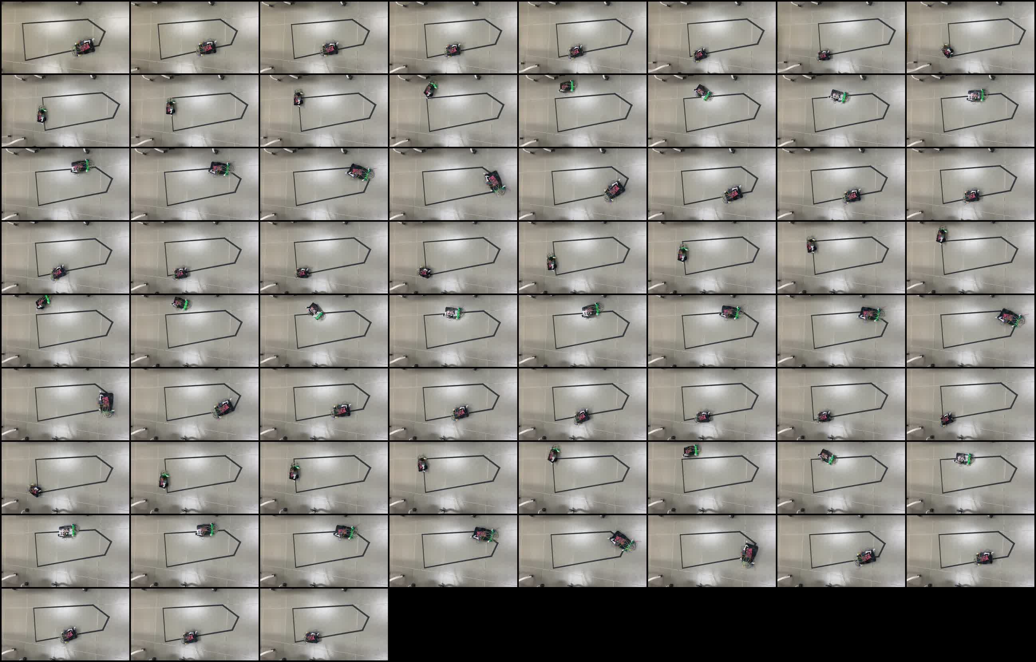
video_analysis/fb1ee43ddaa3a75f061e0c188d4a8bb1/fps2/contact_fps2.jpg
