jlg006728/electronic-design-contest/视频分析/20260721_v87双起点/v1_20_27.jpg

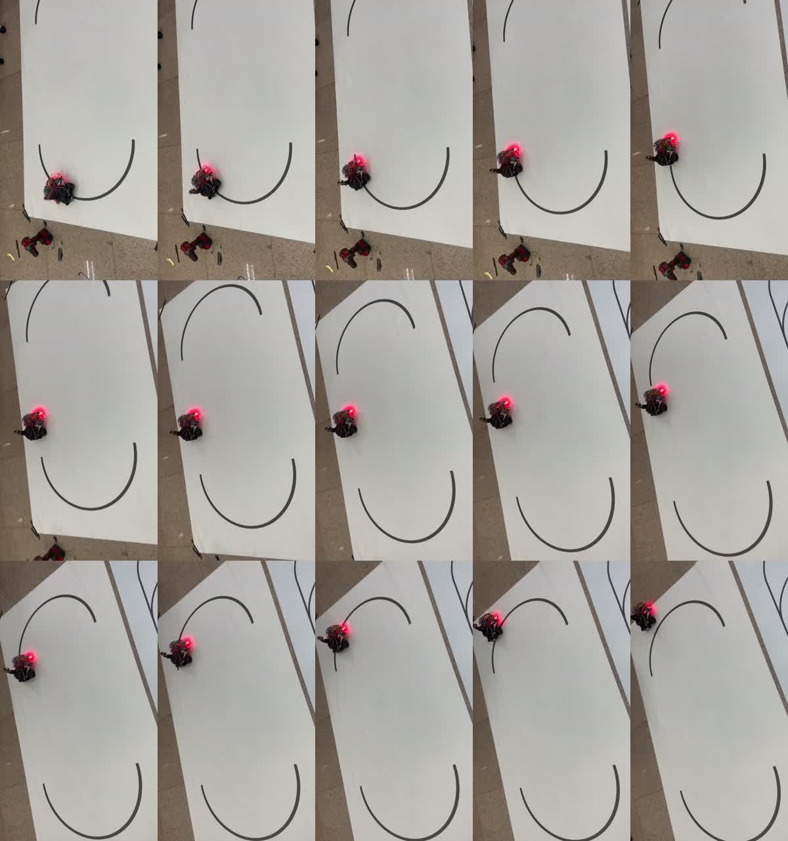
视频分析/20260721_v87双起点/v1_20_27.jpg
