jlg006728/electronic-design-contest/器件采购清单.md

# E题器件采购清单 (BOM)

> 基于 2025 年电赛 E 题"简易自行瞄准装置"需求编制
> 价格为 2026 年淘宝/立创商城参考价，实际以购买为准

---

## 一、主控与开发

| 序号 | 物品 | 型号/规格 | 数量 | 单价(元) | 小计(元) | 备注 |
|---|---|---|---|---|---|---|
| 1 | 开发板 | LP-MSPM0G3507 LaunchPad | 1 | ~150 | 150 | 板载 XDS110-ET 调试器，无需另购 |
| 2 | 杜邦线 | 公母/母母/公公 各20根 | 3盒 | ~5 | 15 | 面包板跳线 |
| 3 | USB线 | Micro-USB 数据线 | 1 | ~5 | 5 | 开发板供电+下载 |
| 4 | 按键 | 6×6×9.5mm 四脚轻触开关 铜脚直插 | 4 | ~0.5 | 2 | MODE+START (2用2备)；250gf/10万次；推荐领祥；淘宝搜"领祥 6x6x9.5 轻触开关 铜脚" |
| 5 | LED | 5mm 翠绿 + 330Ω 电阻 | 3 | ~1 | 3 | 状态指示，独立于电源LED |
| 6 | 排针 | 2.54mm 单排直针 40P | 1 | ~3 | 3 | ⚠️ 搁置 — LP-MSPM0G3507 已自带排针，各模块通常也带针；待底盘方案敲定后决定是否需要 |

**小计: ~178 元**

> **关于按键**: LP-MSPM0G3507 LaunchPad 自带 2 个用户按键 — S3 (PB21, 通用) 和 S1 (PA18, BSL引导)。S1 在复位期间若被拉低会导致 MCU 进入 Bootloader，且板载贴片按键装车后极难操作，因此需额外购买独立按键（含备用）。

---

## 二、巡迹传感器

| 序号 | 物品 | 型号/规格 | 数量 | 单价(元) | 小计(元) | 备注 |
|---|---|---|---|---|---|---|
| 7 | 巡迹模块 | TCRT5000 红外反射传感器（分立） | 8 | ~3 | 24 | 7路 + 1路备用；务必买分立元件，不要买五路/八路成品模块（见下方选购说明）；淘宝搜"TCRT5000 模块" |
| 8 | IMU (建议购买) | MPU6050 六轴陀螺仪模块 GY-521 | 1 | ~7 | 7 | 丢线时陀螺仪维持航向，画圆阶段比编码器推航向更抗打滑；淘宝搜"MPU6050 GY-521"紫色小板，I2C直连 MSPM0 |

| 7b | 洞洞板 | 5×7cm 单面覆铜 | 1 | ~3 | 3 | 自制七路传感器阵列底板（见下方选购说明） |

**小计: ~35 元**

> **TCRT5000 选购说明 — 为什么不用五路/八路成品模块？**
> 
> 淘宝常见的五路/八路巡线模块（红色长条 PCB）输出的是**数字信号（0/1）**，只能告诉你"第 N 路压线"，无法区分"线在传感器正下方"还是"线在两个传感器中间偏左一点"。
> 
> 而买分立的 TCRT5000 模块（每颗独立小板），输出的是**模拟电压**，MCU 通过 ADC 读取后可以用**加权平均算法**计算出黑线的**亚毫米级精确位置**。这个精度直接决定小车巡线是顺滑过弯还是走锯齿。这也是电赛老选手的通用做法。
> 
> **建议**：买 8 颗 TCRT5000 独立模块，用一块洞洞板焊成自制的七路阵列（1 颗备用），传感器间距 1.0~1.5 cm，引出单排排针，兼顾整洁和性能。
> 
> **淘宝搜索**：`TCRT5000 红外反射模块`（挑独立小板、带模拟输出的那种，约 3 元/个）

---

## 三、小车底盘与动力

| 序号 | 物品 | 型号/规格 | 数量 | 单价(元) | 小计(元) | 备注 |
|---|---|---|---|---|---|---|
| 9 | 小车底盘套件 | WHEELTEC R3X系列三轮小车 | 1 | ~144 | 144 | 淘宝搜"WHEELTEC R3X 三轮小车"；选"R3X三轮"+500线GMR编码器+1:30减速比+1个TB6612带稳压驱动+不加高；含底盘板+2×超TT电机+2×橡胶轮+1×万向轮+安装件 |

**小计: ~144 元**

> **WHEELTEC R3X 选购说明**
> 
> R3X 系列相比 TT 马达版，电机更强、底盘更紧凑（宽度<15cm）、编码器精度高 20+ 倍。
> 淘宝商品页提供以下选项，配置时请注意：
> - 车型选 **"R3X系列三轮小车"**（两轮差速驱动 + 万向轮，巡线标准配置）
> - 编码器选 **"500线GMR编码器"**（精度 500 线/圈，远超 13 线霍尔）
> - 驱动模块选 **"1个 TB6612 带稳压驱动"**（三轮=2个电机，1个 TB6612 正好驱动 2 路）
> - 加高选 **"不加高"**（云台装顶层，重心低过弯更稳）
> - 不选配云台/相机支架，舵机和云台支架已单独购买（可控）
> 
> **影响**: 
> - 编码器 500 线 GMR × 1:30 减速比 → `ENCODER_CPR` = 500 × 30 = **15000**
> - 电机更强、编码器精度更高，速度环 PID 参数需重新整定

---

## 四、舵机与云台

| 序号 | 物品 | 型号/规格 | 数量 | 单价(元) | 小计(元) | 备注 |
|---|---|---|---|---|---|---|
| 14 | 舵机 | MG90S 黑色铝齿 模拟舵机 180° | 2 | ~15 | 30 | 云台二轴，2.2kg·cm；选黑色铝齿款 ≠ 数码舵机(¥34) ≠ 铜齿款(扭力仅1.5kg·cm) |
| 15 | 云台支架 | 二维舵机云台支架套件 | 1 | ~15 | 15 | 含法兰盘、螺丝，兼容 MG90S |
| 16 | 激光固定件 | 12mm激光模组固定支架 360°可调 | 1 | ~5 | 5 | 夹持12mm激光头，固定到云台；也可先用热熔胶+扎带替代 |

**小计: ~50 元**

---

## 五、视觉模块

| 序号 | 物品 | 型号/规格 | 数量 | 单价(元) | 小计(元) | 备注 |
|---|---|---|---|---|---|---|
| 17 | 视觉模块 | OpenMV Cam H7 | 1 | ~380 | 380 | STM32H743VI, OV5640；星瞳科技官方店 |
| 18 | FPC排线 | FFC/FPC 15P 0.5mm 15cm | — | — | 0 | ⚠️ **选配**：H7标准版摄像头集成在主板上，不需要排线；仅 H7 Plus 分离式摄像头需要 |
| 19 | MicroSD卡 | 32GB Class10 | 1 | ~25 | 25 | 调试时存照片/回看识别效果；比赛现场不用 |

**小计: ~405 元**

---

## 六、激光与靶面

| 序号 | 物品 | 型号/规格 | 数量 | 单价(元) | 小计(元) | 备注 |
|---|---|---|---|---|---|---|
| 20 | 激光头 | 405nm 可调焦 ≤10mW | 2 | ~15 | 30 | 1备用 |
| 21 | UV感光纸 | A4 紫外感光纸 | 20张 | ~3 | 60 | 靶面用，可擦写 |
| 22 | 红色记号笔 | 0.05mm 油性细笔 | 3 | ~5 | 15 | 画靶心 + 同心圆 |
| 23 | 圆规 | 金属圆规 + 铅芯 | 1 | ~10 | 10 | 精确画圆 |

**小计: ~115 元**

---

## 七、电源系统

> **双电源隔离设计**：控制回路（7.4V→MCU+电机）与瞄准回路（5V→OpenMV+舵机+激光）独立供电，电机噪声不干扰视觉和舵机。

| 序号 | 物品 | 型号/规格 | 数量 | 单价(元) | 小计(元) | 备注 |
|---|---|---|---|---|---|---|
| 24 | 18650锂电池 ×2 | 松下 3400mAh 或 三星 2600mAh | 2节 | ~18 | 35 | 控制回路 7.4V，替换 LiPo（北京航空件受限） |
| 24b | 2S 18650串联电池盒 | 带 DC5.5 公头，输出 7.4V | 1 | ~6 | 6 | 免焊接装电池 |
| 24c | 18650双槽充电器 | USB供电 | 1 | ~15 | 15 | 普通 USB 充电器，非 B3 平衡充 |
| 25 | 5V充电宝 | 小米/罗马仕 5000mAh 迷你款 | 1 | ~30 | 30 | 瞄准回路: OpenMV+舵机+激光；任何 5V USB 输出充电宝均可 |
| 26 | 稳压模块 | AMS1117-3.3V 模块 | 2 | ~3 | 6 | 7.4V→3.3V，给 MSPM0 主控供电 |
| 27 | 降压模块 | MP1584 DC-DC 可调 | 1 | ~8 | 8 | 7.4V→5V（舵机备选方案，不用充电宝单独供时使用） |
| 28 | 拨动开关 | SS-12F23 2档6脚 | 2 | ~2 | 4 | 控制回路 + 瞄准回路各一个独立开关 |
| 29 | LED | 5mm 红色 + 蓝色 + 1kΩ 限流电阻 | 各2 | ~1 | 2 | 红=控制回路通电，蓝=瞄准回路通电 |
| 30 | 电解电容 | 1000μF/16V | 3 | ~2 | 6 | 并在电机端/TB6612 电源端，吸收启停电流尖峰 |
| 31 | 电容 | 100μF/16V + 0.1μF(104) 陶瓷 | 各5 | ~1 | 5 | AMS1117 输入/输出端滤波：100μF 滤低频，0.1μF 滤高频 |

**小计: ~117 元**

---

## 八、结构件与紧固件

| 序号 | 物品 | 型号/规格 | 数量 | 单价(元) | 小计(元) | 备注 |
|---|---|---|---|---|---|---|
| 33 | 铜柱 | M3×10 + M3×20 六角 | 各10 | ~0.5 | 10 | PCB/传感器固定 |
| 34 | 螺丝螺母 | M3×6/×10 + M3螺母 | 若干 | — | 10 | 整套 |
| 35 | 扎带 | 3×100mm 尼龙扎带 | 1包 | ~5 | 5 | 理线固定 |
| 36 | 热缩管 | φ2+φ3+φ5 各1m | 各1 | ~3 | 9 | 焊接绝缘 |

**小计: ~34 元**

> **底盘**: 已含在第三节 WHEELTEC 套件中，不再单独购买。

---

## 九、工具与耗材 (建议已有)

| 序号 | 物品 | 型号/规格 | 数量 | 单价(元) | 小计(元) | 备注 |
|---|---|---|---|---|---|---|
| 37 | 烙铁 | 936/TS100 恒温焊台 | 1 | — | — | 如已有一 |
| 38 | 焊锡丝 | 0.6mm 含松香 | 1卷 | ~15 | 15 | |
| 39 | 万用表 | 数字万用表 | 1 | — | — | 如已有 |
| 40 | 热熔胶枪 | 20W + 胶棒 | 1 | ~15 | 15 | 固定传感器/激光 |
| 41 | 剥线钳 | | 1 | ~15 | 15 | |
| 42 | 电布胶带 | 3M 绝缘黑胶带 | 1 | ~5 | 5 | |
| 43 | 面包板 | 830孔 + 配套跳线 | 1 | ~12 | 12 | 电路原型验证 |
| 44 | 锂电池电压检测器 | BB响 1-8S | 1 | ~8 | 8 | 电池电压告警 |

**小计: ~70 元**

---

## 预算汇总

| 类别 | 小计(元) | 占比 |
|---|---|---|
| 一、主控与开发 | 178 | 15.4% |
| 二、巡迹传感器 | 35 | 3.0% |
| 三、小车底盘与动力 | 144 | 12.5% |
| 四、舵机与云台 | 50 | 4.3% |
| 五、视觉模块 | 405 | 35.1% |
| 六、激光与靶面 | 115 | 10.0% |
| 七、电源系统 | 117 | 10.2% |
| 八、结构件与紧固件 | 34 | 2.9% |
| 九、工具与耗材 | 70 | 6.1% |
| **合计** | **1,148** | 100% |

> **最大开销**: OpenMV H7 视觉模块 (~380元)，占总预算 33%
> **如已备工具**: 减约 70 元 → **¥1,078**

---

## 购买优先级

| 优先级 | 类别 | 理由 |
|---|---|---|
| P0 必需 | 开发板、WHEELTEC R3X小车套件、舵机、电源 | 没有就无法跑起来 |
| P1 核心 | OpenMV、TCRT5000、激光 | 赛题核心功能 |
| P2 辅助 | MPU6050、感光纸、画靶工具、洞洞板 | 提升性能/调试效率 |
| P3 备用 | 额外的激光头/传感器/线材 | 应急替换 |

---

## 推荐购买渠道

| 渠道 | 适合购买 | 特点 |
|---|---|---|
| 淘宝 | 大部分器件 | 选择多、价格低。搜"WHEELTEC R3X 三轮小车"、"TCRT5000 模块"(独立小板)、"MG90S 黑色铝齿 180°" |
| 优信电子 | 通用电子元件 | youxin-electronic.taobao.com — 按键/LED/电阻/洞洞板/拨动开关/扎带等一次配齐 |
| 立创商城 | 电阻电容、稳压模块 | szlcsc.com — 正品保证、BOM配单 |
| TI 官网 | LP-MSPM0G3507 | 可申请免费样片 |
| OpenMV 官方 | OpenMV H7 | 星瞳科技 官方淘宝店，正品保修 |

---

> **编制日期**: 2026年5月
> **知识库参考**: `知识库/README.md`
