jlg006728/electronic-design-contest/ccs_project/openmv_test/PROJECT_README.md

# OpenMV 与 MSPM0 联调

本目录保存 OpenMV 视觉、UART、舵机和黑框识别实验。它是跨赛题的硬件/视觉验证项目，不能作为 2021 F题小车路线固件的替代品。
