jlg006728/electronic-design-contest/ccs_project/openmv_test/20260703_214308_home_1500_580_track_test_readme.md

# 20260703_214308 OpenMV 云台 HOME 固化与追踪方向测试

## 文件

- 当前烧录文件：`C:\Users\1\Desktop\ELECTRIC\ele-car\empty.c`
- MSPM0 时间戳源码：`C:\Users\1\Desktop\电赛\ccs_project\openmv_test\20260703_214308_mspm0_openmv_servo_home_1500_580_track_test.c`
- OpenMV 脚本：`C:\Users\1\Desktop\电赛\ccs_project\openmv_test\20260703_213123_openmv_full_selftest_rot180.py`

## 固化的 HOME

- 水平舵机 X：`1500us`
- 俯仰舵机 Y：`580us`

## 当前 MSPM0 参数

- `SERVO_X_HOME_US = 1500`
- `SERVO_Y_HOME_US = 580`
- `SERVO_X_MIN_US = 900`
- `SERVO_X_MAX_US = 2100`
- `SERVO_Y_MIN_US = 500`
- `SERVO_Y_MAX_US = 2100`
- `SERVO_Y_CALIB_MIN_US = 0`

`SERVO_Y_MIN_US` 设为 `500`，是为了让追踪时能在 `580` 附近继续向下微调，不会刚进入闭环就被限位拉走。

## 下一步测试

1. OpenMV IDE 运行 `20260703_213123_openmv_full_selftest_rot180.py`，确认图像是正的。
2. CCS 烧录当前 `empty.c`。
3. Resume 运行。
4. 如果 Watch 里 `g_servo_calibrate_enable` 还是 `1`，手动改成 `0`。
5. 拿红色目标在画面中移动，观察云台是否追随。

## 观察重点

- 红色目标在画面右侧：水平舵机应向右追。
- 红色目标在画面左侧：水平舵机应向左追。
- 红色目标在画面上方：俯仰舵机应向上追。
- 红色目标在画面下方：俯仰舵机应向下追。

如果某一轴方向反，只改 MSPM0：

- 左右反：改 `AIM_X_PULSE_SIGN`
- 上下反：改 `AIM_Y_PULSE_SIGN`

如果图像本身还倒，不要先改舵机方向，先改 OpenMV 的 `CAMERA_HMIRROR/CAMERA_VFLIP`。
