jlg006728/electronic-design-contest/ccs_project/openmv_test/20260704_153116_fast_track_home_1500_1500_readme.md

# 20260704_153116 OpenMV 快速追踪版 HOME=1500/1500

## 文件

- 当前 MSPM0 烧录文件：`C:\Users\1\Desktop\ELECTRIC\ele-car\empty.c`
- MSPM0 时间戳源码：`C:\Users\1\Desktop\电赛\ccs_project\openmv_test\20260704_153116_mspm0_openmv_fast_track_home_1500_1500.c`
- OpenMV 脚本：`C:\Users\1\Desktop\电赛\ccs_project\openmv_test\20260704_135927_openmv_uart_stream_fast_rot180.py`

## 当前状态

用户重新确认默认初始位置可用，因此从纯校准版切回 OpenMV 快速稳定追踪版。

固化 HOME：

- `SERVO_X_HOME_US = 1500`
- `SERVO_Y_HOME_US = 1500`

追踪模式：

- `SERVO_CALIBRATION_MODE = 0`
- `g_servo_calibrate_enable = 0`
- `OPENMV_ENABLE_REQUESTS = 0`
- MSPM0 只接收 OpenMV 主动串流，不再主动发 `'C'` 请求。

## 使用步骤

1. 确认 OpenMV 内部保存的是：
   `20260704_135927_openmv_uart_stream_fast_rot180.py`
2. CCS 烧录当前 `empty.c`。
3. Resume 运行。
4. 观察红色目标追踪。

## Watch 重点

- `g_omv_rx_bytes`
- `g_omv_color_frame_count`
- `g_omv_target_detected`
- `g_omv_cx`
- `g_omv_cy`
- `g_omv_pixels`
- `g_aim_state`
- `g_aim_dx`
- `g_aim_dy`
- `g_aim_x_step_us`
- `g_aim_y_step_us`
- `g_servo_x_us`
- `g_servo_y_us`

## 判断

- `g_aim_state = 2`：正在追踪。
- `g_aim_state = 3`：目标在中心死区，舵机不应继续动。
- `g_aim_state = 6`：目标太小，被拒收。
- `g_aim_state = 7`：目标刚出现，等待连续帧确认。

如果目标在右边却越追越偏，改 `AIM_X_PULSE_SIGN`。如果上下越追越偏，改 `AIM_Y_PULSE_SIGN`。
