jlg006728/electronic-design-contest/ccs_project/integration_test/PROJECT_README.md

# 2025 E题：循迹与弯道控制历史实验

这里保存会话 `019e7371-af12-7d03-a88c-240a230f2d96` 相关的 V62–V91 单文件实验、控制变量阶段和测试程序。

该目录不是 2021 F题路线状态机；其中的 `empty.c`、`simple_line_control.h` 和弯道参数不能直接替换 `ccs_project/medicine_car_2021f/` 的同名文件。
