jlg006728/electronic-design-contest/知识库/调试复盘_判断失误记录.md

# 调试复盘：判断失误记录

## 2026-07-06 OpenMV 无目标回中已删，但断链回中遗漏

- 现象：用户视频中可见车辆过弯后 OpenMV 丧失目标，云台仍可能出现不必要的大动作。
- 失误点：此前按要求删除了“没识别到目标后自动慢慢回 HOME”的逻辑，但只覆盖了 `target_detected=0` 分支；`g_omv_link_ok=0` 的串口断链分支仍保留 `recenter_servo_slowly()`。
- 为什么错：把“无目标”和“串口断链”笼统当成同一类视觉异常，没有逐分支检查运行中会改变舵机位置的代码。
- 修正：V9 中断链时只保持最后舵机位置并清零步进，不再回 HOME；真正丢目标后进入短暂保持/急弯保持/水平搜索找回状态机。
- 后续原则：凡是用户要求删除某个行为，必须搜索所有能触发该行为的分支，而不是只改最显眼的一个分支。

本文件专门记录本项目调试过程中出现的错误判断、走弯路原因、修正后的结论和后续规则。后续每次出现新的误判，都追加到这里，避免上下文过长后重复犯错。

## 2026-07-02：旧文档残留继续保留 PA3/PA4 和 PA20，存在误导接线风险

现象：
- `PA2~PA6` 官方原理图核查完成后，`接线步骤.md` 和 `硬件接口图.md` 底部已经追加了“PA3/PA4 舵机方案作废”。
- 但正文中部仍残留 `PA3/PA4 -> MG90S`、`PA20 -> 激光`、最终引脚表中 `PA3/PA4` 舵机和 `PA20` 激光等旧配置。

误判点：
- 只在文档末尾追加修正说明不够；接手同学很可能直接看正文表格接线，而不会读到末尾修正。
- `PA20` 作为激光脚的旧方案也存在调试脚冲突，不能继续留在“最终无冲突表”里。

修正：
- 已创建 `硬件风险审计_20260702.md`，把 PA2~PA6、PA20、PA0/PA1、PA10/PA11、供电带载等问题集中成风险清单。
- 已更新 `项目记忆.md`、`接线步骤.md`、`硬件接口图.md`，把 `PA3/PA4` 舵机和 `PA20` 激光从正式推荐方案中移除。

后续规则：
- 对危险接线方案，不能只加补丁说明，必须修改正文表格和最终引脚表。
- 接手文档中遇到“旧方案作废”时，要回头搜索全文同名引脚，清除或标记所有残留。

## 2026-06-29：舵机 PA3/PA4 排查中过早发散到“烧错板/程序没跑”

现象：
- 舵机测试时 Watch 中的 `g_step/g_servo_x_us/g_servo_y_us/g_frame_count` 都在持续变化。
- 用户断开舵机信号后测 PA3 对 MSPM0 GND 约为 0V。

我的误判/不严谨点：
- 在 Watch 变量已经证明主循环运行的前提下，仍把“程序没跑、烧错板、接错运行目标”等作为靠后的猜测列出，信息价值不高，容易干扰现场排查。

修正：
- 先做最小化 GPIO 电平诊断：不接舵机、不发 PWM，只让 PA3/PA4 分别保持 3 秒高电平和 1 秒低电平，用万用表直接验证物理排针能否输出 3.3V。
- 若慢速 GPIO 都不能输出 3.3V，再查引脚映射、排针位置、焊接/连接链路；若慢速 GPIO 正常，再回到舵机信号线、电源共地和 PWM 波形问题。

补充修正：
- 用户实测 PA3/PA4 均无电压后，重新核对 LP-MSPM0G3507 用户指南的 40-pin BoosterPack 排针图，发现 PA3/PA4 并不在常用 BoosterPack 排针信号列表中。
- 前面直接建议“舵机信号接 PA3/PA4”是不严谨的：代码层面的 IOMUX 没错，但现场杜邦线能接到的排针不一定暴露该芯片引脚。
- 后续规则：给外设接线时，不能只看 MCU `GPIOA_DIOxx` 和 IOMUX，还必须核对 LaunchPad 排针图/原理图，确认该信号确实出现在可插杜邦线的排针上。

## 2026-06-30：舵机验证一开始同时驱动两个舵机且扫到极限

现象：
- 舵机接到 PA12/PA13 后，用户贴近能听到微弱“咔擦”声，说明并非完全无信号，但舵机没有转起来。

我的误判/不严谨点：
- 在尚未证明供电电流、共地、舵机本体和云台机械负载都正常前，直接让两个舵机同时扫 1000/2000 us，测试条件偏激进。
- 对 MG90S 这类小舵机，极限脉宽可能顶到机械限位；两个舵机同时启动也可能让低质量降压模块瞬间压降，表现为只咔擦不转。

修正：
- 先用单舵机、单信号脚、小幅脉宽验证：PA12 单独输出 1400/1500/1600 us，另一个舵机完全拔掉。
- 调舵机时优先确认红黑供电电压在动作瞬间不明显掉压，且舵机黑线与 MSPM0 GND 共地。
- 后续所有舵机测试先“单舵机小幅中心附近动作”，通过后再扩大角度、再双舵机联动。

补充结论：
- 用户实测单舵机温和测试时，舵机红黑供电仍降到约 3.5~4.3V，低于常见小舵机稳定工作的 4.8V 下限。
- 后续不应继续优先改 PWM 参数或更换 GPIO；必须先解决 5V 舵机电源的带载能力和连接可靠性。
- 空载 OUT+/OUT- 为 5.6V 不代表模块能带舵机。用户进一步实测：MP1584 输入仍有约 7.7V，但接上舵机红黑电源线后输出塌到约 3.7~4.3V。因此后续判断电源是否可用必须测“带载输出”，不能只看空载电压。
- 若电池端或供电总线带载时也从数伏继续下降到 1V 以下，不能再继续反复上电试舵机；应先按“无负载、只接降压、接单舵机红黑”的顺序隔离，避免短路/保护板反复动作。
- 用户发现 MSPM0 芯片发烫后，必须把安全排查优先级提到最高。舵机堵转本身不应显著加热 MCU；如果 MCU 烫，后续不能继续假设只是“舵机电流不够”，应优先查是否有 5V/5.6V 反灌到 3.3V 域或 GPIO、舵机电源地未正确回到 MP1584 OUT- 而经 MCU 保护二极管回流、或 PA12/PA13 仍同时连着 TB6612/PWM 支路造成冲突。
- 电池充好后，MP1584 接舵机仍从空载约 5.8V 掉到 3.7~4.4V，说明后续不能再把主要嫌疑放在电池电量；应集中检查降压模块带载、输出焊接/接触、舵机红黑线和舵机本体。

## 2026-07-02：把带稳压电机驱动扩展板过度泛化为普通 TB6612 模块

现象：
- 用户提供资料图显示当前电机驱动板带稳压电路，输入 4.5V~15V，并对外提供 5V 5A、3.3V 0.5A 供电接口。

我的不严谨点：
- 之前把它按“普通 TB6612 驱动模块”保守处理，强调不要从 TB6612 给 MSPM0 供电。这个安全建议方向没错，但没有充分区分“裸 TB6612 模块”和“带板载稳压输出的电机驱动扩展板”。

修正：
- 对这块具体板子，5V/3.3V 引脚可视为板载电源输出候选，但必须先测量验证。
- 给 MSPM0 供电只能用稳定 5V 接 LaunchPad 的 5V 输入/5V 电源脚并共地，不能接 3V3 或 GPIO。
- 后续判断模块功能时，必须看用户手头具体板子的丝印和资料，不能只按芯片名推断整板功能。

## 2026-07-02：恢复循迹代码时拿成了最终稳定版

现象：
- 用户要求“之前的循迹代码”用于重新测试，我恢复了 `line_follow_sharp_turn_stable_baseline.c`，即最终可过直角弯的 21:43 急弯策略版。
- 用户进一步说明想要的是“解决直角弯之前”的版本，且记得那版跑得更快。

我的误判：
- 没有先确认“之前”指的是最终稳定基线，还是加急弯策略之前的普通循迹版本。

修正：
- 已从稳定版反向去掉 `LINE_SHARP_*` 急弯分支和丢线找回分支，恢复为普通 P 循迹：`left = base - correction`、`right = base + correction`。
- 新文件保存为 `C:\Users\1\Desktop\电赛\ccs_project\line_sensor_test\line_follow_pre_sharp_turn_reconstructed.c`。

再次修正：
- 用户随后贴出 21:43 记录，明确要的是“加入急弯策略的 21:43 版”，不是急弯前普通循迹版。
- 已恢复 `line_follow_sharp_turn_stable_baseline.c` 到当前工程 `empty.c`。以后提到这版时必须完整称呼为“21:43 急弯策略版”，关键参数为 `LINE_SHARP_ERROR=1800`、`LINE_SHARP_KP_DIVISOR=8`、`LINE_SHARP_CORR_LIMIT=380`。
- 后续不能只按“直角弯之前/之后”模糊判断版本，必须以参数和控制分支为准。

## 2026-05-31：电机、编码器、闭环调试

### 1. 误把 `PA15` 无电压过早归因到 SysConfig/程序未跑

**当时现象**

- 用户测 `PA15` 没有电压。
- 后续确认 LED 能闪，程序实际可以运行。

**我的误判**

- 过早判断可能是 SysConfig 没配置 `PA15/PB0-PB4` 或程序没有跑。

**正确结论**

- `PA15` 测量点/测量时机也可能出错，不能只凭一个点的万用表读数判断程序未运行。
- 必须同时测多个输出脚，或用固定高电平诊断程序区分“程序未跑”和“单点测量/接线问题”。

**后续规则**

- 程序运行性判断优先用：LED 规律闪烁 + 多个 GPIO 固定高电平共同验证。
- 单个引脚测不到电压时，不直接下结论。

### 2. 没有及时指出 `AIN1=AIN2=HIGH` 是 TB6612 刹车状态

**当时现象**

- 诊断程序把 `PB0-PB4` 全部拉到 3.3V。
- 用户确认全部为 3.3V，但电机仍不转。

**我的误判/遗漏**

- 一开始没有足够强调：这个诊断程序只用于验证线通，不应该期待电机转。

**正确结论**

- TB6612 中：
  - `AIN1=HIGH, AIN2=LOW` 才是一个方向转。
  - `AIN1=LOW, AIN2=HIGH` 是反方向转。
  - `AIN1=AIN2=HIGH` 是短刹/刹车，不是转动。

**后续规则**

- 所有“固定高电平诊断”都必须明确说明：这是测线程序，不是电机转动程序。
- 让电机转必须保证每个通道方向脚一高一低，不能两脚同高。

### 3. 过早怀疑 TB6612/硬件功率侧，而没有先固定单一状态测量

**当时现象**

- 电机完整流程测试不转。
- 7.4V 电源恢复后仍不转。

**我的误判/走弯路**

- 一度把问题扩大到 TB6612 输出、6P 插头、电机本体等多个方向。
- 动态测试每个阶段只有几秒，不适合用万用表稳定定位。

**正确结论**

- 固定左电机正转状态后，电机开始转，说明功率侧和左通道硬件是好的。
- 对硬件问题，静态保持某一状态比动态流程更适合测量。

**后续规则**

- 电机不转时，优先烧录固定状态程序：
  - `STBY=HIGH`
  - 单通道方向 `IN1=HIGH, IN2=LOW`
  - `PWM=HIGH` 或固定 PWM
- 先让一个电机稳定保持转动，再恢复复杂流程。

### 4. 对 MSPM0 TIMG0 PWM compare 与实际有效占空比的关系判断反了

**当时现象**

- 基础闭环中：
  - `left_delta_edges=4100`
  - `right_delta_edges=8699`
  - 程序提高左 PWM、降低右 PWM。
- 强修正版中：
  - `left_pwm_ticks=1500` 后左轮更慢，`left_delta_edges=504`
  - `right_pwm_ticks=280` 后右轮更快，`right_delta_edges=13077`

**我的误判**

- 我把 `DL_TimerG_setCaptureCompareValue()` 的 compare 值当成“越大有效占空比越大”。

**正确结论**

- 在当前 `TIMG0` PWM 输出配置下，compare 值与实际有效高电平占空比是反向关系：

```text
compare 越大 -> 有效占空比越小 -> 电机越慢
compare 越小 -> 有效占空比越大 -> 电机越快
```

- 闭环逻辑里应该区分“逻辑占空比”和“写入定时器的 compare 值”：

```c
logical_duty_ticks 越大表示越快
timer_compare = PWM_PERIOD - logical_duty_ticks
```

**后续规则**

- 后续所有电机驱动代码里，不能直接把“期望占空比 ticks”写入 compare。
- 必须先用万用表/编码器确认“compare 与实际速度”的单调关系。
- 正式 `motor_set_pwm()` 应保存逻辑 duty，写硬件时按当前 PWM 极性转换。

### 5. 闭环调试时没有先做 PWM 极性标定

**当时现象**

- 闭环一开始就根据 `delta_edges` 自动调 PWM。
- 由于 PWM 极性反了，闭环越调越偏，直到修正饱和。

**我的误判/流程问题**

- 少了一个“固定几个 PWM 档位，确认 ticks 越大速度是否越快”的标定步骤。

**正确结论**

- 速度闭环前应先单独做开环标定：
  - 左/右分别跑 30%、50%、70%。
  - 记录每档 100ms 或 3s 的 `edges`。
  - 确认 duty 与速度单调关系。

**后续规则**

- 进入任何闭环前，先标定：
  1. 编码器方向。
  2. 左右通道对应关系。
  3. PWM 极性。
  4. duty 与速度是否单调。

### 6. 编码器手转测试初期判断不够稳

**当时现象**

- 用户反馈编码器变量没有变化。
- 后续用电机带动轮子后，编码器 A/B 和计数都正常变化。

**我的误判/不足**

- 初期没有充分考虑 CCS Expressions 运行中不实时刷新、手转速度不稳定、轮询采样可能错过边沿。

**正确结论**

- 第一次验证编码器时，手转可以检查 A/B 电平，但计数验证更适合让电机低速稳定转动。
- CCS 变量观察应在运行一段时间后 Suspend 再看。

**后续规则**

- 编码器验证分两步：
  1. 万用表/Expressions 看 A/B 电平是否变化。
  2. 电机低速转动，Suspend 后看 `edges/count`。
- 不用“手转时变量没变”直接判断编码器没接好。

## 当前已确认事实

```text
PB0  -> AIN1 正常
PB1  -> AIN2 正常
PB2  -> BIN1 正常
PB3  -> BIN2 正常
PB4  -> STBY 正常
PA12 -> PWMA 正常
PA13 -> PWMB 正常

E1A -> PB12 正常
E1B -> PB13 正常
E2A -> PB14 正常
E2B -> PB15 正常

左轮前进时 encoder count 为负，需要取反。
右轮前进时 encoder count 为正。

当前 TIMG0 PWM compare 与有效占空比反向：
logical_duty = PWM_PERIOD - compare
```

## 当前推荐下一步

继续使用：

```text
C:\Users\1\Desktop\电赛\ccs_project\encoder_test\straight_ground_4s_test.c
```

以地面直行参数作为后续巡线基础 PWM。

## 2026-05-31：直行闭环软调参当前状态

使用：

```text
C:\Users\1\Desktop\电赛\ccs_project\encoder_test\straight_balance_closed_loop_soft.c
```

当前观测：

```text
g_debug_left_edges_1s  = 85082
g_debug_right_edges_1s = 86598
g_debug_error_1s       = 1516
g_debug_left_pwm_1s    = 859
g_debug_right_pwm_1s   = 841
```

结论：

- 右轮仍略快，所以 `error = right - left` 一直为正。
- 误差比例约 `1516 / ((85082 + 86598) / 2) = 1.8%`，台架悬空状态下已经可接受。
- 当前是 P 控制，存在小的稳态误差正常；如果要进一步压到 0 附近，需要加入积分项或静态 trim。

后续规则：

- 台架阶段先以 `1s edges` 差值小于 `5%` 为通过标准。
- 不追求悬空时 `error` 精确为 0。
- 上地测试前应降低基础 PWM，并准备随时断电。

## 2026-05-31：地面直行参数

当前 4 秒地面直行测试基本可直行，使用参数：

```c
#define PWM_LEFT_BASE_TICKS  665U
#define PWM_RIGHT_BASE_TICKS 635U
#define PWM_CORR_LIMIT       150
```

说明：

- 之前 `660/640` 仍轻微偏左。
- 用户误写参数少一位时出现严重偏右，不作为有效调参结果。
- 正确写入 `665/635` 后，用户反馈“差不多直了”。

后续巡线控制建议以该组作为基础值：

```c
left_pwm  = 665 - line_correction
right_pwm = 635 + line_correction
```

注意当前 PWM 为“逻辑 duty ticks”，写入 TIMG0 compare 时仍需使用：

```c
compare = PWM_PERIOD - logical_duty_ticks
```

## 2026-06-08：7 路红外前三路无响应现象

当前现象：
- 7 个红外模块依次经过黑线时，S1/S2/S3 完全无反应，S4/S5/S6/S7 能正常从 0 切到 1。
- 用户对调红外模块后，故障仍表现为“前三个位置无响应”，所以暂不优先判断为红外模块本体损坏。

排查结论倾向：
- 优先检查前三路输入链路：DO 杜邦线、面包板连接、MSPM0 对应 GPIO、代码引脚映射。
- 若仍使用 PA2/PA5/PA6，这三个脚已经出现过“外部碰 3.3V 仍读 0”的异常，应改用 PB5/PB6/PB7 重新验证。

## 2026-06-08：巡线前三路改口验证通过

当前结果：
- S1/S2/S3 从 `PA2/PA5/PA6` 改接到 `PB5/PB6/PB7` 后，7 路红外均能正常随黑线从 0 切到 1。
- 说明红外模块、阈值调节、基本读取代码均不是主要问题。

当前判断：
- `PA2/PA5/PA6` 暂列为不可用输入脚。用户已更换新板，因此排除“原板 GPIO 被早期高电压误接损伤”作为主因。
- 剩余可能原因包括：排针/面包板连接不可达、对应引脚焊接不良、实际接到的不是芯片对应引脚、板卡丝印/资料与实物排针位置理解不一致。
- 后续比赛开发不再依赖 `PA2/PA5/PA6`，优先保留现有可用映射：`PB5/PB6/PB7/PA7/PA8/PB9/PB10`。

## 2026-06-08：首次循迹试跑停车过敏

现象：
- 5 秒低速循迹版设置连续约 100 ms 丢线就停车，用户反馈“刚刚偏离就不走了”，无法观察车辆偏左还是偏右。

修正：
- 首次观察车辆偏向时，丢线保护不能过短。
- 当前改为约 12 秒试跑，连续约 2 秒丢线才停车，并将 `LINE_KP_DIVISOR` 从 16 调到 20，降低一点转向修正强度。

## 2026-06-08：循迹修正方向判断反了

现象：
- S3 在黑线上启动时车往右转，S4/S5 在黑线上启动时车往左转。

错误判断点：
- 之前按代码里的 left/right 命名推导 PWM 修正方向，但实际电机通道与物理左右轮方向不完全一致。

修正：
- `line_error > 0` 表示黑线在车体右侧，应让车向右找线。
- 当前代码已将 PWM 修正方向改为 `left = base - correction`，`right = base + correction`。
- S4 中线启动仍左转属于基础 PWM 偏置问题，下一步单独调基础左右 PWM，不再归因于传感器误差。

## 2026-06-08：直角弯不能只靠普通比例修正

现象：
- 圆角弯和 S 弯能过，直角弯容易冲出线。

判断修正：
- 这不是单纯传感器问题，也不应只继续提高普通 Kp。
- 原程序的 `PWM_MIN_TICKS=430` 让内侧轮在急弯时也保持较高速度，导致转向半径过大。

当前处理：
- 增加急弯模式：误差绝对值达到 `1800` 或短时丢线时，使用更强修正，并允许一侧轮低于普通最小 PWM。
- Watch 观察 `g_turn_mode`：`0=普通循迹`，`1=急弯`，`2=丢线找回`。

补充修正：
- 急弯模式不应为了过直角弯而明显加速外侧轮；这会带来入弯冲刺感和更大的出线风险。
- 当前策略改为“只降内侧轮，外侧轮保持基础 PWM”。若后续直角弯转不进去，优先继续降低内侧轮或降低整体速度，不优先提高外侧轮。

二次实测修正：
- 用户反馈“只降内侧轮”的版本直角弯偏出赛道更多。
- 当前结论改为：这辆车当前机械/速度条件下，直角弯需要外侧轮也加速，否则转向半径不够。
- 已回退到急弯外侧轮加速版本；后续控制“冲刺感”应通过降低整体速度或限制 `PWM_MAX_TICKS`，不是完全取消外侧轮加速。

## 2026-06-08：版本表述不清导致混淆

现象：
- 用户要求回到 21:43 的急弯策略版，但我前一次回复用了“改回刚才那版”的模糊表达，没有明确指出当前 `empty.c` 的具体逻辑。

修正：
- 已确认并标记当前代码为 21:43 急弯策略版。
- 以后回退调参版本时，必须引用具体参数和控制公式，不能只说“刚才那版”。

## 2026-06-29：PowerShell 环境下误用 Bash heredoc

现象：
- 在当前 Windows PowerShell 环境中，我用 `python - <<'PY'` 检查 PDF 依赖。
- PowerShell 不支持这种 Bash heredoc 写法，命令直接语法错误。

修正：
- 当前 shell 是 PowerShell，后续临时 Python 片段优先使用：

```powershell
python -c "..."
```

或 PowerShell here-string 管道形式。

后续规则：
- 在 Windows/CCS 调试环境里，不默认使用 Bash 语法。
- 涉及中文路径和 PDF 工具时，优先复制/使用英文路径，降低工具链路径编码问题。

## 2026-06-29：OpenMV UART3 P4/P5 方向写反

现象：
- 早期文档中写过 `OpenMV P4 (RX)`、`OpenMV P5 (TX)`。
- 后续核对 OpenMV 官方文档，`UART3` 实际为 `TX=P4`、`RX=P5`。

正确结论：

```text
MSPM0 PA10 / UART0_TX -> OpenMV P5 / UART3_RX
MSPM0 PA11 / UART0_RX <- OpenMV P4 / UART3_TX
```

后续规则：
- 串口不能只按“P4/P5”记忆，必须按 `TX -> RX`、`RX <- TX` 交叉核对。
- 写接线文档时同时写“板上引脚名”和“信号方向”，不要只写 P 号。

## 2026-07-02：急弯丢线找回与丢线自动停车逻辑冲突

现象：
- 21:43 急弯策略版已经有 `g_turn_mode=2` 的丢线找回逻辑：检测不到黑线时，继续使用 `g_line_last_error` 按最后一次偏差方向转弯。
- 但主循环里仍保留了 `g_line_lost_count >= LOST_STOP_SAMPLES` 后直接停车的保护，导致小车偏离较多或直角弯短时丢线时会自动停下。

判断修正：
- 对当前赛道循迹任务，运行中“短时丢线”应视为急弯/冲出边缘后的找回状态，而不是立即故障停车。
- 初始上电如果完全没检测到黑线，可以保留不启动保护；但运动过程中不应因为丢线计数达到固定阈值直接停车。

当前处理：
- 删除运行中丢线停车分支。
- 丢线时继续执行 `line_follow_update()`，让 `g_turn_mode=2` 维持最后方向找线。
- 后续若需要安全保护，应改成更高层的总运行时限、人工断电/复位、或按键停止，而不是低层循迹算法内的短丢线停车。

## 2026-07-02：只看代码是否调用 motors_stop 不足以判断车辆是否“停住”

现象：
- 用户反馈远离黑线后小车仍像是自动停止。
- 代码核对显示运行中没有丢线触发 `motors_stop()` 的分支，但丢线找回时 `g_line_correction` 可能很大，导致一侧轮 PWM 被压到几十 ticks。

判断修正：
- “代码没有调用停车函数”不等于“车辆一定会继续有效运动”。
- 对当前两轮小车，地面摩擦、电机死区、车身重量会让过低 PWM 的轮子实际不转；如果另一侧轮也受限或被拖住，视觉上会像停车。

当前处理：
- 丢线找回 `g_turn_mode=2` 下新增轮速下限：
  - 内侧轮最低 `220 ticks`。
  - 外侧轮最低 `760 ticks`。
- 仍保留 `PWM_MAX_TICKS=900` 作为最高速度边界。

后续规则：
- 调循迹时必须同时看软件状态和实际 PWM 输出：`g_turn_mode`、`g_line_valid`、`g_left_pwm_ticks`、`g_right_pwm_ticks`。
- 只靠有没有 `motors_stop()` 不能排除“低 PWM 等效停车”。

## 2026-07-02：丢线找回时强制外侧轮最低速度过激

现象：
- `20260702_163704` 版本给丢线找回加入了 `LOST_TURN_OUTER_MIN_TICKS=760`，用户反馈直线反而不稳，且转弯像停住的问题仍未解决。

误判点：
- 我把“保证丢线时车辆继续转”直接做成外侧轮固定较高下限，忽略了传感器短暂丢线/边缘抖动在直线段也可能触发 `g_turn_mode=2`。
- 一旦直线段短暂误判丢线，外侧轮被强行拉高，会造成突然转向扰动，所以直线稳定性变差。

修正：
- 回退外侧轮固定最低速度策略。
- 保留更温和的内侧轮最低地板，只防止内侧轮低到电机死区：`LOST_TURN_INNER_FLOOR_TICKS=260`。
- 后续对“丢线找回”要优先避免大阶跃输出，尤其不能让短暂丢线直接触发过强单侧加速。

补充规则：
- 处理启动没线时，不应停在 `g_phase=4`；当前比赛流程更合理的是先直走找线，遇到黑线再进入循迹。

## 2026-07-02：真实地面循迹不能依赖 Watch 诊断

现象：
- 用户指出：只有连接电脑时才能 Watch，但连接电脑时无法真实模拟小车地面循迹和转弯，因此基于 Watch 的判断在关键问题上不可用。

误判点：
- 我之前多次建议通过 `g_phase/g_turn_mode/g_pwm` 等 Watch 变量判断停车原因，这在台架或连 USB 场景有用，但对真实跑车场景不可执行。

修正：
- 后续真实跑车调试必须优先设计肉眼可见/可听/可测的反馈，例如板载 LED 状态码、蜂鸣器、固定动作模式、万用表测点。
- 本次代码加入 LED 状态码：
  - 上电/复位快闪。
  - 正常运行慢速心跳。
  - 急弯较快闪。
  - 丢线找回/无黑线找线快速闪。
- 同时加入 PWM 斜坡和循环重拉 `STBY`/方向脚，减少“复位”和“驱动失能”这两类只能靠现象判断的问题。

后续规则：
- 如果小车离线运行时用户无法看 Watch，不再把 Watch 当作首要诊断手段。
- 每个新版本都应说明肉眼观察点：LED 怎么闪、车应该怎么动、异常时怎么区分复位/算法找线/硬件不动。

## 2026-07-02：打靶任务下不能只以“能过弯”为循迹目标

现象：
- 用户指出后续要打靶，转弯后必须让中心红外 S4 对准黑线，否则车身姿态不稳定会影响打靶。

修正原则：
- 循迹目标从“尽快过弯、不冲出线”升级为“中心锁定后再高速直行”。
- 只要还有任意红外看到黑线，优先按线上慢速转弯/中速对线处理；不要提前进入加速救线。
- 只有 7 路全部检测不到黑线，且有最后方向记忆，才进入完全丢线加速找回。

后续规则：
- 评估版本时必须同时观察两个指标：
  - 是否能过弯。
  - 出弯后是否能快速、稳定地让 S4 对准黑线并减少折线。
- 为了打靶稳定，可以优先牺牲出弯速度、转弯灵敏度和极限过弯能力。

## 2026-07-02：视频复盘显示中心稳定门槛仍需更严格

现象：
- 用户提供真实跑车视频后，抽帧观察到小车能跑完整圈，但右侧斜角出弯后常带着斜角进入直线，随后在直线段折线追线。

修正判断：
- “能跑完整圈”仍不足以满足打靶任务；打靶前必须更关注车身姿态和中心红外 S4 稳定压线。
- S4 短暂亮起不应立即视为中心稳定；如果 S1/S2/S6/S7 边缘传感器还在触发，说明车身或传感器排仍处在偏线/切线状态。

后续规则：
- 中心稳定条件应同时满足：
  - S4 有效。
  - 误差足够小。
  - 边缘传感器未触发。
  - 连续稳定足够长时间。
- S3/S5 级别偏移就应该提前降速对线，不要等到 S1/S7 或大误差再处理。

## 2026-06-29：TI Arm Clang 后端优化 bug 绕过

现象：
- 舵机测试版 `empty.c` 首次编译时，TI Arm Clang 4.0.4.LTS 报 `underestimated function size`，属于编译器后端崩溃，不是 C 语法错误。

修正：
- 给若干初始化/设置函数增加 `__attribute__((noinline))`，避免优化器把 DriverLib 调用过度内联进 `main()`。
- 修改后编译通过。

后续规则：
- 如果 CCS 编译出现 clang backend crash，先尝试减少内联/降低单个函数复杂度，而不是优先怀疑外设配置。

## 2026-06-29：低估 MP1584 贴片电位器和焊盘的实际操作难度

现象：
- 用户拿到的 MP1584 小板电位器极小，普通工具和杜邦线头无法插入。
- 模块焊盘/端子若未焊排针，杜邦线不能可靠连接。

我的误判：
- 之前直接建议“用小螺丝刀拧电位器”，没有充分考虑这类超小贴片电位器现场没有合适工具时几乎不可调。
- 也没有第一时间强调：没有排针/接线端子时，MP1584 需要先焊线或焊排针，不能靠杜邦线硬插。

正确结论：
- 这种模块应先焊接排针或导线到 `VIN+/VIN-/OUT+/OUT-`，再调压。
- 调压工具应使用精密一字螺丝刀、镊子尖或电位器调节棒；没有合适工具时不要硬撬，避免短路或损坏电位器。
- 若现场没有焊接/调压条件，优先改用 5V 充电宝/手机充电器 USB 线给舵机供电。

后续规则：
- 对超小 DC-DC 模块，先确认是否已焊排针、是否有可用精密工具，再给接线步骤。
- 不把“能调压”默认等同于“现场马上能安全调压”。
## 2026-07-02：版本状态不能只按对话记忆判断

现象：
- 用户要求比较 `20260702_191813_restore_pre_sharp_turn_for_test.c` 和 `20260702_191058_line_follow_center_first_v2_video_review.c`。
- 开始处理时重新查看 `C:\Users\1\Desktop\ELECTRIC\ele-car\empty.c`，发现当前工程文件已经不是刚回退的纯 191813，而是一个 `Combined line-following` 中间态，并且仍保留了 191058 的五状态机骨架。

风险：
- 如果直接在“以为当前是 191813”的前提下继续修改，会把错误版本继续叠加，导致现场测试结果和记录文件对不上。

修正：
- 每次涉及“回退、合并、恢复某版本”时，先核对三件事：
  - `empty.c` 文件头部说明；
  - 关键参数，例如 `PWM_LEFT_BASE_TICKS`、`LINE_SHARP_ERROR`、`RUN_SAMPLES`；
  - 当前文件与目标备份的 SHA256。
- 确认当前文件状态后，再决定是基于当前文件打补丁，还是从已命名备份重新生成正式版本。

## 2026-07-02：复杂状态机可能不适合当前循迹阶段

现象：
- 多个版本尝试了中心锁定、出弯稳定窗、普通段阻尼、急弯触发冷却等状态机策略，但现场反馈直线/出弯后的左右摇摆仍然没有明显改善。
- 相比之下，最早的普通 P 循迹版本虽然直角弯不过，但直线明显更稳。

判断修正：
- 当前 7 路数字红外传感器输出是离散跳变，不是连续模拟灰度；车身出弯时传感器排会斜切黑线，容易让 S1/S7、S3/S5 断续触发。
- 在这种输入下，复杂状态机很容易被短暂传感器跳变反复触发，造成“急弯/稳定/直线”来回切换，实际比简单 P 控制更抖。

后续规则：
- 优先保留普通 P 循迹作为主干。
- 只对明确问题加局部补丁，例如直角弯时短时增强差速。
- 每加入一个状态，都必须能用肉眼现象明确判断它是否被触发；否则先不用。
- 若普通版直线稳但直角弯不过，优先调 `LINE_SHARP_ERROR`、`LINE_SHARP_CORR_LIMIT` 这类窄参数，而不是重新引入中心锁定/出弯窗口。

## 2026-07-02：视频复盘前不要继续调“看起来像主因”的直线抖动

现象：
- 用户提供 `757377267a4edf9d61f6155f8d630793.mp4` 后，抽帧观察发现小车普通直线并没有持续严重蛇形。
- 真正重复出现的问题在上方直角弯：小车进入直角弯时转向开始偏晚，转弯半径偏大，贴外侧甚至略冲出后再绕回来。

判断修正：
- 之前围绕“直线状态机/出弯抖动”做了多轮尝试，但视频显示当前版本的主要瓶颈已经转移到直角弯转入不够早、不够稳。
- 对这类问题，继续加直线阻尼、中心锁定或状态机冷却不是首选；应保持简单 P 主干，只做非线性转弯补偿。

后续规则：
- 每次用户给实车视频后，先抽帧确认主失败段，再动代码。
- 先区分：
  - 直线持续蛇形；
  - 入弯过晚/转弯半径大；
  - 出弯姿态斜；
  - 完全丢线。
- 不同现象对应不同改法，不能把所有问题都归因到状态机或直线 P 参数。
## 2026-07-02：转弯冲出与复放打转不能只按“转弯力度”解释

现象：
- 小车有时到转弯处直接冲出赛道，像是没有识别到转弯。
- 拿起小车重新放回线上后，可能原地打转。

误判点：
- 之前主要围绕 `LINE_SHARP_ERROR`、`LINE_SHARP_CORR_LIMIT`、转弯速度等参数调节，把问题看成“急弯力度不够/触发太晚”。
- 这忽略了两个更基础的逻辑条件：
  - 多个红外同时压到宽黑线时，离散权重平均值可能接近 0，算法会把真实直角弯误判成居中直行。
  - 完全丢线恢复如果没有时间上限，旧的 `g_line_last_error` 会一直支配输出，车被拿起来再放下后仍可能按旧方向旋转。

修正原则：
- 对 7 路数字红外，不能只看 `sum / count` 的平均误差，还要看 `active_count` 和外侧传感器组合。
- “短时丢线找回”和“长时间离线/被拿起”必须区分：前者可以按最后方向找线，后者必须清空旧转向记忆，避免复放后旧状态污染。
- 以后遇到“没识别到转弯”的反馈，先检查传感器组合模式是否被平均算法抵消，再调急弯强度。
## 2026-07-02：舵机测试不能占用 PA12/PA13 电机 PWM 脚

现象：
- 我先给出了 `PA12` 单舵机测试版本。
- 用户提醒：`PA12` 已经被 TB6612 `PWMA` 占用。

误判点：
- 我把“临时断开/禁用电机时可复用 PA12”与“在当前整车接线基础上继续加舵机”混在了一起。
- 对现场任务来说，用户要的是在现有小车接线基础上继续扩展舵机，所以不能再占用 `PA12/PA13`。

修正：
- 舵机正式信号脚回到预留方案：`PA3/PA4`。
- 当前先用 `PA3` 做单舵机轻载测试。
- 以后给测试代码前，必须先核对当前整车已占用引脚，不能只按“某个孤立测试可用”来选脚。
## 2026-07-02：没有先核查 LaunchPad 板级隔离，误把 PA3/PA4 当作可直接接舵机的排针脚

现象：
- 舵机供电稳定 5V 后仍不转，`PA3/PA4` GPIO 诊断也测不到有效电平。
- 用户进一步发现 `PA2~PA7` 一组引脚测量现象特殊，并明确排除了焊接和万用表测量问题。

误判点：
- 我只根据 MSPM0G3507 芯片 IOMUX/定时器功能判断 `PA3=TIMG8_C0`、`PA4=TIMG8_C1` 可用于舵机 PWM，没有第一时间核查 `LP-MSPM0G3507` 开发板原理图。
- 官方原理图显示 `PA2-/PA3-/PA4-/PA5-/PA6-` 到 MCU 真实引脚之间有 `DNC` 隔离电阻；默认不焊，因此低侧排针上的这些网络并不等于 MCU 引脚。

正确结论：
- `PA2~PA6` 在芯片层面可作为 Standard GPIO，但在 LP-MSPM0G3507 开发板上属于时钟/校准相关关键脚，且默认与外部排针隔离。
- 舵机信号不要继续选 `PA3/PA4`，除非明确焊接对应 0Ω/隔离电阻并确认不再使用晶振相关功能。

后续规则：
- 以后选 MSPM0 引脚必须同时核对两张表：芯片 pin attributes/IOMUX + LaunchPad 原理图/排针连接。
- “芯片支持该功能”不等于“开发板排针可直接杜邦线使用”。

## 2026-07-03：双舵机等脉宽时调用 delay_cycles(0)，误把卡死现象继续往硬件方向排查

现象：
- 双舵机 PA14/PA17 程序编译和烧录都成功。
- 程序一开始运行，`PA15 LED` 从熄灭变成常亮，但舵机不转。

误判风险：
- 如果继续只看“舵机不动”，很容易又怀疑供电、接线、舵机本体或 PA14/PA17 引脚。
- 但 LED 已经被程序改变，说明程序至少执行到了第一次 `hold_position()`，问题更像是第一帧输出后卡住。

真正问题：
- 第一帧两个舵机都是 `1500us` 中位，旧版 `servo_output_one_frame()` 在 `x_us == y_us` 时会计算出第二段延时为 0。
- `delay_us(0)` 调用 `delay_cycles(0)`，在当前 TI 编译/库环境下可能卡住或行为异常。
- 这会造成 LED 只翻转一次后常亮，某一路舵机信号可能停在高电平或异常状态，舵机自然不按 50Hz PWM 动作。

修正：
- `delay_us()` 对 `us == 0` 直接返回。
- `x_us == y_us` 单独处理：两个舵机信号同时拉高、延时、同时拉低。

后续规则：
- 软件 PWM 生成多路脉冲时，必须显式处理“两个通道脉宽相等”的情况。
- 所有底层忙等待函数都要把 0 延时作为合法输入处理，不允许把 0 直接传给底层 cycle delay。
## 2026-07-03：普通三线舵机不能通过控制线反读当前位置

现象：
- 用户希望把当前已经手动扭到正确方向的 OpenMV 云台位置“通过程序读出来”，再作为以后上电回正位置。

容易误判点：
- 容易把普通三线 PWM 舵机误当成带反馈舵机，认为 MSPM0 可以从 PA14/PA17 读出当前角度。
- 实际上 PA14/PA17 只是控制信号输出脚，普通舵机内部电位器反馈只在舵机内部闭环使用，不会通过信号线返回给单片机。

正确结论：
- 如果当前角度是程序控制出来的，可以从 Watch 读取 `g_servo_x_us/g_servo_y_us`，这两个值代表当前命令脉宽。
- 如果当前角度是断电后手动扭出来的，MSPM0 无法反读，只能通过调整 `g_servo_x_home_us/g_servo_y_home_us` 让舵机主动转到该方向，再把对应脉宽固化。

后续规则：
- 云台“回正”必须定义为一组 PWM 脉宽，而不是读取机械当前位置。
- 需要可复现初始方向时，使用 HOME 校准流程；不要依赖断电手扭后的未知角度。
## 2026-07-03：OpenMV 倒装时不能只靠反转舵机方向补救

现象：
- OpenMV 机械上倒装，IDE 预览图像和 `cx/cy` 坐标都倒置。
- MSPM0 端 Watch 显示 `g_servo_y_home_us=1250`，已经顶到旧版舵机最小限位。

容易误判点：
- 看到“云台方向倒”时，容易只改 `AIM_X_PULSE_SIGN/AIM_Y_PULSE_SIGN`。
- 但这样只能让舵机可能追得动，OpenMV IDE 画面和坐标系仍然是倒的，后续阈值调试、中心校准、激光打靶都会变得反直觉。
- 旧版舵机范围 `1250..1750us` 是保守保护值，但当前机械安装角度需要更大俯仰范围，继续用旧范围会误以为舵机无法到位。

正确结论：
- 摄像头物理倒装时，优先在 OpenMV 端修正图像坐标系：`sensor.set_hmirror(True)` + `sensor.set_vflip(True)` 等效 180 度旋转。
- 舵机方向反再单独用 MSPM0 的 `AIM_X_PULSE_SIGN/AIM_Y_PULSE_SIGN` 调，不要混在图像倒置问题里。
- HOME 校准阶段可以临时把舵机范围放宽到 `900..2100us`，但要观察机械限位，不能长期顶死。

后续规则：
- 视觉闭环调试顺序固定为：先让 IDE 图像正，再看 `cx/cy` 是否随目标方向直观变化，最后才调舵机正负号。
- 如果 Watch 里的 HOME 值顶到 min/max，先怀疑软件限位过窄或机械中位不合适，不要立刻判断舵机/供电坏。
## 2026-07-03：云台 Y 轴校准范围不能过早用保守限位锁死

现象：
- OpenMV 倒装后，用户继续校准俯仰舵机，发现需要把 Y 轴 HOME 往 `1250us` 以下继续调。
- 之前我把舵机范围先放宽到 `900..2100us`，但对当前机械安装来说，Y 轴还可能需要从 `750us` 甚至更低位置开始探索。

误判点：
- 我把“保护舵机”的保守范围和“现场寻找机械 HOME”的校准范围混在了一起。
- 对调试阶段来说，过早卡死下限会让用户误以为机械方向已经到极限，实际只是软件限位挡住了。

修正：
- 普通追踪阶段保留 `SERVO_Y_MIN_US=750us` 作为运行保护。
- 校准阶段单独使用 `SERVO_Y_CALIB_MIN_US=0us`，允许 `g_servo_y_home_us` 继续向下试。
- 最终找到 HOME 后，再根据实际机械安全范围重新收紧正式运行限位。

后续规则：
- 舵机调试至少区分两套范围：校准探索范围、正式运行保护范围。
- 不能把正式运行的保守限位直接用于第一次机械安装校准。
## 2026-07-03：校准开关遗留会把正式追踪锁死

现象：
- 用户完成云台 HOME 校准后进入 OpenMV 追踪测试，OpenMV 看起来已经检测到物体，但舵机始终没有变化。

误判风险：
- 容易继续怀疑 OpenMV 阈值、串口、舵机方向或舵机供电。
- 但上一轮 Watch 明确显示 `g_servo_calibrate_enable=1`、`g_aim_state=5`，旧代码在该状态下会每帧强制 `servo_go_home_now()`，并跳过追踪更新。

真正问题：
- 校准模式和正式追踪模式共用同一份代码时，调试开关如果靠 Watch 手动置位，就可能在没有复位/重新烧录的情况下遗留。
- 这会导致“视觉检测正常，但舵机命令被强制 HOME 覆盖”的假象。

修正：
- 校准完成后的正式追踪版不再允许 `g_servo_calibrate_enable` 阻断追踪。
- 变量保留给 Watch 兼容，但程序发现其为 1 时自动清回 0。

后续规则：
- 临时校准开关不要直接留在正式运行主路径里。
- 如果必须保留，正式版要默认不可阻断主控制链路，或者使用编译期宏明确区分 calibration build 和 tracking build。
## 2026-07-03：OpenMV 本地识别正常不等于 MSPM0 UART 收到数据

现象：
- 用户只有一根 USB，OpenMV 程序已保存到板内独立运行。
- OpenMV 灯遇到红色物体会变化，说明视觉脚本本地识别在工作。
- MSPM0 Watch 中 `g_omv_tx_requests` 增加，但 `g_omv_rx_bytes` 一直为 0。

误判风险：
- 容易把“OpenMV 本地识别到了目标”误认为“MSPM0 已经收到目标坐标”。
- 实际上这两件事中间隔着 UART 命令线和回传线。灯光变化只证明 OpenMV 自己运行，不证明 P4/P5 串口链路通。

正确判断：
- `g_omv_tx_requests` 增加只表示 MSPM0 正在发请求。
- `g_omv_rx_bytes=0` 表示 MSPM0 没收到任何 OpenMV 字节，优先查 `OpenMV P4 TX -> MSPM0 PA11 RX`、共地、PA11 是否被板载 backchannel UART 跳线帽干扰、OpenMV 是否运行正确 UART 脚本。
- 为隔离命令线问题，OpenMV 应提供主动串流测试版：即使没收到 MSPM0 命令，也周期性从 P4/TX 发颜色帧。

后续规则：
- 视觉调试必须区分三层：OpenMV 本地识别、OpenMV UART 发出、MSPM0 UART 收到并解析。
- `Rx=0` 时不要继续调阈值或舵机算法，先打通单向 UART 回传。
## 2026-07-04：J21/J22 UART 跳帽不是拔空，而是要切到 BP 位置

现象：
- MSPM0 端 `g_omv_tx_requests` 增加，但 `g_omv_rx_bytes` 一直为 0。
- 用户拍摄 LP-MSPM0G3507 板载 UART 跳帽区域，要求检查 J21/J22。

误判点：
- 我前面把 J21/J22 当成“只需拔掉以断开 XDS110 干扰”的普通串口跳帽处理。
- 后续查 TI 官方资料和 TI E2E 经验后修正：J21/J22 是路由选择跳帽，应从 `XDS` 位置移动到 `BP` 位置，而不是拔空。
- 如果拔空，PA10/PA11 可能没有路由到外部 BoosterPack 排针，OpenMV 接在排针上时 MSPM0 自然收不到数据。

正确结论：
- 使用 OpenMV 接 `PA10/PA11` 外部排针时，J21/J22 两个跳帽应放在 `BP` 侧。
- 不能保持在 `XDS` 侧，也不能直接拔空。
- 之后再看 `g_omv_rx_bytes` 是否增加。

后续规则：
- 对带 `XDS/BP` 丝印的 LaunchPad 跳帽，先判断它是“断开跳帽”还是“路由选择跳帽”。
- 不能简单把所有 XDS UART 跳帽都解释为拔掉；需要看官方用户指南/原理图或板上丝印。
## 2026-07-04：视觉云台固定目标仍持续移动，不能只靠提高速度解决

现象：
- OpenMV/MSPM0 串口打通后，舵机可以正常转动。
- 用户反馈红色目标固定不动，但舵机仍持续移动，有时明显偏出边界。
- 同时舵机速度太慢，不满足后续行进间打靶。

风险判断：
- 如果只把 `AIM_MAX_STEP_US` 调大，方向反或误识别导致的跑偏会更严重。
- 旧 MSPM0 控制策略是按每帧误差累加小步长，本质上像一个慢速积分控制；它对方向错误、坐标抖动、小红色噪声比较敏感。

正确处理：
- 先保证方向正确：目标在画面右侧时，云台必须朝目标追；如果越追越偏，改 `AIM_X_PULSE_SIGN`，上下同理。
- 再提高速度：提高单帧最大步长和 OpenMV 串流频率。
- 同时加稳定措施：中心死区、坐标低通滤波、连续帧确认、小目标拒收。

后续规则：
- 云台闭环调参顺序：方向符号 -> 目标稳定性 -> 死区/滤波 -> 速度。
- 固定目标仍持续移动时，优先查方向和误识别，不要先调大速度。
## 2026-07-04：舵机机械方向改变后不能沿用旧 HOME

现象：
- 舵机到达过机械临界值，随后用户调整了舵机方向/机械方向。
- 原先的云台 HOME 为 `X=1500/Y=580`。

风险：
- 舵机机械方向改变后，旧 HOME 数值不再代表同一个物理姿态。
- 继续用旧追踪版可能在上电或追踪时再次把舵机推到机械边界。

修正：
- 立即切回纯 HOME 校准版，不追踪 OpenMV。
- 从 `1500/1500` 中位重新开始找 HOME。
- 校准完成后再把新的 X/Y 固化到追踪版。

后续规则：
- 任何舵机拆装、换方向、换连杆、换孔位之后，都必须重新校准 HOME。
- 不要把旧 HOME 当作软件常量长期信任，它绑定的是当时的机械结构。

## 2026-07-04：OpenMV 停止现象不要过早归因到脚本，需要先确认供电状态

现象：
- OpenMV 使用过程中灯灭、停止，需要重新上电才恢复。

现场确认：
- 用户确认当时没有连接电池，仅靠 USB 供电，掉电/供电不足是直接原因。

容易误判点：
- 容易继续往 OpenMV watchdog、脚本异常、串口阻塞方向排查。
- 实际上视觉模块、舵机、MSPM0 同时工作时，供电状态必须先确认，尤其不能用“只接 USB”的状态外推实战状态。

后续规则：
- 遇到 OpenMV 自停、灯灭、重启类现象，第一步先确认电池/5V 供电和共地，再看脚本。
- 当前左右反向属于舵机闭环符号问题，只改 `AIM_X_PULSE_SIGN`，不要同时动 OpenMV 图像翻转和 Y 轴方向。

## 2026-07-04：不要把普通 PWM 舵机的角度范围误当作软件可无限扩展

现象：
- 用户希望云台左右各 360 度旋转。

容易误判点：
- 容易以为只要把 `SERVO_X_MIN_US/SERVO_X_MAX_US` 继续放宽，就能让普通三线舵机实现 360 度绝对位置控制。

正确结论：
- 普通三线 PWM 舵机只有有限机械角度，PWM 脉宽只是给定该范围内的目标位置。
- 连续旋转 360 度舵机通常把 PWM 解释为速度/方向，不再是绝对角度；它能转一整圈，但不能直接用当前这套 `目标坐标 -> 角度位置` 逻辑精确瞄准。
- 真正需要大角度绝对瞄准时，应使用带位置反馈的多圈/串口舵机，或小电机+编码器闭环。

后续规则：
- 放宽舵机脉宽范围只用于寻找机械可用边界，不能承诺 360 度。
- 一旦舵机嗡鸣、卡死、发热或电源掉压，立即收窄范围或断电，优先保护供电和舵机。
## 2026-07-05 OpenMV 灯变化不能等价于链路正常

- 容易误判点：看到 OpenMV 绿灯/蓝灯仍随目标变化，就认为 OpenMV 程序和 MSPM0 通信都正常。
- 正确判断：灯变化最多只能说明 OpenMV 视觉循环或 LED 更新逻辑仍在执行，不能证明 UART 帧持续发出，更不能证明 MSPM0 已收到并完成目标判定。
- 后续排查顺序：先看 `g_omv_frame_count/g_omv_color_frame_count/g_omv_rx_bytes` 是否增加；再看 `g_diag_stage` 区分无链路、无目标、小目标、确认等待、死区、已更新舵机命令、撞限幅。
- 对策：OpenMV 脚本应避免脱机 `print`，避免无上限 `while uart.any()`，并加入异常恢复/看门狗/定期 GC。当前对应脚本为 `C:\Users\1\Desktop\电赛\ccs_project\openmv_test\20260705_145746_openmv_uart_stream_watchdog_no_print_rot180.py`。
## 2026-07-05 OpenMV P4 接触不良被误判为卡死风险

- 实际原因：OpenMV `P4/UART3_TX` 接触不良。
- 表现：OpenMV 视觉灯可能仍会变化，但 MSPM0 收不到稳定 UART 回传，舵机表现为停止响应，容易被误判为 OpenMV 程序卡死、电源掉电、舵机控制逻辑错误。
- 正确排查顺序：先检查 `P4 -> PA11`、`P5 -> PA10`、公共 `GND` 的接触与防松；再看 `g_omv_rx_bytes/g_omv_color_frame_count` 是否持续增加；最后再判断脚本、阈值、舵机限幅或电源。
- 工程措施：P4/P5/GND 不应只靠松散杜邦线，至少需要胶带/热熔胶/扎带固定线束，避免云台转动或小车震动造成瞬断。
## 2026-07-05 烧录权限判断误差

- 事件：用户说“把最终循迹代码给我先烧录试一下”后，助手按字面理解准备执行烧录流程。
- 问题：用户此前已经建立长期规则：后续调试程序默认只需要生成/恢复代码并验证编译，烧录由用户手动完成。即使用户临时口语中出现“烧录”，在上下文存在冲突时应先按长期规则谨慎处理，至少不要继续执行真实烧录命令。
- 实际状态：本次只恢复了稳定循迹代码、重新编译，并查询了 DSLite 帮助入口；未执行任何向板子写入的烧录命令。
- 后续规则：除非用户非常明确地再次确认“现在由你执行烧录/运行 DSLite 写入板子”，否则只提供当前 `empty.c`、时间戳源码和编译结果。
## 2026-07-05 S5 长期在黑线上现象误判风险

- 现场澄清：之前观察到“车辆一直像是从左到右第 5 个传感器 S5 在黑线上”，实际原因是有一个传感器线松了。
- 容易误判点：看到车持续偏向某一侧，容易直接判断为循迹修正方向反、电机左右通道反或 PID 参数错误。
- 正确判断：如果现象是“前半圈正常，后半圈某处突然偏，拿起重放后仍持续偏”，应优先怀疑传感器接线松动、DO 线悬空、GND/VCC 接触不良或线束被云台/车身拉扯，而不是先改算法方向。
- 软件风险：当前红外输入配置为 `DL_GPIO_RESISTOR_NONE`，传感器 DO 线松动时 MSPM0 输入脚可能悬空并随机读 0/1。后续可考虑给 7 路红外输入加内部下拉，降低断线悬空造成的假黑线风险。

## 2026-07-06 B 点找不到靶不能只归因于 OpenMV 阈值

- 现场现象：B 点停车后没有找到靶子，水平云台向左转动幅度不够；OpenMV 稍远时抓取不稳定。
- 容易误判点：把问题直接归因于 OpenMV 红色阈值太严格或目标面积门槛太高，然后盲目放宽 `MIN_RED_PIXELS/MIN_RED_AREA`。
- 正确判断：B 点找靶首先要确认 MSPM0 状态机是否真的允许云台搜索。此前 `aim_should_hold_for_chassis_turn()` 会在 `g_turn_mode=1/2` 时禁止丢目标搜索；如果停车前残留急弯/丢线状态，云台静止瞄准时也可能不主动搜索。
- 工程修正：B 点进入静态瞄准时先做水平左预瞄，清除旧循迹状态和旧目标滤波；`PHASE_MISSION_AIM` 阶段不再因为底盘转弯状态而禁止搜索。
- 后续规则：远距离识别差时，优先组合处理“靶面更大/颜色更纯、B 点预瞄方向、ROI 或边缘过滤”，不要只降低阈值，否则空场景误识别和灯乱闪会变严重。
- 2026-07-07：全程 OpenMV 预偏转 V5 的赛段模型判断错误。上一版把云台预偏转拆成 AB/BC/CD/DA 离散目标，并给 DA 加右偏，这与题图和用户现场意图不一致。正确模型应按整圈几何进度连续变化：A->B->BC 中点保持左偏；BC 中点后线性回正；到下一次 A 回到正前方。后续遇到“靶位固定、车绕赛道运动”的问题，应优先画出目标相对车体的几何方位变化，再决定云台预瞄曲线，不要直接按赛段硬切。
- 2026-07-07：ABCD 点位继续使用 `g_run_sample` 时间步估距是错误的工程判断。用户实测 A->B 比地图实际距离多约 2/5，说明时间步与真实距离严重不一致，受电压、负重、地面摩擦、循迹修正影响很大。正确方向：短期可按现场误差把 sample 阈值整体乘 `5/7`；长期必须接入编码器，用左右轮前进边沿平均值替代 `g_run_sample` 触发 B/C/D/A 点位。以后只要涉及“按地图距离停车/触发任务”，不应优先使用固定时间/sample。
- 2026-07-07：舵机范围调试中不能把 `SERVO_X_MIN_US` 当成普通角度下限无限降低。用户将下限试到 `0U` 后出现舵机持续左转/乱转；原因是 `0us` 不是有效舵机控制脉宽，而是非法或类似丢失控制信号的状态。后续扩大舵机范围应在安全脉宽内逐步试探，例如 `300..2800us`，并观察顶死、抖动、发热和持续嗡鸣；若舵机本体只有 180°，代码无法强行变成 270°，只能通过更换 270°舵机或机械传动实现。
- 2026-07-07：V11 将 `SERVO_X_MAX_US` 放宽到 `2800U`、`COURSE_LEFT_TARGET_US` 放到 `2750U`，现场导致水平舵机左偏超过 270°。这是参数安全边界判断失误：舵机脉宽不是角度闭环，MSPM0 不知道真实机械角度；超过舵机/云台当前安装的有效标定区后，舵机会继续追极限甚至过转。已在 V12 回退到 `SERVO_X_MIN_US=350U`、`SERVO_X_MAX_US=2650U`、`COURSE_LEFT_TARGET_US=2550U`。以后扩大舵机范围必须先单独做静态扫角测试，每次只增加 50us，并观察是否顶死/抖动/发热，不能直接上车跑。
- 2026-07-07：V12 “左偏保持到 CD 中点”宏配置正确，但主循环只调用 `course_preaim_target_x_us()` 更新目标变量，没有在未锁定目标时主动驱动 `g_servo_x_us`。真正的舵机步进逻辑仍只在 `aim_search_for_lost_target()` 中，因此 AB 段可能完全不左偏。用户指出“之前版本不是已经实现过预偏转吗”，判断正确。V13 修正为抽出旧版步进逻辑 `course_preaim_step_to_target()`，主循环每帧调用 `course_preaim_update_when_unlocked()`：未稳定锁定目标时主动预偏转，稳定锁定后交给 OpenMV 闭环。
- 2026-07-07：V13 的“主动预偏转”虽然解决了变量只计算不动作的问题，但偏离了用户现场确认过的 V9 触发手感。用户强调 V9 实际已经能在无目标时预偏转，问题只是回正临界点不对。正确修正应以 V9 为基底，只把回正起点从 `330` 改为 `559`，并保留 `aim_search_for_lost_target()` 内由 OpenMV 无可用目标触发的步进方式。已生成 V14：`20260707_164523_v9_trigger_left_until_cd_mid_v14.c`，不包含 `course_preaim_update_when_unlocked()`。
- 2026-07-07：V16 中把“水平舵机左转只能到约 180 度且像卡住”误判为机械结构/舵机本体有效行程限制，因而没有扩大 `SERVO_X_MAX_US` 和 `COURSE_LEFT_TARGET_US`。用户纠正：舵机本体支持 270 度，实际是代码最大偏转范围限制。正确处理是先核对 `SERVO_X_HOME_US/SERVO_X_MAX_US/COURSE_LEFT_TARGET_US` 是否足以覆盖目标角度，再判断机械限制。已在 V17 将 `SERVO_X_MAX_US` 提到 `3050U`，`COURSE_LEFT_TARGET_US` 提到 `3000U`。
- 2026-07-07：水平舵机 180/270 度问题的排查顺序不严谨。连续在“机械限制”和“代码限幅”之间切换判断，但没有优先确认舵机类型：位置舵机、270 度位置舵机、连续旋转舵机，还是机械云台可手动无限转但舵机输出轴不可绝对定位。正确流程应先写隔离扫角/类型识别程序，看不同脉宽下舵机是到固定位置后保持，还是持续旋转；再决定是否扩大脉宽范围或改成定时扫描策略。已将当前工程回退到 V16 安全边界，等待舵机类型确认。
- 2026-07-07：恢复历史源码到 `empty.c` 时，`Copy-Item` 会保留源文件旧时间戳，可能导致 CCS `gmake all` 判断目标已是最新状态，从而没有重新编译，存在烧录到旧 `ele-car.out` 的风险。本次恢复 V19 时首次 `gmake all` 显示 up to date，已及时改为 `gmake clean` + `gmake all`。后续凡是从历史版本复制源码恢复当前工程，都必须 clean build，不能只看普通 build。
- 2026-07-07：面对“中间直线无黑线”的比赛场地，最初准备加入固定时间/sample 的开环桥接，这是不充分的。用户指出关键问题：如何确保转弯结束后车身走直线并正好对上下一个弯道。正确判断是：无线路段不能只靠时间盲走，必须使用编码器差速闭环保持直线，并用红外重新捕线作为退出条件；否则电池电压、地面摩擦、前一段弯道姿态误差都会导致桥接段偏离。已回退未完成的 V20 开环桥接，当前保持 V19。
- 2026-07-07：继续推进编码器桥接时，容易把“编码器能保持直线”误当成“能保证走正确连接线”。用户指出：如果出弯姿态已经错了，编码器只会沿错误方向稳定直走。正确方案必须包含相位门控、入口姿态/边缘图案验证、编码器直线闭环、重捕线确认四部分。仅有编码器差速 PID 不足以解决无线路段对准问题。
## 2026-07-08：A 点无线桥接不应在编码器方向未复测前默认闭环

现象：
- V23 A 点无线起步桥接版烧录后，小车一直绕同一个顺时针圆圈，没有直行。
- 手动让红外连续约 4 秒识别到黑线后，也没有稳定进入循迹。

判断失误：
- 方案设计时过早把“编码器差速闭环”作为 A 点桥接的默认控制方式。
- 虽然代码沿用了“左轮前进计数取反、右轮前进计数为正”的历史约定，但现场换版本、换接线、换板、比赛场地环境后，编码器方向和相序必须重新复测。
- 未复测前直接闭环，一旦任一侧编码器方向与假设不一致，`left_forward - right_forward` 的修正会变成正反馈，表现为固定方向画圆。

修正：
- V24 新增 `START_GAP_USE_ENCODER_BALANCE=0U`，首测默认关闭编码器闭环，只保留编码器计数观察。
- 新增 `START_GAP_LEFT_TRIM_TICKS/START_GAP_RIGHT_TRIM_TICKS`，先用开环直行和小幅机械补偿确认 A 点桥接能接近下一段线。
- 新增 `PHASE_START_GAP_ALIGN`，重捕线后先稳定若干帧，再进入正式循迹。

后续规则：
- 任何“依赖编码器方向”的控制逻辑，在实车烧录前必须先做隔离方向测试：前推左轮、前推右轮时，对应 forward 量必须都为正。
- 没有完成方向测试前，编码器只能作为 Watch/诊断量，不应直接参与闭环控制。
- 对 A 点无线桥接这类高风险现场功能，第一版应先用可解释的开环/半闭环验证状态切换，再打开闭环。
## 2026-07-08：A 点重捕线逻辑过度复杂导致错过弯道

现象：
- V25 中小车从 A 点无线段大致直行，已经接近弯道入口。
- 但进入弯道时没有切换到循迹，而是继续直走。

判断失误：
- 为了防止“擦到线就误切”，V25 增加了中心锁定条件：`g_line_valid=1`、`abs(g_line_error)<=1200`、`S3/S4/S5` 至少一个压线、连续 5 帧。
- 这个条件对“任意未知赛道的重捕线”有意义，但对当前固定赛道 A 点入口过于保守。
- 现场真实需求是：弯道入口已经是预期有线窗口，只要任意一个红外识别到黑线，就应该马上交给普通循迹，而不是继续桥接直走。

修正：
- V26 改为 `START_GAP_REACQUIRE_FRAMES=1U`。
- `start_gap_bridge_update()` 中只要 `g_line_valid != 0U`，立即 `line_follow_update()` 并进入 `PHASE_LINE_RUN`。
- V25 的捕线状态暂时保留但不再由桥接入口触发。

后续规则：
- 对固定赛道，应区分“未知环境误检”和“预期有线窗口”。在预期有线窗口内，传感器触发条件应简单直接。
- 不要把通用鲁棒性条件无差别套到固定赛道任务，否则会错过关键时机。
- 现场反馈已经证明“复杂但保守”的逻辑不一定更好；小车控制优先追求及时响应和可调参数少。
## 2026-07-08：红外极性反转判断被现场电压测量排除

现象：
- V26 中用户反馈无论是否在黑线上启动，小车都只响上电 1 声，没有听到桥接 2 声或重捕 3 声。
- 助手初步怀疑 `LINE_BLACK_IS_HIGH` 极性可能反了。

现场确认：
- 用户用万用表测得：白线/白底 DO 为 0V，黑线 DO 为 3.3V。
- 因此 `LINE_BLACK_IS_HIGH=1` 是正确的。

判断失误：
- 过早把“没有 2 声/3 声”归因到红外极性反了。
- 实际还存在其他解释：某一路红外上电初始误触发、状态蜂鸣太快听不清、车实际路径没有压线、或烧录版本不一致。

修正：
- V27 不改极性，而是增加状态切换强制停车 2 秒。
- 进入桥接、上电直接循迹、桥接重捕线进入循迹分别用不同蜂鸣和停车事件区分。

后续规则：
- 遇到红外识别异常时，优先以万用表/静态测试确认 DO 电平，再判断 `LINE_BLACK_IS_HIGH`。
- 不要只凭蜂鸣现象直接推断极性；蜂鸣本身也可能因为状态切换太快、覆盖或现场噪声而误导判断。
## 2026-07-09 V30 参考代码式重写过度

- 现象：V30 烧录后，用户反馈 7 路红外 Watch 基本为常量，黑白变化不明显；小车上电后不走或只有电机电流声。
- 我的失误：在用户要求“直接以参考代码为基本”后，我把底盘骨架整体重写，连已经现场验证过的红外读取、电机 PWM、STBY 初始化和循迹主循环也一并替换。这样同时引入了多采样锁存、状态机、PWM 降速、强制转向等多个变量，导致现场现象无法快速定位。
- 正确做法：参考代码应拆解吸收，而不是整块替换。第一阶段必须保留已验证底层，只迁移参考代码的架构思想，例如编码器距离层、任务状态机、强制转弯保护、速度闭环。
- 修正：生成 V31 稳定底盘抢救验证版，恢复稳定基线底层，只保留红外、电机、蜂鸣器和 A 点无黑线桥接重捕线；暂时移除 OpenMV、舵机、ABCD 任务点和编码器距离层。
- 后续原则：当硬件链路出现“传感器不变/电机不动”时，先退到最小可验证底层程序，不应继续叠加任务策略。
## 2026-07-09 V45 到 V46：编码器控制命名与入线判定过于保守

- 失误点 1：把 V45 的无黑线桥接描述为“PI”不严谨。若以左右累计距离差为被控误差，则每帧左右编码器增量差实际对应 D 项；V45 更接近 PD + 静态 trim，而不是完整 PID。
- 影响：用户看到别人方案使用 PID 时，会误以为当前方案缺少成熟控制结构；后续调参也容易把速度差项当成普通比例项理解。
- 修正：V46 明确改为 PID：P 用累计左右里程差，I 用累计误差慢补偿，D 用每帧编码器增量差。
- 失误点 2：低估了“9 次采样多数判定”对短暂压线的过滤作用。红外模块灯有反应，并不等于 `g_line_detect_mask` 一定会变；高速桥接扫过黑线时，短暂低电平可能被多数判定滤掉，导致没有进入循迹。
- 修正：V46 新增 `g_line_black_pulse_mask` 和 `g_line_entry_mask`，用脉冲捕获负责状态切换，多数判定继续负责稳态循迹位置计算。
## 2026-07-09 V46 到 V47：黑线脉冲入口过敏导致假循迹

- 失误点：V46 为了解决“红外灯有反应但不进循迹”，直接把 `g_line_black_pulse_mask` OR 进 `g_line_entry_mask`。这个修复过于激进。
- 现场表现：白地运行后 PA15 LED 常亮，蜂鸣器一直响，小车仍不按真实黑线循迹。
- 正确解释：LED 常亮说明程序很可能已经进入 `PHASE_LINE_RUN`，但这是由白地噪声/瞬时低电平触发的假入线，不是真正重捕黑线。
- 修正：V47 将脉冲入口改为候选确认，最近 4 帧至少 2 帧出现才允许切入循迹；多数判定非零仍然立即有效。
- 后续原则：传感器“灯闪一下”不能直接等同于“进入循迹”，运动中必须区分短脉冲捕获、稳定多数判定和状态机切换。
## 2026-07-09 V47 到 V48：只防脉冲假入线，不足以防白底稳定假黑

- 失误点：V47 认为主要问题是“单次脉冲假入线”，因此只给 `g_line_black_pulse_mask` 加了候选确认；但仍保留了 `g_line_detect_mask != 0` 单帧直接入线。
- 现场反证：小车拿起来上电 LED 不常亮，放在白底上上电 LED 默认常亮。说明白底会让某些红外通道稳定进入“黑线”判定，不只是短脉冲。
- 正确修正：V48 在启动时记录白底假黑位 `g_line_start_ignore_mask`，后续所有入线/循迹/出线都使用过滤后的 `g_line_effective_detect_mask`。
- 后续原则：当场地白底本身能触发 DO 误判时，不能只调状态机帧数；必须把启动背景误判位从导航输入中剔除。
## 2026-07-10 V48 现场复核：仅凭状态 LED 推断白底假黑证据不足

- 失误点：上一轮根据“白底上电 PA15 LED 常亮、悬空 LED 不亮”推断白底存在稳定假黑，并据此加入启动假黑 mask。
- 新证据：白底上电时 7 个红外模块指示灯全部亮；真实黑线仅有 1~2 个模块灯熄灭；悬空才是 7 个模块灯全部熄灭。
- 修正认识：按已确认极性，白底全亮应为原始 `0x7F`、黑线 mask 为 `0`；白底本身未必假黑。PA15 现象与 V48 代码预期矛盾，必须先确认实际烧录版本、PA15 LED 身份和 MCU Watch 掩码，不能继续用 LED 现象代替 GPIO 数据。
- 新的硬件判据：真实赛道黑线通常只有 1~2 路低电平；7 路全低更符合悬空异常。后续代码应重新把 `0x7F` 从有效黑线中排除。
## 2026-07-10 V48 到 V49：模块指示灯不能代替 MCU Watch 判断极性

- 失误点：此前沿用“白色高电平、黑线低电平”的历史结论，并把 `SENSOR_HIGH_IS_WHITE` 设为 1；主要依据包括模块灯亮灭和早期测量。
- Watch 反证：白底 `raw=16`，S4 压黑后 `raw=24`，悬空 `raw=127`。S4 从白底到黑线时对应 bit 从 0 变 1，证明当前 MCU 输入是黑线高电平。
- 影响：白底被反相成 6 路黑线，程序直接进入假循迹，PA15 常亮并产生固定右偏；悬空反而被当作白底桥接。
- 修正：V49 设置 `SENSOR_HIGH_IS_WHITE=0`，并把 7 路全高/归一化全黑作为悬空异常处理。
- 后续原则：极性必须以 MCU Watch 的原始 GPIO mask 或万用表 DO 电压为准，不能以模块指示灯亮灭直接推导。
## 2026-07-10 硬件选型复盘：低估独立数字红外模块的一致性成本

- 失误点：早期方案优先沿用已购的 7 个独立数字红外模块，强调 GPIO 接入简单，但低估了逐路阈值、安装高度、供电噪声、连接可靠性和模块离散性带来的调试成本。
- 更优方案：若采购时间允许，应优先评估一体化 8 路灰度阵列，尤其是能输出连续灰度值或通过 I2C/UART 返回校准后数据的型号。
- 注意：标称“八路灰度”的产品可能仍只是 8 路 LM393 数字比较器；若只有 DO 输出，阈值问题仍然存在，只是机械一致性和布线有所改善。

## 2026-07-15：把“安全拉低”沿用到低电平触发蜂鸣器

- 失误点：V50 灰度隔离测试为了禁用旧蜂鸣器，把 PB11 初始化为 LOW；这只适用于此前高电平触发/两针直驱假设。
- 新硬件反证：用户找到的三针模块明确标注“低电平触发”，因此 PB11=LOW 会持续鸣叫，真正的关闭电平是 HIGH。
- 修正：V51 将 PB11 初始化为 HIGH；正式接线改为模块 `VCC->3.3V`、`I/O->PB11`、`GND->公共GND`，并建议 10kΩ 上拉防止复位误响。
- 后续原则：所有“安全输出状态”必须根据执行器的有效极性定义，不能默认 LOW 就代表关闭；蜂鸣器、继电器和使能模块都应显式定义 `ACTIVE_LOW/ACTIVE_HIGH`。

## 2026-07-15：误把LaunchPad J10/5V当作可靠的外部目标供电入口

- 失误点：此前接线文档写成 `TB6612 5V OUT -> LaunchPad 5V`，并据此认为脱离USB后目标MCU会由板载电路自动得到3.3V。
- 现场反证：USB连接时程序运行且灰度X6正常；USB断开时程序不启动、X6常亮。说明USB提供的不只是调试连接，而是XDS110经J101提供的目标3.3V。
- 官方依据：LP-MSPM0G3507用户指南SLAU873D第2.4节说明USB经XDS110/J101给目标侧3.3V；第2.5节明确外部电源从J11直接供给，并须满足MCU 1.62~3.6V范围。
- 修正：外部稳定3.3V接J11/3V3；与USB同时使用时拔掉J101的3V3跳帽，保留调试信号和公共地。J10/5V不再作为本项目脱离USB后的目标MCU供电方案。
- 后续原则：开发板电源脚不能仅凭丝印判断输入/输出和稳压路径，必须核对用户指南的电源框图、隔离跳帽和指定外部供电入口。

## 2026-07-16：低估无 USB 时 J101/NRST 对目标板的钳位

- 失误点：此前建议外部 3.3V 独立供电时只拔 J101 的 3V3 跳帽，并默认保留 NRST 不会影响目标运行。
- 现场反证：无 USB 时保留 NRST，PA15 不闪且电机不转；拔掉 NRST 跳帽后程序和电机立即启动。
- 根因：当前板上未供电的 XDS110 调试侧通过 NRST 连接影响目标复位线，使 MSPM0 一直处于复位或近似低电平钳位状态。
- 修正：本项目独立运行时同时拔掉 J101 的 3V3 与 NRST；调试时再恢复必要的 NRST/SWD 信号，3V3 跳帽仍保持断开。
- 后续原则：外部供电脱离板载调试器时，不仅检查电源并联，还要实测 NRST 电平；发现目标 VDD 正常但代码不启动，应优先隔离调试器复位路径。

## 2026-07-16：八路灰度位置误差与电机差速修正符号相反

- 失误点：V52/V53 将 X1~X8 权重定义为从左侧负误差到右侧正误差，却沿用了 `left=base-correction`、`right=base+correction` 的差速公式。
- 现场反证：灰度识别黑线后车辆轨迹确实改变，但无法沿线；逐行检查表明，正误差代表线在右侧时，原公式会降低左轮、提高右轮，使车辆继续向左修正，方向完全相反。
- 修正：V54 改为 `left=base+correction`、`right=base-correction`；线在右侧时左轮加速、右轮减速，线在左侧时反向处理。
- 后续原则：传感器位序、误差符号和执行器响应必须组成可手算的闭环：任选最左/最右传感器，明确期望转向并逐项验证左右轮命令，不能只凭历史公式直接移植。

## 2026-07-16：未先确认活动 empty.c 已被用户回退

- 失误点：收到“用能运行代码与近期代码取速度均值”后，初步按活动文件仍为V55进行推断。
- 工具核对：复制后的源码头和参数实际为V53，说明用户已把活动 `empty.c` 恢复为能运行版本。
- 修正：放弃从V55继续修改，V56改为直接以当前V53为基底，仅替换速度参数并重新编译。
- 后续原则：用户提到“这个代码”或手动回退后，修改前必须读取活动文件版本号和关键常量，不能依赖上一轮助手保存的状态。

## 2026-07-16：恢复V53速度基底时重新引入已确认的循迹符号错误

- 失误点：为满足“使用能运行的V53并只调整速度”，V56/V57完整沿用了V53控制结构，但没有阻止此前已确认的左右轮修正符号错误重新进入活动代码。
- 现场反证：V57碰到黑线后转向完全相反，而且旧版急弯限幅在当前速度下修正过强。
- 修正：下一版保留V57可起转速度，单独把差速公式改为右侧黑线提高左轮、降低右轮，并同步降低普通和急弯修正强度。
- 后续原则：用户要求“只改参数”时仍必须保留已经确认的安全/正确性修复；不能为了恢复某个能运行的历史版本而无提示地恢复已知缺陷。

## 2026-07-17：依据模块丝印把WHO_AM_I固定为0x68

- 失误点：看到GY-521/MPU-6050板型后，V60只接受WHO_AM_I=0x68，没有考虑同板型可能使用MPU6500兼容芯片或替代料。
- 现场反证：I2C错误计数为0且WHO_AM_I稳定读取为0x70，证明总线正常，实际芯片身份不是0x68。
- 修正：接受0x68与0x70并记录设备类型；继续使用两者兼容的PWR_MGMT_1、GYRO_CONFIG和GYRO_XOUT寄存器。
- 后续原则：模块丝印只表示板型或销售名称，芯片身份必须以WHO_AM_I实测为准；身份不符但总线无错误时，先核对兼容型号，不能直接归因于接线。
## 2026-07-17：把 PA15 不亮过早归因于 MPU/I2C 卡死

- 当时依据：V64 的首次 PA15 启动提示位于 MPU 初始化之后，断开 MPU 后 PA15 仍不亮。
- 后续证据：CCS Watch 显示 `g_mpu_state=4`、`g_mpu_error=1`、`g_i2c_error_count=1`，证明程序已经完成 I2C 超时并进入降级分支。
- 纠正：PA15 不亮只能说明物理引脚未观察到翻转，不能证明 CPU 停在首次灯光提示之前；应先暂停 CPU，读取 PC/Call Stack、`g_phase`、`g_stop_reason` 与 `g_led_state`，再判断控制流。
## 2026-07-17：未优先核对 CCS 实际选中的工程与正在编辑的源码

- 错误路径：看到 PA15 不闪后，连续从供电、NRST、MPU/I2C 和固件控制流排查，却没有第一时间确认调试下拉框对应的工程与编辑器文件是否属于同一项目。
- 确认证据：工作区中 `ele-car\empty.c` 是2026-07-17的V64，而可正常调试的 `empty_LP...\main.c` 是2026-07-10的V48，两份 `.out` 哈希和时间均不同。
- 改进规则：每次编译/调试前同时核对“编辑器路径、Debug下拉项目名、输出 `.out` 路径、固件版本变量”四项；工作区存在多工程时不得仅凭当前打开的源文件判断实际下载内容。
## 2026-07-17：直接要求 Watch 一个可能被链接器删除的版本变量

- 问题：`g_firmware_version`虽在源码中定义为volatile全局，但未被程序引用，最终map和符号表中不存在；Watch显示的539000832实际是`0x20208000`栈末地址。
- 改进：要求Watch前先用map/nm确认符号进入最终`.out`；版本标记必须被主程序显式读取/写入，或使用编译器与链接器都支持的retain机制。
## 2026-07-17：把“当前程序不工作”主要归因于 CCS 调试配置

- 错误：双工程确实造成了源码/产物错位风险，但新增干净配置成功启动V64后底盘仍不工作，说明它不是当前停车的主要原因。
- 新证据：旧V48启动后无条件鸣叫并进入桥接驱动；V64静音，并要求八路白底baseline mask只能是`0x00/0xFF`，否则永久停车。近期X6又确实发生高度相关异常。
- 改进：区分“能否成功加载程序”和“程序是否允许执行器启动”。工程/调试链路用专有符号和会话状态验证；执行器问题必须逐项审计软件门禁、phase和stop_reason。
## 2026-07-17：首次灰度降级设计允许任意6路启动

- 初版问题：只要求8路中6路稳定，未约束中心X4/X5，也未拒绝“所有可用通道同时变化”。这可能让中心双通道失效的车辆开环前进，或把6路同时变化误判为误差0的居中线。
- 修正：至少7路稳定，X4/X5必须同时稳定；运行时屏蔽唯一不稳定通道，并显式将`changed_mask == stable_mask`判为异常。
- 固化规则：传感器降级不能只看可用数量，必须同时保护几何覆盖、全量异常判定和下游算法原有阈值不变量。
## 2026-07-17：灰度板接入时只强调测量OUT电平，未强制安装电平转换

- 问题：接线记录曾提示“若OUT接近5V则使用10k/20k分压”，但实际工程仍允许5V灰度OUT直接连接PA7，未把电平转换列为不可省略的硬件门禁。
- 后果：普通PA7在3.3V供电时输入上限为`VDD+0.3V`；灰度板先上电时通过GPIO钳位二极管反向抬高MCU电源轨，造成NRST、PA15、X6和独立供电状态异常，并存在永久损伤风险。
- 改进：所有跨电源域数字线在接线表中必须同时标注电压、方向、是否5V容忍、限流/电平转换器件和断电状态；未确认电平兼容前不得直连。
## 2026-07-17：把出弯反向修正强度等同于单一CORR参数

- `TURN_EXIT_BRAKE_CORR_TICKS=0`只关闭了制动状态中的差速幅度，并未关闭制动状态、最短持续帧和结束后的30帧MPU航向保持。
- 调参规则：参数降至0仍有同方向效果时，停止继续跨零；沿控制链检查持续时间、后续状态和并行控制项。负值代表反向控制，不代表更弱控制。

## 2026-07-17：新增航向修正时未先封闭状态接管边界

- 初版风险：5度右修正只考虑了目标角闭环，却允许前级制动超时后继续触发，也可能在灰度已经重捕黑线时继续覆盖循迹；MPU不可用时还可能用零差速占用原丢线恢复。
- 修正：只有前级制动因角速度达到阈值而正常结束时才启动；任意有效黑线立即取消右修正并在同一帧交还灰度循迹；MPU初始化或运行失败直接退化为原V64线控。
- 固化规则：给车辆增加短时姿态动作时，必须同时定义进入条件、传感器优先级、退出条件、超时路径和硬件失效降级，不能只验证正常路径上的控制公式。

## 2026-07-17：固定方向角度补偿仍可能与丢线找回串联

- V66虽然把5度右偏限制为30帧，并允许黑线重捕立即取消，但右偏动作本身可能先把车辆带离灰度覆盖区；状态结束后若仍保留旧转弯误差，丢线找回会继续同方向控制，形成“有限动作串联成持续打转”。
- V67归因修正：先关闭独立右偏，并在出弯制动所有结束路径统一清零旧非零误差。只有实车证明不再打转后，才重新设计带重入锁和更短时间上限的方向补偿。
- 固化规则：检查状态的单次持续时间还不够，还必须检查退出后的下一状态使用了哪些历史量；历史误差、积分量和方向锁存都可能把有限动作延长成持续动作。

## 2026-07-17：隔离5度右偏时同时删除了原有直行保持

- V67为了确认持续右转是否来自V66固定5度右偏，除了关闭右偏，还把`g_turn_exit_hold_count`设为0；这不是严格的单变量回退。
- 现场反证：截图V64出弯后基本直行，而V67开始向右。对比确认V64在出弯结束后设置当前航向目标并保持30帧，该闭环正是抵消底盘固定右偏的关键。
- 修正：V68回到V64结构，保留30帧航向保持，只把出弯确认从单帧全灭改为严格连续3帧全灭。
- 固化规则：做回归隔离时必须列出被修改状态的全部副作用；关闭一个新动作不能顺带删除旧版本已经实车验证有效的稳定环节。

## 2026-07-17：把“无有效线”直接等同于“所有通道全灭”

- 初版V68复用了`g_gray_line_valid==0`/`g_line_lost_count`做三帧确认，但无有效线既可能是0路看到黑线，也可能是7~8路同时变化的异常输入。
- 修正：出弯候选只在`g_gray_changed_count==0`时累计；任意非零输入都取消候选，防止全黑或扫描异常被误判为连续全灭。
- 固化规则：状态变量若合并了多个无效原因，不能直接用于需要明确物理语义的判定；“无效”“全灭”“全黑”“异常”必须分别表达。

## 2026-07-17：接近收敛时坚持最小差速步长

- V68只剩极轻微右偏时，不再调整出弯状态机、MPU保持时间或整套PID；这些参数影响范围远大于现象。
- V69保持平均PWM不变，仅将左/右基础值从`428/428`改为`427/429`，等效-1 tick左修正。
- 固化规则：实车只剩微小稳定偏差时，优先使用最小可分辨的静态trim，每版只移动1 tick并做多轮同条件验证，防止再次跨过最佳点。

## 2026-07-17：直接移植旧版GPIO中断函数名

- V70初版从历史编码器代码移植了`GPIOB_IRQHandler`，但当前MSPM0G3507启动文件把GPIOB IRQ1向量绑定到`GROUP1_IRQHandler`。编译链接仍会成功，却会在首个编码器边沿进入无限循环的`Default_Handler`。
- 修正：处理函数改为`GROUP1_IRQHandler`，并用最终map核对它与`Default_Handler`地址不同，不能只依赖编译成功。
- 固化规则：移植任何ISR时必须同时核对当前芯片启动文件、NVIC IRQ号和最终map符号；“函数能编译”不等于“中断向量会调用它”。

## 2026-07-17：把“编码器不写PWM”误当成“编码器采集不影响控制”

- V70设计时认为编码器只记录、不参与PWM，因此不会改变车辆行为；但忽略了A相双边沿GPIO ISR会抢占主循环，改变实际帧周期。
- 当前控制的启动、出弯确认、航向保持和MPU积分都依赖固定20ms假设，没有用硬件时间戳。即使日志不写控制变量，改变调度时序也会改变控制结果。
- 现场后果是进弯位置后移、出弯转过头和整车右偏，V70无法完成一圈。已回退到V71纯V69控制基线。
- 固化规则：实时控制系统中的“观察代码”也必须计入中断频率、最坏执行时间和采样抖动；加入高频采集前先测控制周期，或使用硬件计数器/DMA，并让控制循环由硬件定时器固定触发。

## 2026-07-17：把中心压线时的角速度阻尼同时用于直线和弯道

- 原逻辑只要X4/X5中心锁定就启用MPU角速度阻尼，未区分车辆处于直线还是40cm半径半圆。顺时针右弯角速度为负，阻尼会产生左向修正并抑制正确转弯。
- 现场表现是车辆先沿切线向左越过黑线，待X5/X6误差增大后再向右扳回，形成单侧摆动并改变出弯位置。
- V72修正为curve中禁用直线阻尼并加入受限右弯前馈，gap/直线才使用航向闭环。
- 固化规则：同一个“传感器居中”观测不能跨不同道路曲率共用同一控制含义；状态估计必须包含直线/弯道上下文。

## 2026-07-17：全灭确认帧数同时承担防抖和转向延续

- V71中全灭后的前4帧仍按最后非零误差继续急弯，第5帧才出弯。因此把确认从3改到5不仅加强防抖，也额外增加约40ms同方向转向。
- V72把职责拆开：5帧只防抖；局部角不足165度时由小幅曲率前馈继续右转，达到165度后立即清除旧误差，最终由180度航向目标决定出口。
- 固化规则：防抖计数不得隐式延长执行器动作；状态确认时间与运动目标必须分别控制。
## 2026-07-18：把“代码包含MPU”误当成“实车已验证MPU控制”

- 风险：MPU任一根VCC/GND/SDA/SCL脱落时，程序会把`g_mpu_link_ok`置0并自动退化为线控；车辆能运行不代表MPU融合分支执行过。
- 现场证据：补回掉线后车辆行为整体突变，说明此前稳定表现很可能来自降级路径。
- 规则：任何带可选传感器降级功能的实车测试，都必须同时记录链路在线标志、设备身份、错误计数和关键控制输出；否则不得宣称融合算法通过实车验证。
- 排障时先做物理供电/总线与控制分支隔离，再调PID。特别要区分`PA0/PA1`的I2C与`PB0/PB1`的TB6612左电机方向脚。
## 2026-07-18：跨电源域信号不能只检查运行电压

- 3.3V GPIO驱动5V模块输入在双方均上电时可能安全，但任一侧未上电时，信号会通过输入保护二极管给对方电源轨倒灌。
- OUT分压只能限制正常高电平，不能替代正确电源时序、公共地、热插拔禁令和带`Ioff`的电平转换器。
- 新硬件必须按“电源独立验证 -> 信号离线测量 -> 限流/分压 -> MCU输入 -> 执行器负载”的顺序接入，不能一次接齐后再排障。
## 2026-07-18：根据“数字输入通常高阻”错误允许省略AD隔离

- 先前判断只依据一般CMOS输入模型，认为5V模块的AD0/AD1/AD2由3.3V MCU直接驱动时不会反向供电，并允许省略串联保护。
- 实物反证非常明确：连接AD0使3.3V轨升至4.1V，断开即恢复。实测电源域行为优先级高于器件类别假设。
- 修正规则：未知模块的任何跨电源域引脚都必须先在悬空状态测静态电压和源电流；发现对端引脚自行出现高于MCU VDD的电压时，禁止直连，串联电阻仅能限流，正式方案必须使用具有隔离/电平转换能力的缓冲器或晶体管级。
## 2026-07-20：未先用断电连续性验证实物针序就建议地址输入接地

- 逻辑依据“AD0应为高阻输入”本身成立，但实物接口可能因背面观察、连接器镜像、线束颜色复用或板损坏而不再符合标签假设。
- 现场将所谓AD0接地后出现大电流短路，证明在未知模块上任何接地/上拉实验前都必须先断电测量端子对VCC/GND的阻值，并核对同一视角丝印。
- 新规则：出现导线升温、灯光整体熄灭或电源跌落时立即定性为硬短路，停止上电；不得继续软件调试、重复插拔或依赖限流电阻掩盖针序错误。
## 2026-07-20：把异常板实测倒灌过早推广为地址接口的通用特性

- 先前根据连接所谓AD0后3.3V轨升高，推断5V灰度板地址线普遍必须使用74HCT125隔离。
- 官方《数据读取》明确给出MSPM0G3507的AD0/AD1/AD2直连接法，且模块内部地址端属于CD4051控制输入；正常模块并不应在AD0上向MCU提供5V源电流。
- 修正：异常实测仍有效，但它证明的是当前实物针脚、线束或模块不正常，不能直接外推为所有同型号板的接口要求。74HCT125可作为保护增强项，必须在针序和板状态确认后再决定。
- 固化规则：实物观测与官方原理冲突时，先分离“器件通用设计”和“当前样品故障”。先做断电连续性、阻值、端子视角和独立供电验证，再调整通用接线结论。
## 2026-07-20：未把不同电源的上下电时序列为灰度模块首要风险

- 灰度板5V、MSPM0 3.3V由不同降压模块或USB供电，曾出现未共地、单边上电和带电插拔。此时OUT与地址线可能通过两侧保护二极管成为非设计回流路径。
- TI CD4051B明确提示分离电源驱动VDD和信号时要避免上下电造成持续钳位电流；MSPM0普通GPIO允许的注入电流仅±2mA。现场3.3V轨被抬至4.35V已经证明保护路径发生大电流导通。
- 旧板最终测得AD0-OUT永久短路，说明故障已经从逻辑不稳定发展为器件内部击穿。软件阈值、采样延时和重新烧录均不可能修复。
- 固化规则：多电源系统必须先建立永久公共地和明确上电顺序；信号接入按断电阻值、离线电压、限流、逻辑验证逐级进行。禁止模块带电时插拔信号线，也禁止让未上电MCU承受已上电5V模块输出。

## 2026-07-21：把所有curve状态全灭都当成弯中意外丢线

- V83根据上一组“弯中向外滑线”视频，在curve有效时把任意全灭误差强制为`+1800`。该修复对弯中丢线有效，却忽略固定赛道弧线末端也必然全灭，导致正常出弯瞬间输出最大右转。
- 同一个传感器事件必须结合路径阶段解释：弯道前半段全灭是故障恢复信号，完整运行弧线后的全灭可能是合法拓扑边界。只看当前mask无法区分。
- 固化规则：固定赛道的线端、缺口和任务点必须加入阶段、里程/时长与历史姿态门控；故障恢复控制不得无条件覆盖合法状态转换。新视频必须与旧视频逐帧比较，不能因为上一次根因成立就直接复用到下一次现象。

## 2026-07-21：用未经标定的成熟门槛掩盖控制输出突变

- V84试图用curve持续280帧和历史误差不超过1800识别自然出弯，但实车现象完全不变，证明门槛没有命中。未知实际帧数时继续调门槛，只是在状态分类上反复猜测。
- 更直接的根因是执行器目标不连续：有效线最后一帧可能只有中等修正，全灭下一帧却无条件跳到约+312。无论事件分类是否正确，这种目标跃迁本身都会造成猛拐。
- 固化规则：状态判定不确定时，先保证控制输出连续、有上限、可衰减。故障恢复不得比故障前实际控制更激进，除非有独立传感器证据证明必须加大动作。

## 2026-07-21：数字灰度P控制不能只限幅而不限制变化率

- 八路数字灰度位置是离散量。车辆带角度压线时，mask会快速跨通道，P输出即使幅值受限，也可能在相邻帧改变符号或从普通修正跳到急弯修正，形成左右摆动。
- 仅减小Kp会同时削弱真正急弯能力；更合理的是分离“目标修正”和“实际执行修正”：目标保留足够幅度，执行端经过低通、斜率限制和跨零约束。
- 固化规则：带机械惯性的执行器必须同时检查输出幅值、变化率和方向切换连续性。滤波状态必须与丢线、制动等旁路实际输出同步，否则重回主控制时会从旧状态再次产生跳变。
