jlg006728/electronic-design-contest/参考代码/校赛_2026-06-29/24H题第四问开源/24H题第四问代码开源-CTY/FunctionalModule/MotorsCtrl.h

#ifndef __MotorsCtrl_H
#define __MotorsCtrl_H

#include "headfile.h"

void MotorInit (Motors_t** Motors);
void MotorPidCtrl (Motors_t* Motors,fp32 TurnAngleSet,fp32 AverageSpeedSet);
void MotorDataUpdate (Motors_t* Motors);
void MotorStop(Motors_t* Motors);

#endif
