jlg006728/electronic-design-contest/参考代码/校赛_2026-06-29/25E题底盘开源/25E题底盘国一开源/FunctionalModule/Encoder.h

#ifndef __Encoder_H
#define __Encoder_H

#include "headfile.h"

void EncodersInit(Motors_t* Motors);
void EncoderDataUpdate(Motors_t* Motors);
float EncoderTotalLengthGet(Motors_t* Motors);
float EncoderDeltaLengthGet(Motors_t* Motors);
void EncoderLengthClear(Motors_t* Motors);
	
#endif
