jlg006728/electronic-design-contest/参考代码/校赛_2026-06-29/24H题第四问开源/24H题第四问代码开源-CTY/FunctionalModule/GraySensor.h

#ifndef __GraySensor_H
#define __GraySensor_H

#include "headfile.h"

void GraySensorInit(GraySensor_t** GsSensor);
void GraySensorDataUpdate (GraySensor_t* GraySensor);
float GraySensorToTurnAngle(GraySensor_t* GraySensor);
#endif
