jlg006728/electronic-design-contest/参考代码/校赛_2026-06-29/24H题第四问开源/24H题第四问代码开源-CTY/FunctionalModule/OledFont.h

#ifndef __OLEDFONT_H
#define __OLEDFONT_H 	   
//常用ASCII表
//偏移量32
//ASCII字符集
//偏移量32
//大小:12*6
/************************************6*8的点阵************************************/
const unsigned char F6x8[][6] =		
{
0x00, 0x00, 0x00, 0x00, 0x00, 0x00,// sp
0x00, 0x00, 0x00, 0x2f, 0x00, 0x00,// !
0x00, 0x00, 0x07, 0x00, 0x07, 0x00,// "
0x00, 0x14, 0x7f, 0x14, 0x7f, 0x14,// #
0x00, 0x24, 0x2a, 0x7f, 0x2a, 0x12,// $
0x00, 0x62, 0x64, 0x08, 0x13, 0x23,// %
0x00, 0x36, 0x49, 0x55, 0x22, 0x50,// &
0x00, 0x00, 0x05, 0x03, 0x00, 0x00,// '
0x00, 0x00, 0x1c, 0x22, 0x41, 0x00,// (
0x00, 0x00, 0x41, 0x22, 0x1c, 0x00,// )
0x00, 0x14, 0x08, 0x3E, 0x08, 0x14,// *
0x00, 0x08, 0x08, 0x3E, 0x08, 0x08,// +
0x00, 0x00, 0x00, 0xA0, 0x60, 0x00,// ,
0x00, 0x08, 0x08, 0x08, 0x08, 0x08,// -
0x00, 0x00, 0x60, 0x60, 0x00, 0x00,// .
0x00, 0x20, 0x10, 0x08, 0x04, 0x02,// /
0x00, 0x3E, 0x51, 0x49, 0x45, 0x3E,// 0
0x00, 0x00, 0x42, 0x7F, 0x40, 0x00,// 1
0x00, 0x42, 0x61, 0x51, 0x49, 0x46,// 2
0x00, 0x21, 0x41, 0x45, 0x4B, 0x31,// 3
0x00, 0x18, 0x14, 0x12, 0x7F, 0x10,// 4
0x00, 0x27, 0x45, 0x45, 0x45, 0x39,// 5
0x00, 0x3C, 0x4A, 0x49, 0x49, 0x30,// 6
0x00, 0x01, 0x71, 0x09, 0x05, 0x03,// 7
0x00, 0x36, 0x49, 0x49, 0x49, 0x36,// 8
0x00, 0x06, 0x49, 0x49, 0x29, 0x1E,// 9
0x00, 0x00, 0x36, 0x36, 0x00, 0x00,// :
0x00, 0x00, 0x56, 0x36, 0x00, 0x00,// ;
0x00, 0x08, 0x14, 0x22, 0x41, 0x00,// <
0x00, 0x14, 0x14, 0x14, 0x14, 0x14,// =
0x00, 0x00, 0x41, 0x22, 0x14, 0x08,// >
0x00, 0x02, 0x01, 0x51, 0x09, 0x06,// ?
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
  0x08,0xF8,0x08,0x00,0x00,0x08,0xF8,0x08,0x20,0x3F,0x21,0x01,0x01,0x21,0x3F,0x20,//H 40
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
};
char Hzk[][16]={
{0x00,0x02,0x0C,0xE0,0x00,0xCF,0x94,0x92,0x98,0x22,0x2A,0xF2,0x2A,0xE6,0x00,0x00},
{0x04,0x04,0x7F,0x00,0x45,0x34,0x0F,0x94,0x64,0x1F,0x20,0x7F,0x44,0x44,0x40,0x00},/*"凝",0*/
{0x04,0x04,0xFC,0x45,0x46,0x24,0x24,0x04,0x80,0x7E,0x2A,0xAA,0x2A,0xFE,0x00,0x00},
{0x80,0x82,0x92,0x92,0x92,0x92,0x92,0xFF,0x92,0x92,0x92,0x92,0x93,0x82,0x80,0x00},/*"望",1*/
{0x04,0x04,0x84,0xE4,0x1C,0x04,0x05,0xC6,0x3C,0xA4,0x24,0x24,0xE4,0x04,0x04,0x00},
{0x02,0x01,0x00,0xFF,0x00,0x82,0x81,0x46,0x28,0x10,0x29,0x46,0x41,0x80,0x80,0x00},/*"夜",2*/
{0x10,0x0C,0x44,0x24,0x14,0x04,0x05,0x06,0x04,0x04,0x14,0x24,0x44,0x14,0x0C,0x00},
{0x00,0x40,0x40,0x41,0x41,0x41,0x41,0x7F,0x41,0x41,0x41,0x41,0x40,0x40,0x00,0x00},/*"空",3*/
{0x00,0xF8,0x0C,0x0B,0x08,0x08,0xF8,0x40,0x30,0x8F,0x08,0x08,0x08,0xF8,0x00,0x00},
{0x00,0x7F,0x21,0x21,0x21,0x21,0x7F,0x00,0x00,0x00,0x43,0x80,0x40,0x3F,0x00,0x00},/*"的",4*/
{0x00,0x00,0x80,0x00,0x00,0xE0,0x02,0x04,0x18,0x00,0x00,0x00,0x40,0x80,0x00,0x00},
{0x10,0x0C,0x03,0x00,0x00,0x3F,0x40,0x40,0x40,0x40,0x40,0x78,0x00,0x01,0x0E,0x00},/*"心",5*/
};

#endif
