jlg006728/electronic-design-contest/参考代码/校赛_2026-06-29/24H题第四问开源/24H题第四问代码开源-CTY/HardwareDriver/Binary.h

#ifndef _BINARY_H_
#define _BINARY_H_


#define B00000000  0x00
#define B00000001  0x01
#define B00000010  0x02
#define B00000011  0x03
#define B00000100  0x04
#define B00000101  0x05
#define B00000110  0x06
#define B00000111  0x07
#define B00001000  0x08
#define B00001001  0x09
#define B00001010  0x0a
#define B00001011  0x0b
#define B00001100  0x0c
#define B00001101  0x0d
#define B00001110  0x0e
#define B00001111  0x0f
#define B00010000  0x10
#define B00010001  0x11
#define B00010010  0x12
#define B00010011  0x13
#define B00010100  0x14
#define B00010101  0x15
#define B00010110  0x16
#define B00010111  0x17
#define B00011000  0x18
#define B00011001  0x19
#define B00011010  0x1a
#define B00011011  0x1b
#define B00011100  0x1c
#define B00011101  0x1d
#define B00011110  0x1e
#define B00011111  0x1f
#define B00100000  0x20
#define B00100001  0x21
#define B00100010  0x22
#define B00100011  0x23
#define B00100100  0x24
#define B00100101  0x25
#define B00100110  0x26
#define B00100111  0x27
#define B00101000  0x28
#define B00101001  0x29
#define B00101010  0x2a
#define B00101011  0x2b
#define B00101100  0x2c
#define B00101101  0x2d
#define B00101110  0x2e
#define B00101111  0x2f
#define B00110000  0x30
#define B00110001  0x31
#define B00110010  0x32
#define B00110011  0x33
#define B00110100  0x34
#define B00110101  0x35
#define B00110110  0x36
#define B00110111  0x37
#define B00111000  0x38
#define B00111001  0x39
#define B00111010  0x3a
#define B00111011  0x3b
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
#define B11101100  0xec
#define B11101101  0xed
#define B11101110  0xee
#define B11101111  0xef
#define B11110000  0xf0
#define B11110001  0xf1
#define B11110010  0xf2
#define B11110011  0xf3
#define B11110100  0xf4
#define B11110101  0xf5
#define B11110110  0xf6
#define B11110111  0xf7
#define B11111000  0xf8
#define B11111001  0xf9
#define B11111010  0xfa
#define B11111011  0xfb
#define B11111100  0xfc
#define B11111101  0xfd
#define B11111110  0xfe
#define B11111111  0xff

#endif
