jlg006728/electronic-design-contest/参考代码/校赛_2026-06-29/24H题第四问开源/24H题第四问代码开源-CTY/HardwareDriver/Bmp.h

/**************************************************
//
//PCtoLCD2002图片取模设置：
//阴码、逐列式、顺向（高位在前）
//输出格式：C51
//数组第一个元素最高位为图片左上角
//
*************************************************/

#include "binary.h"

#ifndef _BMP_H_
#define _BMP_H_



const u8 PIG1[] = {
	B00000000,B00000000,B00000000,B00000000,
	B00000000,B00000000,B00000000,B00000000,
	B00000000,B00000000,B00000000,B00000000,
	B00000000,B00000000,B00000000,B00000000,
	B00001111,B00111111,B11100000,B00000000,
	B00010000,B11100000,B00011000,B00000000,
	B00010000,B11000000,B00001000,B00000000,
	B00100000,B10000000,B00001100,B00000000,
	B01000001,B00000000,B00000110,B00000000,
	B01100001,B00011100,B00000010,B00000000,
	B00110010,B00010100,B00000001,B00000000,
	B00011110,B00011100,B01110001,B00000000,
	B00000100,B00000000,B10001001,B10000000,
	B00000100,B00000000,B10101000,B10000000,
	B00000100,B00000000,B10001000,B10000000,
	B00000100,B00000000,B10101000,B10000000,
	B00000110,B00011100,B10001000,B10000000,
	B00000010,B00010100,B01110000,B10000000,
	B00000001,B00011100,B00000001,B10000000,
	B00001111,B10000000,B00000001,B00000000,
	B00110000,B10000000,B00000010,B00000000,
	B00110000,B11000000,B00000110,B00000000,
	B00010000,B01000000,B00001100,B00000000,
	B00010000,B00110000,B01111000,B00000000,
	B00001000,B00011111,B11000000,B00000000,
	B00001100,B00110000,B00000000,B00000000,
	B00000111,B11000000,B00000000,B00000000,
	B00000000,B00000000,B00000000,B00000000,
	B00000000,B00000000,B00000000,B00000000,
	B00000000,B00000000,B00000000,B00000000
};

const u8 PIG2[] = {
	0x00,0x00,0x00,0x00,0x00,0x00,0x00,0x00,0x00,0x30,0x00,0x00,0x01,0xFC,0x7F,0xE0,
	0x03,0x07,0xC0,0xB0,0x06,0x0C,0x00,0x10,0x7C,0x38,0x00,0x18,0x40,0x60,0x00,0x08,
	0x40,0xC6,0x00,0x08,0x41,0x9E,0x1F,0x88,0x61,0x1F,0x30,0x8C,0x3F,0x11,0xA0,0xC4,
	0x05,0x1F,0x24,0x44,0x01,0x00,0x20,0x44,0x01,0x00,0x30,0x64,0x01,0x80,0x12,0x2C,
	0x00,0x80,0x18,0x28,0x00,0x9E,0x0C,0x28,0x00,0xD3,0x04,0x28,0x1F,0xDF,0x07,0xE8,
	0x30,0xC6,0x00,0x08,0x40,0x60,0x00,0x08,0x40,0x20,0x00,0x08,0x30,0x30,0x00,0x18,
	0x18,0x0C,0x00,0x30,0x0F,0xC6,0x01,0xC0,0x00,0x73,0xFF,0x00,0x00,0x1E,0x00,0x00,
	0x00,0x00,0x00,0x00,0x00,0x00,0x00,0x00
};

#endif
