jlg006728/electronic-design-contest/参考代码/校赛_2026-06-29/24H题第四问开源/24H题第四问代码开源-CTY/HardwareDriver/MyMath.h

#ifndef _MYMATH_H_
#define _MYMATH_H_

#include "headfile.h"

float MYMATH_Pow(float a, u8 b);
float MYMATH_Sin(float ang);	//正弦函数
float MYMATH_Cos(float ang);	//余弦函数
float MYMATH_arcSin(float value);	//反正弦函数
float MYMATH_arcCos(float value);	//反余弦函数


#endif
