jlg006728/electronic-design-contest/参考代码/校赛_2026-06-29/24H题第四问开源/24H题第四问代码开源-CTY/HardwareDriver/System.h

#ifndef __system_H
#define __system_H

#include "datatype.h"

void SystickInit(void);

uint32_t micros(void);
uint32_t millis(void);
void Delay_Ms(uint32_t x);
void delay_ms(uint32_t x);
void delay_us(uint32_t x);
void Delay_Us(uint32_t x);

float get_systime_ms(void);
uint32_t get_systick_ms(void);

#endif
