jlg006728/electronic-design-contest/参考代码/校赛_2026-06-29/25E题底盘开源/25E题底盘国一开源/FunctionalModule/Buzzer.h

#ifndef __Buzzer_H
#define __Buzzer_H

#include "headfile.h"

void BuzzerInit(Buzzer_t** Buzzer);
void BuzzerDataUpdate(Buzzer_t* Buzzer);
void BuzzerBee(Buzzer_t* Buzzer,uint8_t BuzzerBeeTimes);
#endif
