jlg006728/electronic-design-contest/ccs_project/integration_test/20260717_171841_v67_disable_right_bias_spin_guard.c

/*
 * V67 MSPM0G3507 + turn-exit right-spin regression guard.
 *
 * Wiring:
 *   PB5 -> AD0, PB6 -> AD1, PB7 -> AD2, PA7 <- OUT.
 *
 * Scope:
 *   The grayscale array, TB6612 motors and MPU gyro are active.
 *   OpenMV, servos, encoder control and mission logic remain disabled.
 *   The low-trigger buzzer module is held HIGH (silent).
 *   OpenMV UART is not initialized.
 *
 * Startup:
 *   Place X1..X8 on the same white background before reset. The first
 *   50 scans establish a white reference without assuming OUT polarity.
 */

#include <stdbool.h>
#include <stdint.h>
#include "ti_msp_dl_config.h"

#define NOINLINE                         __attribute__((noinline))

#define FIRMWARE_VERSION                 67U
#define GRAY_CHANNEL_COUNT               8U
#define GRAY_SAMPLE_COUNT                9U
#define GRAY_HIGH_MAJORITY               5U
#define GRAY_ADDRESS_SETTLE_US           40U
#define GRAY_SAMPLE_INTERVAL_US          10U
#define GRAY_BASELINE_SCAN_COUNT         50U
#define GRAY_MAIN_LOOP_MS                20U
#define GRAY_POWERUP_DELAY_MS            300U
#define DELAY_LOOPS_PER_US               8U

#define PHASE_INIT                       0U
#define PHASE_CALIBRATION                1U
#define PHASE_LINE_RUN                   2U
#define PHASE_COMPLETE                   3U
#define PHASE_STOP                       4U
#define PHASE_START_BRIDGE               8U

#define STOP_REASON_NONE                 0U
#define STOP_REASON_TEST_COMPLETE        1U
#define STOP_REASON_BASELINE_INVALID     2U
#define STOP_REASON_BRIDGE_TIMEOUT       3U
#define STOP_REASON_LINE_LOST_TIMEOUT    4U

#define PWM_TIMER                        TIMG0
#define PWM_PERIOD                       1600U
#define PWM_LEFT_BASE_TICKS              428U
#define PWM_RIGHT_BASE_TICKS             428U
#define PWM_MIN_TICKS                    250U
#define PWM_MAX_TICKS                    657U
#define START_BOOST_LEFT_TICKS           566U
#define START_BOOST_RIGHT_TICKS          566U
#define START_BOOST_FRAMES               20U
#define LINE_KP_DIVISOR                  36
#define LINE_CORR_LIMIT                  70
#define LINE_SHARP_ERROR                 1800
#define LINE_SHARP_KP_DIVISOR            14
#define LINE_SHARP_CORR_LIMIT            180
#define LINE_CENTER_MASK                 0x18U
#define LINE_CENTER_ERROR_MAX            600
#define LINE_CENTER_CONFIRM_FRAMES       2U
#define LINE_LOST_STRONG_FRAMES          10U
#define LINE_LOST_MEDIUM_FRAMES          25U
#define LINE_LOST_MEDIUM_CORR_LIMIT      100
#define LINE_LOST_LONG_CORR_LIMIT        45
#define LINE_MAX_ACTIVE                  6U
#define LINE_ENTRY_CONFIRM_FRAMES        2U
#define START_BRIDGE_MAX_FRAMES          250U
#define LINE_LOST_MAX_FRAMES             100U
#define RUN_MAX_FRAMES                   1500U
#define START_READY_HOLD_MS              800U

#define MPU_I2C                          I2C0
#define MPU_I2C_ADDRESS                  0x68U
#define MPU_I2C_TIMEOUT                  200000U
#define MPU_I2C_TIMER_PERIOD_100KHZ      31U
#define MPU6050_WHO_AM_I                 0x68U
#define MPU6500_WHO_AM_I                 0x70U
#define MPU_REG_SMPLRT_DIV               0x19U
#define MPU_REG_CONFIG                   0x1AU
#define MPU_REG_GYRO_CONFIG              0x1BU
#define MPU_REG_GYRO_XOUT_H              0x43U
#define MPU_REG_PWR_MGMT_1               0x6BU
#define MPU_REG_WHO_AM_I                 0x75U
#define MPU_GYRO_FS_500DPS               0x08U
#define MPU_CALIBRATION_SAMPLES          500U

#define TURN_EXIT_HOLD_FRAMES            30U
#define TURN_EXIT_RIGHT_BIAS_ENABLE      0U
#define TURN_EXIT_RIGHT_BIAS_MDEG        5000
#define TURN_EXIT_RIGHT_BIAS_TOL_MDEG    500
#define TURN_EXIT_RIGHT_BIAS_KP_DIVISOR  200
#define TURN_EXIT_RIGHT_BIAS_CORR_MIN    6
#define TURN_EXIT_RIGHT_BIAS_CORR_LIMIT  35
#define TURN_EXIT_RIGHT_BIAS_MAX_FRAMES  30U
#define GYRO_LOST_ENABLE_FRAMES          10U
#define GYRO_RATE_DIVISOR                1500
#define GYRO_RATE_CORR_LIMIT             50
#define GYRO_HEADING_DIVISOR             1000
#define GYRO_HEADING_CORR_LIMIT          30
#define GYRO_TOTAL_CORR_LIMIT            65

#define TURN_EXIT_RIGHT_HISTORY_MASK     0x70U
#define TURN_EXIT_LEFT_HISTORY_MASK      0x0EU
#define TURN_EXIT_BRAKE_CORR_TICKS       0
#define TURN_EXIT_BRAKE_MIN_FRAMES       3U
#define TURN_EXIT_BRAKE_MAX_FRAMES       15U
#define TURN_EXIT_BRAKE_STOP_RATE_MDPS   3000
#define TURN_EXIT_BRAKE_START_RATE_MDPS  1000

#define MOTOR_PORT                       GPIOB
#define AIN1_PIN                         DL_GPIO_PIN_0
#define AIN2_PIN                         DL_GPIO_PIN_1
#define BIN1_PIN                         DL_GPIO_PIN_2
#define BIN2_PIN                         DL_GPIO_PIN_3
#define STBY_PIN                         DL_GPIO_PIN_4

#define PWM_PORT                         GPIOA
#define PWMA_PIN                         DL_GPIO_PIN_12
#define PWMB_PIN                         DL_GPIO_PIN_13

#define GRAY_ADDRESS_PORT                GPIOB
#define GRAY_AD0_PIN                     DL_GPIO_PIN_5
#define GRAY_AD1_PIN                     DL_GPIO_PIN_6
#define GRAY_AD2_PIN                     DL_GPIO_PIN_7
#define GRAY_ADDRESS_MASK                (GRAY_AD0_PIN | GRAY_AD1_PIN | GRAY_AD2_PIN)

#define GRAY_OUT_PORT                    GPIOA
#define GRAY_OUT_PIN                     DL_GPIO_PIN_7

#define SERVO_PORT                       GPIOA
#define SERVO_X_PIN                      DL_GPIO_PIN_14
#define SERVO_Y_PIN                      DL_GPIO_PIN_17

#define LED_PORT                         GPIOA
#define LED_PIN                          DL_GPIO_PIN_15

#define BUZZER_PORT                      GPIOB
#define BUZZER_PIN                       DL_GPIO_PIN_11

volatile uint32_t g_firmware_version = FIRMWARE_VERSION;
volatile uint8_t g_motor_disabled = 0U;
volatile uint8_t g_buzzer_active_low = 1U;
volatile uint8_t g_buzzer_idle_level = 1U;
volatile uint8_t g_gray_test_state = 0U;
volatile uint8_t g_gray_selected_channel = 0U;
volatile uint8_t g_gray_live_out = 0U;

volatile uint8_t g_gray_raw_high_mask = 0U;
volatile uint8_t g_gray_unstable_mask = 0U;
volatile uint8_t g_gray_white_baseline_mask = 0U;
volatile uint8_t g_gray_changed_from_white_mask = 0U;
volatile uint8_t g_gray_previous_change_mask = 0U;

volatile uint8_t g_gray_x1 = 0U;
volatile uint8_t g_gray_x2 = 0U;
volatile uint8_t g_gray_x3 = 0U;
volatile uint8_t g_gray_x4 = 0U;
volatile uint8_t g_gray_x5 = 0U;
volatile uint8_t g_gray_x6 = 0U;
volatile uint8_t g_gray_x7 = 0U;
volatile uint8_t g_gray_x8 = 0U;

volatile uint8_t g_gray_x1_high_count = 0U;
volatile uint8_t g_gray_x2_high_count = 0U;
volatile uint8_t g_gray_x3_high_count = 0U;
volatile uint8_t g_gray_x4_high_count = 0U;
volatile uint8_t g_gray_x5_high_count = 0U;
volatile uint8_t g_gray_x6_high_count = 0U;
volatile uint8_t g_gray_x7_high_count = 0U;
volatile uint8_t g_gray_x8_high_count = 0U;

volatile uint8_t g_gray_all_low = 0U;
volatile uint8_t g_gray_all_high = 0U;
volatile uint8_t g_gray_mixed = 0U;
volatile uint8_t g_gray_baseline_ready = 0U;
volatile uint8_t g_gray_baseline_uniform = 0U;
volatile uint8_t g_gray_white_level_code = 2U;
volatile uint8_t g_gray_changed_count = 0U;
volatile uint8_t g_gray_line_valid = 0U;
volatile int16_t g_gray_line_error = 0;
volatile uint8_t g_gray_line_mask = 0U;
volatile uint8_t g_gray_line_abnormal = 0U;
volatile int16_t g_line_last_error = 0;
volatile int16_t g_line_last_nonzero_error = 0;
volatile int32_t g_line_correction = 0;
volatile uint8_t g_turn_mode = 0U;
volatile uint32_t g_line_lost_count = 0U;
volatile uint8_t g_line_center_confirm_count = 0U;
volatile int32_t g_line_lost_correction_limit = LINE_SHARP_CORR_LIMIT;

volatile uint32_t g_left_pwm_ticks = 0U;
volatile uint32_t g_right_pwm_ticks = 0U;
volatile uint32_t g_left_compare_ticks = PWM_PERIOD;
volatile uint32_t g_right_compare_ticks = PWM_PERIOD;
volatile uint8_t g_phase = PHASE_INIT;
volatile uint8_t g_stop_reason = STOP_REASON_NONE;
volatile uint16_t g_line_entry_confirm_count = 0U;
volatile uint32_t g_start_bridge_frame_count = 0U;
volatile uint8_t g_start_boost_active = 0U;
volatile uint32_t g_run_frame = 0U;

volatile uint16_t g_gray_baseline_scan_count = 0U;
volatile uint16_t g_gray_baseline_votes[GRAY_CHANNEL_COUNT] = {0U};
volatile uint8_t g_gray_channel_high_count[GRAY_CHANNEL_COUNT] = {0U};
volatile uint32_t g_gray_scan_count = 0U;
volatile uint32_t g_gray_change_event_count = 0U;
volatile uint8_t g_led_state = 0U;

volatile uint8_t g_mpu_state = 0U;
volatile uint8_t g_mpu_error = 0U;
volatile uint8_t g_mpu_link_ok = 0U;
volatile uint8_t g_mpu_who_am_i = 0U;
volatile uint8_t g_mpu_device_type = 0U;
volatile uint32_t g_mpu_sample_count = 0U;
volatile uint32_t g_mpu_read_fail_count = 0U;
volatile uint32_t g_i2c_error_count = 0U;
volatile int16_t g_gyro_x_raw = 0;
volatile int16_t g_gyro_y_raw = 0;
volatile int16_t g_gyro_z_raw = 0;
volatile int32_t g_gyro_z_bias_raw = 0;
volatile int32_t g_gyro_z_corrected_raw = 0;
volatile int32_t g_gyro_z_mdps = 0;
volatile int32_t g_yaw_mdeg = 0;

volatile uint8_t g_turn_was_active = 0U;
volatile uint32_t g_turn_exit_hold_count = 0U;
volatile int32_t g_turn_exit_heading_target_mdeg = 0;
volatile int32_t g_gyro_rate_correction = 0;
volatile int32_t g_gyro_heading_correction = 0;
volatile int32_t g_mpu_control_correction = 0;
volatile int32_t g_total_control_correction = 0;

volatile uint8_t g_line_mask_history_0 = 0U;
volatile uint8_t g_line_mask_history_1 = 0U;
volatile uint8_t g_line_mask_history_2 = 0U;
volatile int16_t g_line_error_history_0 = 0;
volatile int16_t g_line_error_history_1 = 0;
volatile int16_t g_line_error_history_2 = 0;
volatile uint8_t g_turn_exit_brake_active = 0U;
volatile int8_t g_turn_exit_brake_direction = 0;
volatile uint32_t g_turn_exit_brake_frame_count = 0U;
volatile uint32_t g_turn_exit_brake_trigger_count = 0U;
volatile uint8_t g_turn_exit_brake_stop_reason = 0U;
volatile uint8_t g_turn_exit_right_bias_active = 0U;
volatile uint32_t g_turn_exit_right_bias_frame_count = 0U;
volatile uint32_t g_turn_exit_right_bias_trigger_count = 0U;
volatile uint8_t g_turn_exit_right_bias_stop_reason = 0U;
volatile int32_t g_turn_exit_right_bias_error_mdeg = 0;
volatile int32_t g_turn_exit_right_bias_correction = 0;

static NOINLINE void delay_cycles_rough(uint32_t cycles)
{
    volatile uint32_t i;

    for (i = 0U; i < cycles; i++) {
        __asm volatile("nop");
    }
}

static NOINLINE void delay_us_rough(uint32_t us)
{
    delay_cycles_rough(us * DELAY_LOOPS_PER_US);
}

static NOINLINE void delay_ms_rough(uint32_t ms)
{
    for (uint32_t i = 0U; i < ms; i++) {
        delay_us_rough(1000U);
    }
}
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
