jlg006728/electronic-design-contest/(commit log)

2026-05-11 feat: 初始化电赛知识库 — 2025年E题复刻
    完整知识库覆盖8大类别：MCU、巡迹传感器、电机驱动、舵机云台、
    视觉模块、激光模块、电源方案、差速运动学、PID算法、通信协议。
    包含MSPM0开发指南和EVM用户指南的PDF及目录索引。
2026-05-11 docs: 添加仓库首页 README.md
    包含项目简介、仓库结构、器件速查、控制架构图、快速开始指南。
2026-05-11 docs: 添加 E题器件采购清单 (BOM)
    9大类别 41项器件，总预算约 ¥1,115。含规格/数量/渠道/优先级。
2026-05-11 feat: 添加 MSPM0 SDK 2.10.00.04 示例代码 (174个)
    包含 driverlib (141) + msp_subsystems (32) + out_of_box demo，附带 E题相关度索引 README
2026-05-12 docs: 更新器件采购清单及采购链接汇总
    - 器件采购清单: 新增按键分析说明, 合并小车底盘为WHEELTEC套件
    - 新增器件采购链接汇总.md, 含具体淘宝链接与所选款式
    - 新增CCS工程 e_car (17个源文件)
2026-05-23 feat: 修正引脚分配 + 添加硬件接口图及E题赛题文档
    - 修正 config.h 和 e_car.syscfg 中 12 处引脚映射错误
    (PA0-PA6非ADC, TIMG2不存在, PA12冲突等)
    - 添加硬件接口图.md: 完整接线方案、电源设计、分步上电验证流程
    - 添加知识库/E题赛题完整要求.md: 从赛题图片提取的完整要求
    - 补全知识库3处空档(TCRT5000电路, TB6612接线, MG90S配置)
    - 添加 tcrt5000/ 模块参考资料
    [config.h]
2026-05-23 fix: 修正硬件接口图供电方案与验证流程 (5处逻辑漏洞)
    - 舵机供电从TB6612板载5V改为MP1584独立3A供电 (原方案峰值1.8A超载)
    - OpenMV供电从3.3V改为5V (VIN经LDO需≥3.6V)
    - 激光供电从5V改为3.3V
    - 新增第七节: 巡线模拟vs数字方案、UART0调试冲突、保护电路、共地要求
    - 修正验证流程: 示波器改为可选项、补充J21/J22跳线操作说明
    - 数据手册交叉验证: PA3/PA4 TIMG8_C0/C1、PA10/PA11 UART0 均正确
2026-05-28 docs: 添加接线步骤、电机测试程序及CCS操作指南
2026-07-02 docs: archive contest progress and handoff
    [MSPM0_SDK_syscfg_menu_import.cfg]
2026-07-02 test: add single servo tb6612 power check
2026-07-02 test: switch servo check to pa3 signal
2026-07-09 feat: add OpenMV black-frame UART tracking
